dries007/ModernMasterMind/README.md

ModernMasterMind
================
College project E-ICT 1 - 2015

Information
-----------
The purpose of this project is to imitate the classic board game Mastermind with a web interface and an LED screen/display.
This project was developed with the help of the RIOT board, made by MGM & [dp].

This repository contains the source code and documentation for the 'Beck SC12' and 'AVR Atmega128A', information about the dual port memory usage, and more related items.

Some parts of this repository are in Dutch.

License
-------
This project's code is licensed under [the MIT License (MIT)](LICENSE).

Made for/in relation to an education at Thomas More Mechelen-Antwerpen vzw - Campus De Nayer - Professionele bachelor elektronica-ict
