dries007/ModernMasterMind/Flowcharts.docx

Beck SC12

AVR ATmega128A

Webui

DPRAM

LCD

LEDs
