dries007/ModernMasterMind/Verslag/Verslag_Dries_Kennes.pdf

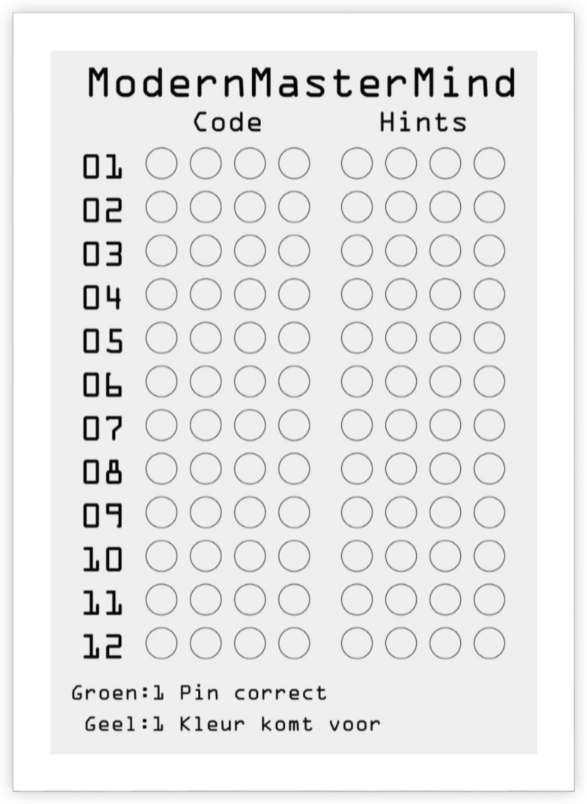
[picture p28: figure]

Dries Kennes | Project I | 2014-2015

# ModernMasterMind

## PROJECT I – ICT-ELEKTRONICA

## 1 Voorwoord

Ik ben Dries Kennes, student ICT-Elektronica Fase 1 aan Thomas More Mechelen op Campus De Nayer. Mijn voornaamste interesses zijn elektronica en alles wat te enigszins programmeren valt. Online ga ik door het leven als Dries007, een enthousiaste Java programmeur die zich in zijn vrije tijd vooral bezighoud met het maken van build-to-order Minecraft mods.

Tijdens de kerstvakantie ben ik op zoek gegaan naar projectonderwerpen. Vorig jaar (6e jaar middelbaar) wilden wij tijdens de lessen elektronica met een Arduino en een LED matrix spelletjes maken. Helaas was het juiste materiaal niet tijdig beschikbaar. Daarom heb ik er dit jaar voor gekozen om één van die spellen uit te werken. Het werd Mastermind omdat dit een uitdaging leek, onder andere dankzij de vereiste om kleuren te kunnen weergeven.

Mijn contacteren kan via email, dries.kennes@student.thomasmore.be, of via mijn website, dries007.net.

Ten slotte wil ik Marc Roggemans bedanken voor het uitlenen van materiaal en Jurre De Weerdt voor het helpen met solderen van enkele SMD onderdelen.

## 2 Inhoud

## 3 Hardware

## 3.1 RIOT

RIOT staat voor Remote Internet Operated Terminal, en is een ontwerp van M. Roggemans en
D. Pauwels. RIOT werd ontworpen als educatief platform in 2002, maar is eigenlijk nooit gebruikt. Meneer Roggemans heeft tijdens de lessen interfacetechnieken dit platform wel aangehaald, en zo kreeg ik interesse om dit te gebruiken. Ik kreeg toegang tot de bordjes na de examens na de kerstvakantie, zodat ik hiermee kon experimenteren, en zien of ze bruikbaar zouden zijn als basis voor mijn project. Het gebruiken van een 10+ jaar oud platform zorgt voor een aantal hindernissen, meer hierover in het hoofdstuk ‘De SC12 Software’.

Meer informatie over RIOT is beschikbaar op Telescript¹

## 3.2 Het basisprincipe

Het basisprincipe van RIOT (en dus ook mijn project) is dat 2 controllers met elkaar communiceren via een gedeeld geheugen (een Dual Port RAM, voortaan DP-RAM). Dit geheugen heeft een aantal ‘gewone’ adressen die vrij kunnen worden gebruikt, en 2 interrupt adressen. De interrupt adressen worden gebruikt om, zoals de naam al doet raden, van de ene controller naar de andere een interrupt te genereren. De controllers zijn een Beck SC12 en een AVR ATMega128A.

De reden voor het gebruiken van een dergelijk systeem is in dit geval de hoeveelheid IO verhogen. De SC12 heeft namelijk een zeer beperkte hoeveelheid IO, die vooral op pinnen zit die al door andere functies in gebruikt zijn (bijvoorbeeld UART of I²C). De SC12 heeft echter wel een gemultiplexte 8 bit data/adres bus, waarmee een extern geheugen van 256 bytes kan worden aangesproken. Door 2 IO pinnen te gebruiken als adres lijnen 8 en 9 kan het aanspreekbare geheugen worden uitgebreid tot 1kb (4 pages van 256 bytes).

Aangezien een Mastermind spelbord 12 rijen heeft van 8 gekleurde (RGB) pionnen, dit zijn in totaal dus 12 x 8 x 3 = 288 bytes is dit trucje geen overbodige luxe. Als men dan nog op een eenvoudige manier een LCD wil aansturen (20 karakters x 4 lijnen) heeft men nog eens 80 bytes nodig. Uiteindelijk zou 512 bytes genoeg zijn geweest, maar een DP-RAM chip met 1kb is commercieel beschikbaar, 512 bytes niet.

Aangezien de adres- en databus van beide controllers gemultiplext zijn, is het nodig om een adres latch te gebruiken. Ik gebruik 74AHC573 chips aangezien die aan de timingsspecificaties van de ATMega128A voldoen.

Voor de LEDs gebruik ik WS2812 LEDs. Deze LEDs zijn ideaal voor dit project omdat ze, ongeacht de hoeveelheid LEDs, maar 1 pin op een (relatief snelle) controller nodig hebben. Ze worden namelijk allemaal in serie geschakeld. De werking van het protocol wordt uitgelegd in het hoofdstuk ‘Het WS2812 protocol’.

1
ftp://193.191.150.44/pub/CD-Microcontrollers/RIOT/

## 3.3 De PCBs

Op mijn versie van het bord zijn onnodige onderdelen weggelaten. Onder andere de UART naar RS232, de Real Time Clock en het voedingscircuit moesten er aan geloven.

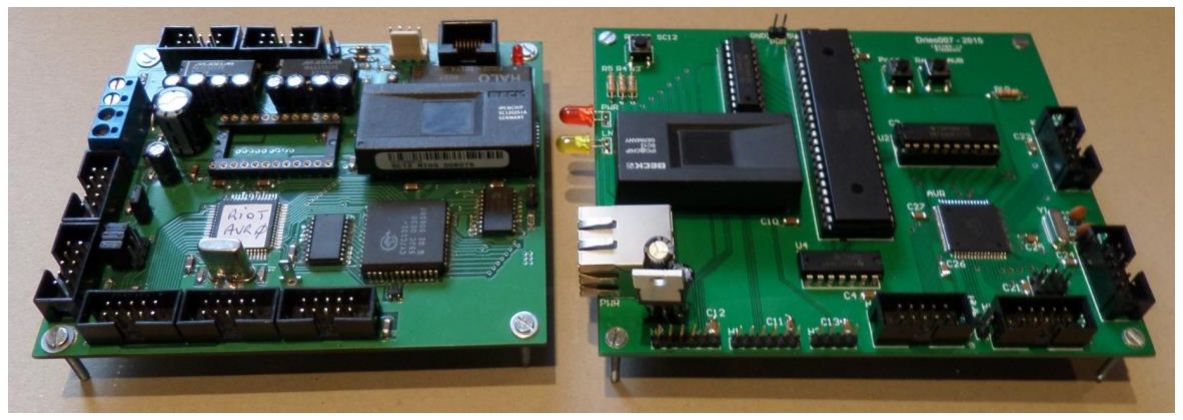
[picture p29: figure]

Figuur 3.1 RIOT links, Eigen PCB rechts

De PCBs zijn getekend met Altium. Het main bord en de LCD breakout zijn besteld bij Seedstudio, het LED panel bij multi-cb. De bestukking was manueel. De volgende fouten heb ik achteraf (tijdens het testen of solderen) ontdekt:

- De databus van het DP-RAM naar de AVR is in omgekeerde volgorde (de bits zitten omgekeerd).
- De WS2812 LEDs passen maar net op de getekende footprint, wat wil zeggen dat ze bijna onmogelijk met een gewone soldeerbout soldeerbaar zijn. Gelukkig heb ik op school hulp gekregen, en mocht ik een warme lucht soldeerstation gebruiken.

Het volledige schema en de layout van de PCBs is beschikbaar in de bijlage ‘PCB Schema’s & Layout’.

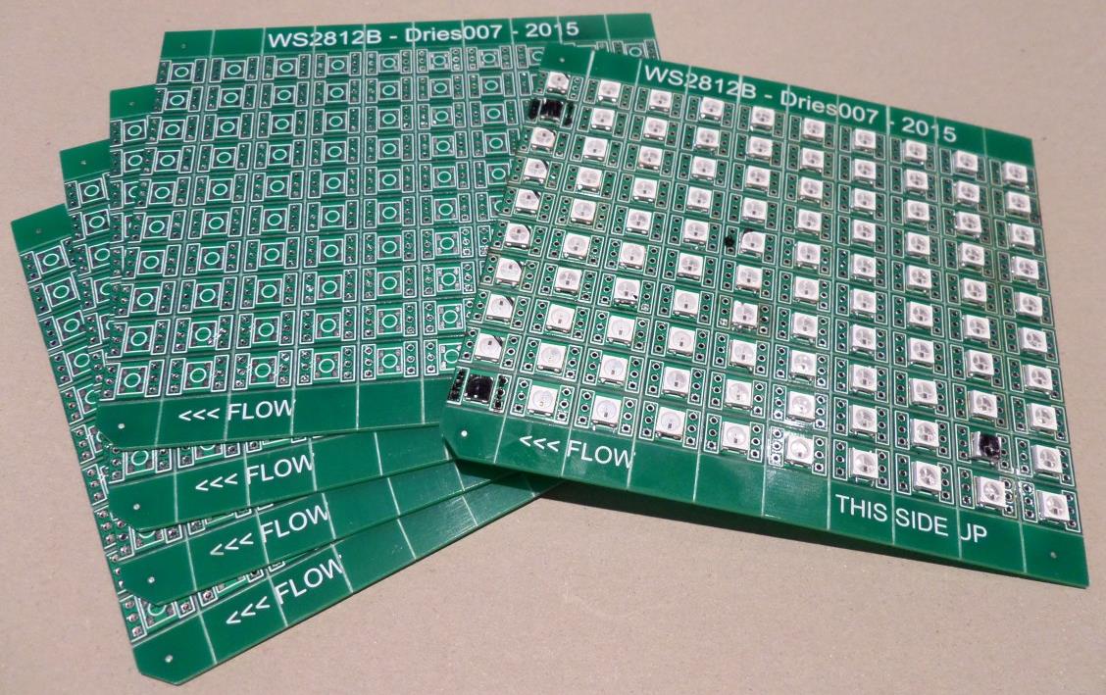
[picture p30: figure]

Figuur 3.2 Het LED panel

## 3.4 Overige onderdelen

Omdat de LEDs in totaal 96 x 60mA = 5,7 A verbruiken heb ik gekozen voor een commercieel verkrijgbare voeding van 35W.

De LCD module is een blauw alfanumeriek model, met een Hitachi HD44780 compatibele controller. De module zit op een zelf ontworpen printplaat die een 8 pin poort omzet naar de juiste pinout voor de LCD en nog wat extra plaats heeft voor het aansluiten van de achtergrondverlichting.

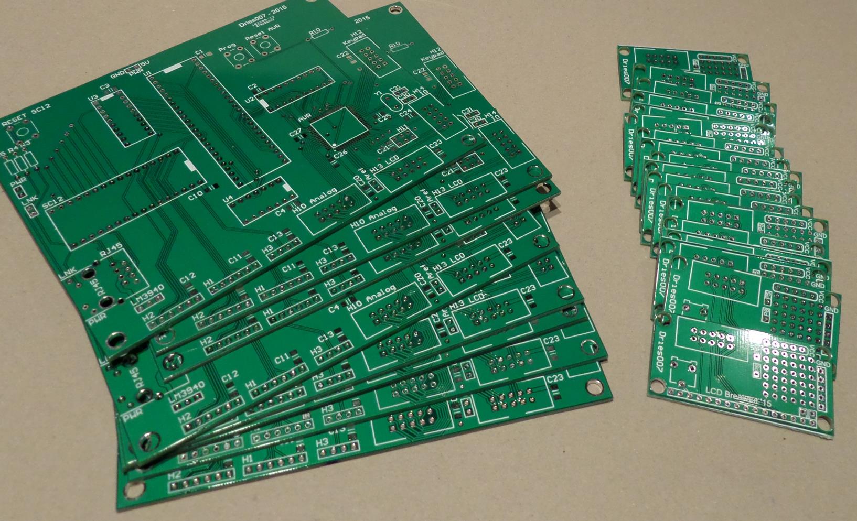
[picture p31: figure]

Figuur 3.3 Links: De hoofd printplaten. Rechts = De lcd printplaten

## 4 Software

## 4.1 De memory map

Dit is de verdeling van het DP-RAM. De 2 interrupt adressen liggen vast, namelijk 0x3FE en 0x3FF. Alle andere locaties zijn vrij gekozen.

Er is extra plaats voorzien bij de LED data en bij de LCD buffer om te vermijden dat die verplaatst zouden moeten worden indien er zich kleine veranderingen voordoen in de specificaties.

Adres Functie
0x000 -> 0x1FE | RGB data voor maximaal 170 LEDs
0x1FF | Aantal LEDs
0x200 -> 0x250 | LCD buffer (80 karakters)
0x251 | LCD commando
0x252 | LEDs dim
0x253 | Laatst ingedrukte toets op keypad†
0x254 -> 0x299 | Beschikbaar
0x300 & 0x301 | Firmware id (42 en 0x42 respectievelijk)
0x302 -> 0x3FD | Beschikbaar
0x3FE | Interrupt SC12 -> AVR
0x3FF | Interrupt AVR -> SC12†

Tabel 4.1 De geheugenallocatie van het DP-RAM †: enkel gebruikt voor debug

## 4.2 Het WS2812 protocol

De WS2812 LEDs werken als een lange serie schakeling, waarbij elke led de eerste 24 bits gebruikt om zijn kleur in te stellen. De andere bits worden doorgegeven, zie Figuur 4.1. De volgorde van de bits is niet RGB, maar GRB, met hoogste bit eerst.

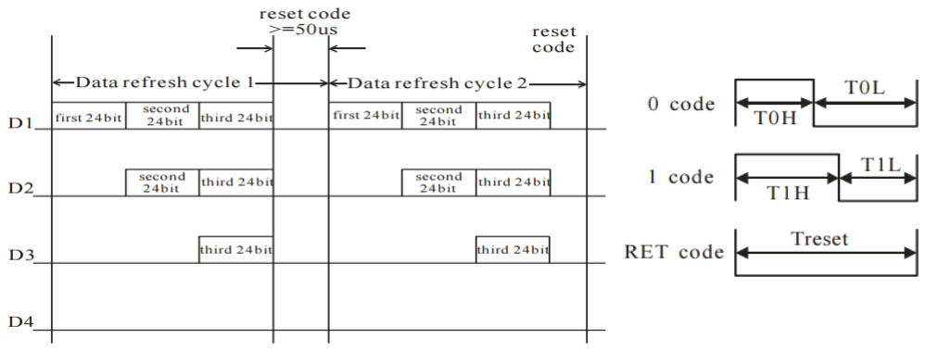
[picture p32: figure]

Figuur 4.1 LED cascading & timing diagram

Code | Betekenis | Tijd | Min | Typ | Max
T0H | 0 code - high voltage time | 0,35 µs ±150 ns | 200 ns | 350 ns | 500 ns
T1H | 1 code - high voltage time | 0,70 µs ±150 ns | 550 ns | 700 ns | 850 ns
T0L | 0 code - low voltage time | 0,80 µs ±150 ns | 650 ns | 800 ns | 950 ns
T1L | 1 code - low voltage time | 0,60 µs ±150 ns | 450 ns | 600 ns | 750 ns
Reset | low voltage time | > 50µs | 50 µs
TH+TL | Cyclus time | 1,25µs ±600ns | 660 ns | 1250 ns | 1850 ns

Tabel 4.2 De timing tabel uit de datasheet, met genormaliseerde waarden

De software driver die vaak voor de ze LEDs word gebruikt (Adafruit NeoPixel Library²
) is
ingewikkeld, geschreven in C++ en geschikt voor zowel 8, 12 als 16 MHz Arduino’s. Na verder zoeken vond ik een aantal interessante artikels³ die de timing van de LEDs analyseren.

Uit hun analyse blijkt dat de timing eigenlijk niet zo restrictief is als lijkt uit de datasheet. De enige kritieke tijd blijkt T0H te zijn, en die is net haalbaar op 4MHz (500ns * 4MHz = 2 klokcycli). Alle andere timing restricties zijn langer, en kunnen dus met nops worden ingevuld.

Uiteindelijk heb ik ervoor gekozen een aangepaste versie van de light_ws2812 library⁴
te
gebruiken. Dit is de code die word beschreven in een van de artikels. Ze is simpel en
eenvoudig te begrijpen. De driver word verder beschreven in De WS2812 driver.

2 github.com/adafruit/Adafruit_NeoPixel
3 wp.josh.com/2014/05/13/ws2812 en cpldcpu.wordpress.com/2014/01/14/light_ws2812-4 github.com/cpldcpu/light_ws2812/tree/master/light_ws2812_AVR/Light_WS2812

## 4.3 De AVR software

De software in de AVR is geschreven in C, met uitzondering van de WS2812 driver die in inline assembly is geschreven. Voor de gebruiksvriendelijkheid zijn alle configuratie opties bovenaan in de header file als macro’s gedefinieerd. De code is voorzien van commentaar en sectie aanduidingen om groepen van bij elkaar horende functies te groeperen. De volledige header-en codebestanden zijn terug te vinden in de bijlage als respectievelijk ‘AVR.h’ en ‘AVR.c’. De regelnummers hieronder zijn, tenzij anders aangegeven, deel van ‘AVR.c’.

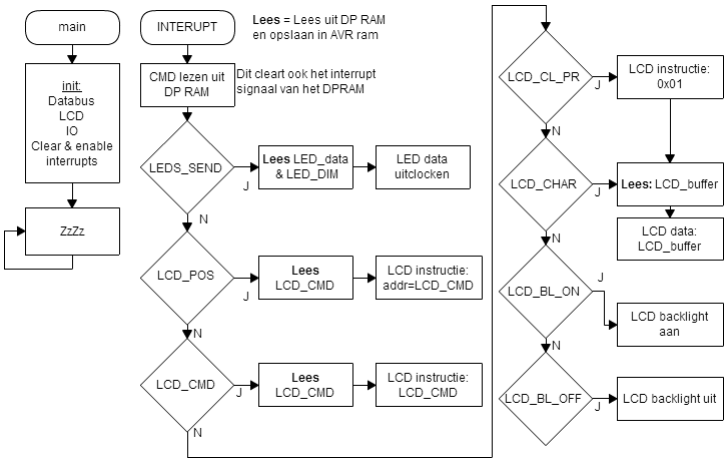
[picture p33: figure]

Figuur 4.2 De AVR flowchart

### 4.3.1 Het hoofdprogramma (main)

Het hoofdprogramma in de AVR doet niet veel meer dan een aantal initialisaties en wacht dan om een interrupt van het DP-RAM.

- De externe memory interface (adres- en databus) wordt ingeschakeld. R259
- De Firmware ID adressen in het DP-RAM worden op 42 en 0x42 gezet. R262-263
- De LCD poort word ingesteld als uitgang. R266
- De LED pin word ingesteld als uitgang. R272-273
- Externe interrupt 4 word geconfigureerd. R276-277
- De LCD word geïnitialiseerd in 4 bit mode. R279-294
- Lees DP-RAM 0x3FE om mogelijke interrupt te resetten. R297
- Schakel interrupts in.

Dan gaat het programma in een lus, wachtend op een interrupt.

### 4.3.2 De interrupt routine

Deze interrupt routine voert uit wanneer de DP-RAM een schrijf instructie heeft verwerkt naar het adres 0x3FE vanuit de SC12. Hoe de AVR juist reageert is afhankelijk van wat er naar dit adres geschreven wordt. Aangezien het hoofdprogramma niets doet in dit project, is het geen enkel probleem om in de interrupt routine software delays te gebruiken.

Waarde Functie
0x00 | Geen functie
0x01 | Update LEDs
0x02 | Print LCD karakter buffer (tot max of 0x00)
0x03 | Stuur LCD instructie
0x04 | Stuur clear instructie en print LCD karakter buffer
0x05 | Zet LCD cursor positie op LCD commando
0x06 | LCD backlight aan
0x07 | LCD backlight uit

Tabel 4.3 De commando’s van de SC12 naar de AVR

4.3.2.1 0x00 of een waarde die niet voorkomt in de tabel– Geen functie

De null byte (0x00) is expliciet gereserveerd om niets te doen (buiten het activeren van mogelijke debug code). Alle andere combinaties kunnen worden gebruikt voor extra functies.

4.3.2.2 0x01 – Update LEDs

- Lees aantal LEDs. R24
- Lees LED dimmer waarde. (0xFF = volle sterkte) R26
- Check aantal LEDs met logisch maximum bepaald door geheugen allocatie. R28
- Loop over de volgende instructies voor elke LED: R30-31
| • Voor 3 x LED kleur (rood, groen en blauw): R33 & 34 & 35 ▪ Lees volgende byte uit LED data in DP-RAM. ▪ Voer logische AND uit op die byte en LED dimmer waarde. ▪ Sla waarde op in LED data array
- Geef deze data door aan de WS2812 driver. R38

4.3.2.3 0x02 – Print LCD karakter buffer

- Loop over de volgende instructies tot het einde van de karakter buffer: R63
| • Lees volgende byte uit karakter buffer in DP-RAM. R65 • Als karakter een 0x00 byte is, beëindig de lus onmiddellijk. R66 • Stuur de byte naar de LCD driver. R67

4.3.2.4 0x03 – Stuur LCD instructie

- Lees LCD commando byte uit DP-RAM en stuur die naar de LCD driver. R50

4.3.2.5 0x04 – Stuur clear instructie en print LCD karakter buffer

- Stuur een clear & home instructie (0x01) naar LCD driver. R56
- Wacht 10ms. R57

- Voer de code uit die bij 0x02 – Print LCD karakter buffer hoort. R59

4.3.2.6 0x05 – Zet LCD cursor positie op LCD commando

Aangezien een positie instructie er zo uitziet: “1aaa aaaa” Waarbij de a’s staan voor een positie op de LCD, kan men een positie byte met een logische OR omzetten naar de juiste instructie:

- Lees LCD commando byte uit DP-RAM, OR met 0x80, stuur naar LCD driver. R44

4.3.2.7 0x06 of 0x07 –LCD backlight aan of uit

Dit commando zet een interne byte op 1 of 0, respectievelijk voor aan en uit. De volgende keer dat er iets met de LCD driver word gedaan, heeft de verandering effect.

### 4.3.3 De LCD driver

De LCD driver bestaat uit een aantal subroutines, aangezien de LCD in 4 bit bus mode wordt gebruikt. De instructie of data bytes moeten dus in 2 x 4bit nibbles worden gesplitst en dan pas verzonden.

De volgende stappen worden doorlopen bij het versturen van 1 nibbel:

- Filter de data zodat enkel de laatste 4 bits overblijven. R440
- Als het LCD backlight aan moet, set de 8e bit op 1. R442
- Als het een instructie is, zet de 6e bit op 1. R444
- Zet de data op de LCD port. R448
- Wacht 800µs. R450
- Toggel de enable pin. R452
- Wacht 800µs. R454

### 4.3.4 Debug code

In de broncode staan ook nog delen debug code die tijdens het opbouwen van dit project werden gebruikt om zonder de hulp van de SC12 de LED en LCD drivers te kunnen testen.

Zo staat er onder ander een volledige matrix keypad met debounce subroutine, in die bedoeld is om als main programma te draaien.

Aangezien die niet in gebruik is in het eindproduct, en de code voorzien is van commentaar, wordt ze hier niet verder besproken.

Meer details in onder andere:

- R83 tot R184 voor een test aansturing van de LEDs,
- R192 tot R247 voor de matrix keypad uitlezing met debounce,
- R302 tot R328 voor de omzetting van matrix naar ASCII.

### 4.3.5 De WS2812 driver

In de header file AVR.h wordt berekend hoeveel klokcycli de CPU niets zal moeten doen tussen het toggelen van de LED pin. Deze berekening gebeurd in AVR.h R88-160 en is afhankelijk van de klokfrequentie van de AVR. Daarom is het belangrijk dat deze correct word ingesteld in de compiler settings. Deze vooraf berekende waarden worden w1_nops, w2_nops, w3_nops en w4_nops genoemd, hoewel het niet enkel NOP instructies bevat. Men kan namelijk 2 sequentiële NOP instructies vervangen door 1 RJMP instructie met een offset van 0. Dit komt de programmagrootte te goed.

De volgende stappen worden doorlopen bij het verzender van data naar de LEDs:

- Bepaal de totale lengte in bytes van de te verzenden data. R345
- Zet de data om van de GRB struct naar bytes. R347
- Sla huidige interrupt instellingen op. R350
- Zet verdere interrupts uit. R352
- Bepaal de high en low masks (maskhi & masklo) voor de LED poort. R354-358
- Voor elke byte in de totale lengte: R362
- Neem volgende data byte. R364
Hier start de inline ASM
- Laad 8 in loopcounter (8 bits in een byte). R367
- Loop label. R368
- Zet maskhi op LED poort. (Toggelt de LED pin hoog) R370
- Vooraf bepaald aantal NOPs w1_nops. R371-385
- Sla de volgende instructie over als de 7e bit van de data 1 is. R386
- Zet masklo op LED poort. (Toggelt de LED pin laag) R370
- Shift data naar links R389
- Vooraf bepaald aantal NOPs w2_nops. R390-404
- Zet masklo op LED poort. (Toggelt de LED pin laag) R405
- Vooraf bepaald aantal NOPs w3_nops. R406-420
- Verminder loopcounter met 1. R421
- Als loopcounter niet 0 is, spring terug naar Loop label. R423 Einde inline ASM
- Herstel de interrupt instellingen. R432
- Wacht 50µs (om andere data op de LED pin te vermijden) R433.

## 4.4 De SC12 Software

De software in de SC12 is ook geschreven in C, maar omdat er geen IDE voor is, gebruikte ik Eclipse Cpp. De compiler was een groter probleem, aangezien deze controller uit 2002 komt. In de documentatie van de fabrikant word verwezen naar Borland C, maar die draait niet op een 64bit host machine, en ondersteund geen moderne versie van de C standaard. Dit maakt ermee programmeren enkel mogelijk in een virtual machine, en met de verouderde C structuur.

Na een zoektochtje op het internet⁵ kwam ik OpenWatcom tegen. OpenWatcom ondersteund ook geen 16 bit target op een 64 bit Windows machine, maar wel op Linux. Ik heb een Linux server ter beschikking, en een script om vanuit Eclipse een nieuwe versie te uploaden, compilen en naar de SC12 te sturen is snel geschreven. De scripts die ik heb gebruikt zijn beschikbaar in de bijlage ‘Scripts’.

Een belangrijk nadeel van OpenWatcom, waar ik pas helemaal op het einde van mijn project ben achter gekomen is dat de manier waarop interrupt routines worden gedefinieerd anders zijn. Ik ben hierover geen duidelijkheid gevonden, en kan dus geen interrupt van de AVR naar SC12 correct opvangen.

Een ander handig stukje software is ChipTool⁶
. Dit tooltje laat je toe om het IP adres van een SC12 chip in te stellen door middel van UDP packets. Ook het uploaden van de laatste versie van hun firmware word zo eenvoudig. Chiptool heeft een ingebouwde telnet en FTP client, maar deze zijn niets in vergelijking met modernere versies van zulke programma’s zoals PuTTY of FileZilla.

De uitbreiding van de standaard C library die bij deze controller hoort is cLib. De
documentatie hiervan is beschikbaar op www.beck-ipc.com. Hier zijn ook voorbeeldprogramma’s en programmer guidlines beschikbaar.

Aangezien er een real time besturingssysteem draait op de SC12 kunnen er meerdere taken tegelijk worden uitgevoerd. Dit zijn de standaard taken: een ftp server, een telnet server, een webserver en een udp configuratie server.

De standaard webserver heeft enkel een welkompagina (/) en een statuspagina (/ChipCfg) beschikbaar. Via cLib functies kunnen zonder veel moeite extra ‘pagina’s’ worden toegevoegd. Bestanden die worden geüpload naar het flash geheugen kunnen ook worden opgevraagd als URL. Het probleem met dit is dat het dan moeilijker word om programmatisch het gedrag van de controller aan te passen. In dit project staat dus de volledige code van de webpagina’s, inclusief de CSS style sheet, gecomprimeerd in de C code. Omdat dit bijna onleesbaar is heb ik in de bijlage ‘HTML Template’ het origineel template bijgevoegd.

De flowcharts op de volgende pagina worden verder in detail uitgelegd in de volgende onderdelen. De regelnummers daarin duiden op ‘mastermind.c’.

5
stackoverflow.com/questions/227762/looking-for-16-bit-x86-compiler 6 beck-ipc.com/en/products/sc1x/sc13.asp

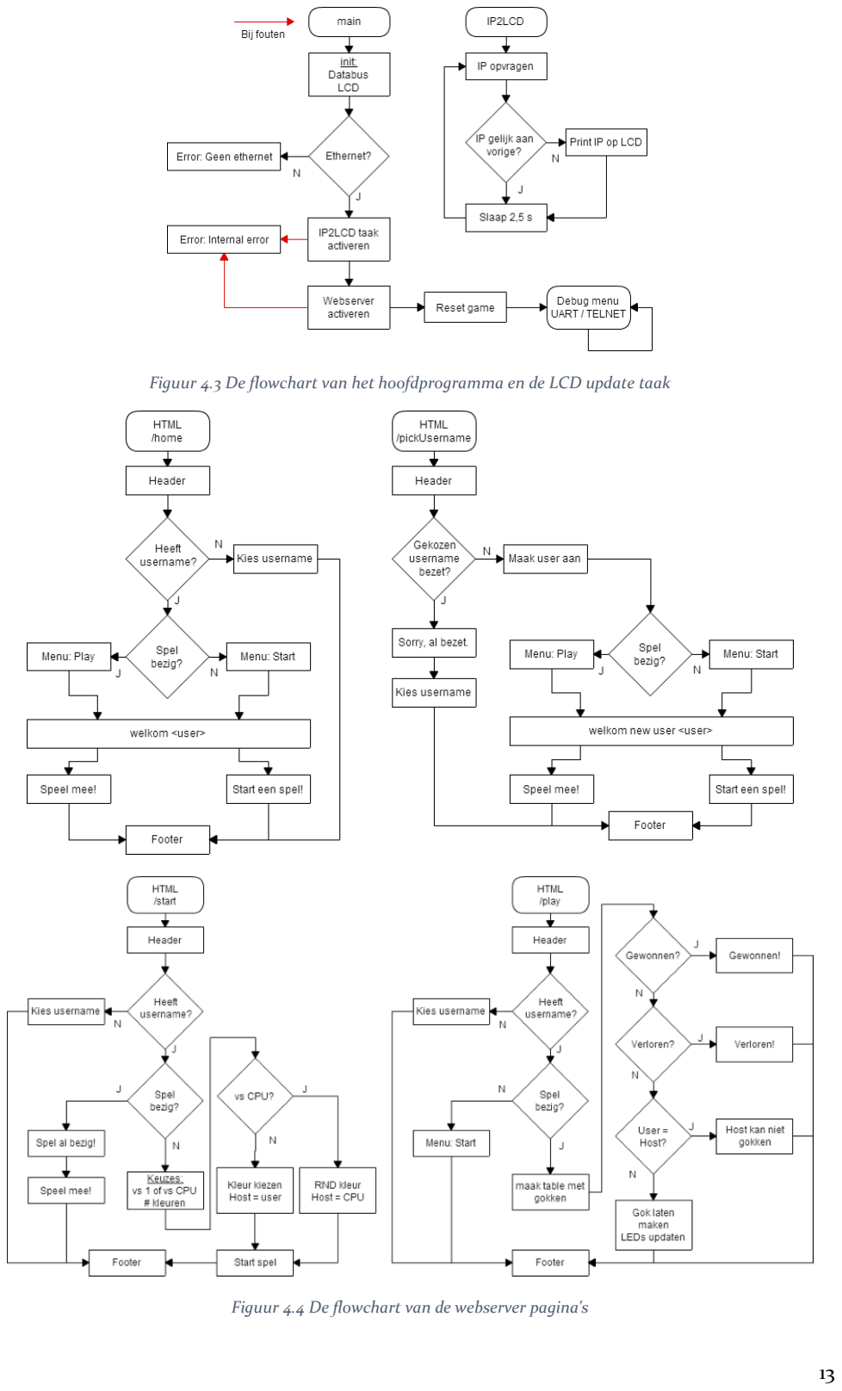
[picture p34: page 14]

Figuur 4.3 De flowchart van het hoofdprogramma en de LCD update taak

Figuur 4.4 De flowchart van de webserver pagina's

### 4.4.1 Het hoofdprogramma

- Activeer het programma als focus. R439
Zorgt ervoor dat er input kan worden gegeven, en dat de controller ook effectief wacht bij een input instructie.
- Initialiseren van de databus. R444
8 bit met ALE, Chip select 1 word geactiveerd en IO2 en 3 zijn output R132-135
- Vaste instellingen worden in het DP-RAM geladen:
- LCD backlight aan, R446
- LED Dim op 100% (0xFF), R448
- Aantal LEDs op 2 * 12 * 4 = 96, R449
- LCD commando’s worden uitgevoerd:
- Blink uit, R451
- Clear lcd en cursor reset. R452
- AVR Firmware naar console. R456
- Status melding naar LCD. R459
- De ethernet status word gecontroleerd.
Bij een fout (geen kabel?):
- Melding naar LCD. R464-465
- Voer eeuwig testcode uit.(zie debug menu hieronder) R467-470
- Start de taken op die in de achtergrond moeten draaien. R478-486 Enkel IP2LCD, maar kan eenvoudig worde uitgebreid.
- Configureer de webserver R992-1021
- Reset de status van het spel. Komt later nog aan bod.
- Geef een debug/console menu weer. R502-543
Dit wordt oneindig herhaald, en bied o.a. de mogelijkheid om:
- Het programma beëindigen, R372-391
- De controller herstarten,R522
- Het DP-RAM dumpen, R20-60 van ramdump.c
- Een adres van het DP-RAM op een waarde zetten, R1-20 van ramdump.c
- De status van het spel dumpen, R413-434
- De gebruikerstabel dumpen, R53-72
- Testcode uitvoeren, R393-411
Deze code toont een semi random patroon van kleuren op het led scherm.

### 4.4.2 IP2LCD

Deze taak zorgt ervoor dat het IP adres op de LCD verschijnt, en up-to-date is.

- Vraag het IP op. R342
- Vergelijk het nieuwe IP met het vorige IP. R344
Als ze niet gelijk zijn, print het nieuwe IP naar de LCD.
- Wacht 2,5 seconden. R349

### 4.4.3 De webpagina’s

De webpagina’s worden opgebouwd er naar de juiste url te surfen. De mogelijke urls zijn: “/home”, “/pickUsername”, “/start”, “/play”, “/reset”. Om verschillende gebruikers te identificeren wordt het IP adres aan een username gekoppeld.

Alle pagina’s hebben een header en footer. Die zijn in de gedetailleerde weergave hieronder niet toegevoegd omdat ze altijd hetzelftde zijn.

4.4.3.1 /home

Dit is de standaard locatie van de webserver.

- Gekende gebruiker?
| • Neen ▪ Voeg leeg menu toe. R630 ▪ Voeg pickusername template toe. R631 • Ja ▪ Is spel bezig?
- Ja: Voeg menu toe met optie “play”. R635
- Neen: Voeg menu toe met optie “start”. R637
| ▪ Voeg welkom toe aan pagina. R639-641

4.4.3.2 /pickUsername

Deze url word gebruikt om de POST response van het pickUsername template af te handelen.

- Vind argument “username”: R668-670
| • Komt er al een user met die naam voor? R672 ▪ Ja
- Voeg leeg menu toe. R674
- Voeg melding toe, met pickUsername formulier. R676-681
| ▪ Neen
- Voeg user toe aan lijst. R685
- Is spel bezig?
- Ja: Voeg menu toe met optie “play”. R687
- Neen: Voeg menu toe met optie “start”. R689
- Voeg boodschap toe. R691-693

4.4.3.3 /reset

Pagina word gebruikt om spel te herstarten. Kan enkel worden uitgevoerd bij einde spel.

- Nieuwer gebruiker?
| • Voeg leeg menu toe. R630 • Voeg pickusername template toe. R631
- Spel status:
| • Gameover of gewonnen: R971 ▪ Reset spel & geef boodschap weer. • Andere: R979 ▪ Error boodschap.

4.4.3.4 /start

Dit is de pagina die gebruikt word om een spel te starten

- Nieuwer gebruiker?
- Voeg leeg menu toe. R630
- Voeg pickusername template toe. R631 Einde van de functie.
- Spel al bezig?
- Voeg menu toe met optie “play”. R810
- Voeg boodschap toe. R811
Einde van de functie.
- Zoek argument “mode”. R737
- Zet spel eigenschap “vsPlayer”. R739
- Zet spel status op deels geconfigureerd.
- Zoek argument “colors”. R742
- Zet spel eigenschap “colors” op aantal kleuren. R744
- Zet spel status op gestart.
- Overige argumenten:
- Zet overeenkomstige code pin op kleur. R749-751
- Zet spel status op spel gestart. R752
- Spel status:
- Deels geconfigureerd? R756
- Spel in vsPlayer mode? R759
- Ja
- Set game host op huidige user. R761
- Voeg leeg menu toe. R762
- Voeg “kies code” formulier toe. R765-780
- Neen
- Voeg menu toe met optie “play”. R784
- Stel random kleur in. R189-196
- Zet spel status op gestart. R787
- Gestart? R790
- Voeg menu toe met optie “play”. R792
- Gereset? R795
- Voeg leeg menu toe. R797
- Voeg “nieuw spel” formulier toe. R798-805

4.4.3.5 /play

Dit is de belangrijkste pagina, gebruikt voor het spelen van het spel.

- Nieuwer gebruiker?
- Voeg leeg menu toe. R630
- Voeg pickusername template toe. R631
Einde van de functie.
- Spel status: Nog niet gestart?
- Voeg menu toe met optie “start”. R844 Einde van de functie

- Voeg leeg menu toe
- Spel status: Spel gestart R851
- Zoek argumenten van de gok kleur
- (1 keer) Verhoog aantal gokken R863
- Stel gok in. R864
- Als er een gok is geweest: Bereken de hints voor de gok. R866 Gebruikt subroutine die hieronder is verklaard.
- Maak tabel met gokken. R869-895
- Spel status?
- Game over
- Voeg boodschap toe. R900
- Game won
- Voeg boodschap toe. R905
- Is spel host huidige speler? R909
- Voeg boodschap toe. R911
- Spel gestart
- Voeg “gok” formulier toe. R917-R935
- Anders?
- Code nog niet gekozen. R940

4.4.3.5.1 Gok subroutine

Deze subroutine verwerkt een gok. Een ‘pin’ is een van de 4 plaatsen in de code/gok. ‘In gebruik’ wil zeggen dat deze plaats (in de code) reeds is gebruikt om een hint te geven.

- Is het aantal gokken gelijk aan of groter dan 12? R200
- Zet spel status op Game over. R202
| Einde van de functie
- Voor alle 4 pinnen in de gok: R209
- Komt pin overeen met zelfde positie in code? R212
| ▪ Ja • Is pin al ‘in gebruik’? R214
- Aantal kleur matchen verminderen. R216
| • Zet pin op ‘in gebruik’. R219 • Verhoog aantal exacte matchen. R220 • Is aantal exacte matchen 4? R221
- Zet spel status op Game won R223
| ▪ Neen • Voor alle 4 posities in de code: R228
- Komt de gok pin overeen met deze code pin en is de code pin nog niet gebruikt? R230
- Zet pin op ‘in gebruik’. R232
- Verhoog aantal kleur matchen. R233
Einde 2e
lus.
- Stuur LED informatie uit. R152-162

## 5 Budget

Dit zijn de kosten aan dit project:

Naam Kostprijs

100 x WS2812 Breakout print | € 23
LCD module | € 7
LCD Breakout | € 1
Main PCB | € 8
100 x WS2812b | € 12
35W 5V PSU | € 10
1kbyte DPRAM | € 7,5
AVR ATMega128A | € 8,5
Ethernet Magjack | € 3
Kader | € 15
Andere componenten | € 15

Totaal € 110

## 6 Besluit

Na 10 weken werken aan mijn project heb ik veel geleerd. Gaande van het feit dat een goede planning maken tijd kost en niet eenvoudig is tot hoe fijn het kan voelen om je eigen spel te verslaan. Maar ik vind het een geslaagd project.

Omdat ik ben gestart van een bestaand platform heeft de hardware, met uitzondering van de LEDs, mij niet zo veel moeite gekost. De software was nog meer werk dan eerst geschat.

Volgende keer zal ik er wel 2 keer over nadenken om individuele SMD LEDs te gebruiken die moeilijk soldeerbaar zijn, zeker als het er 100 zijn.

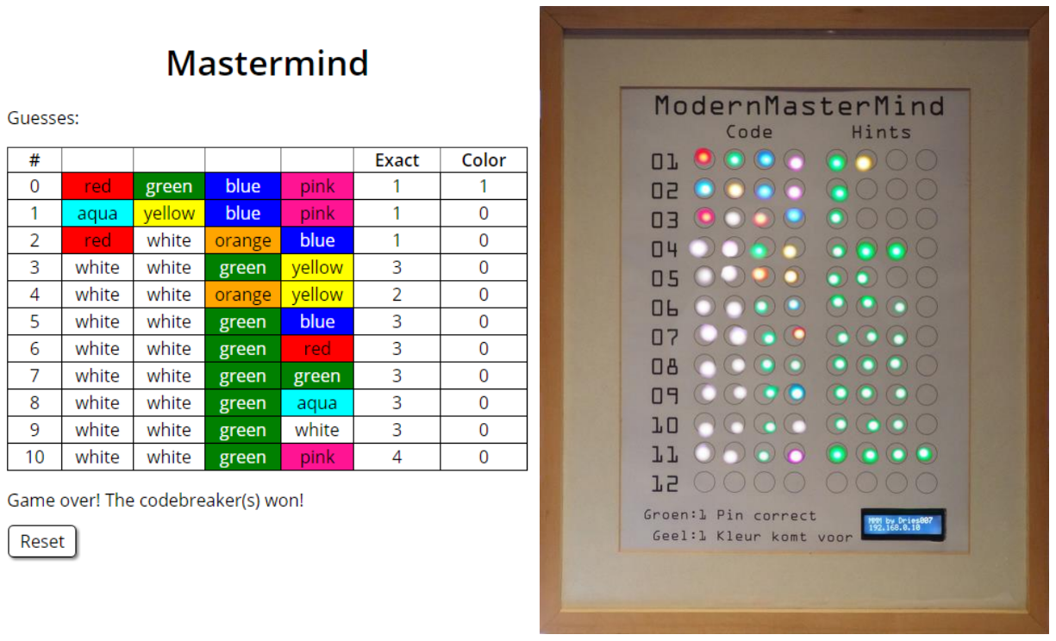
[picture p35: figure]

Figuur 6.1 Het eindresultaat

## 7 Bijlagen

## 7.1 PCB Schema’s & Layout

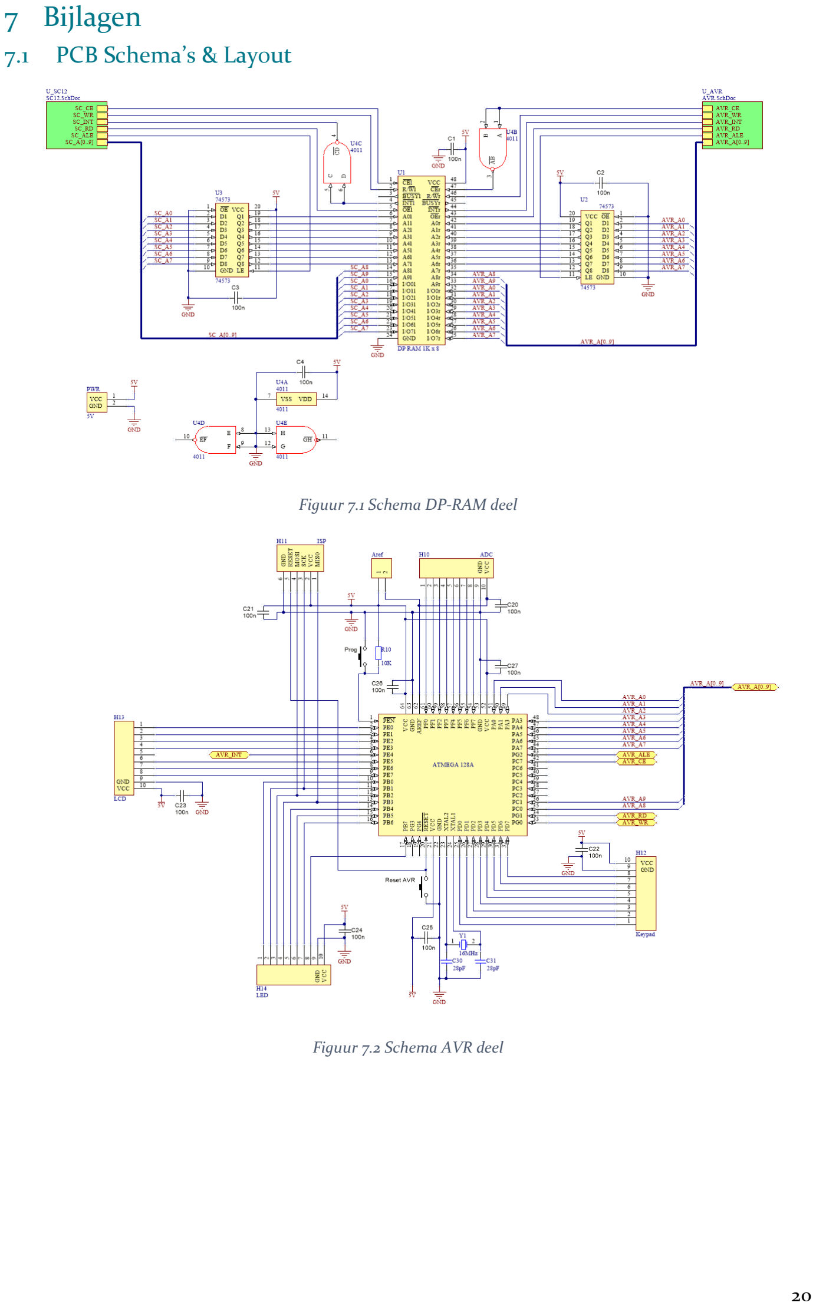
[picture p36: page 21]

Figuur 7.1 Schema DP-RAM deel

Figuur 7.2 Schema AVR deel

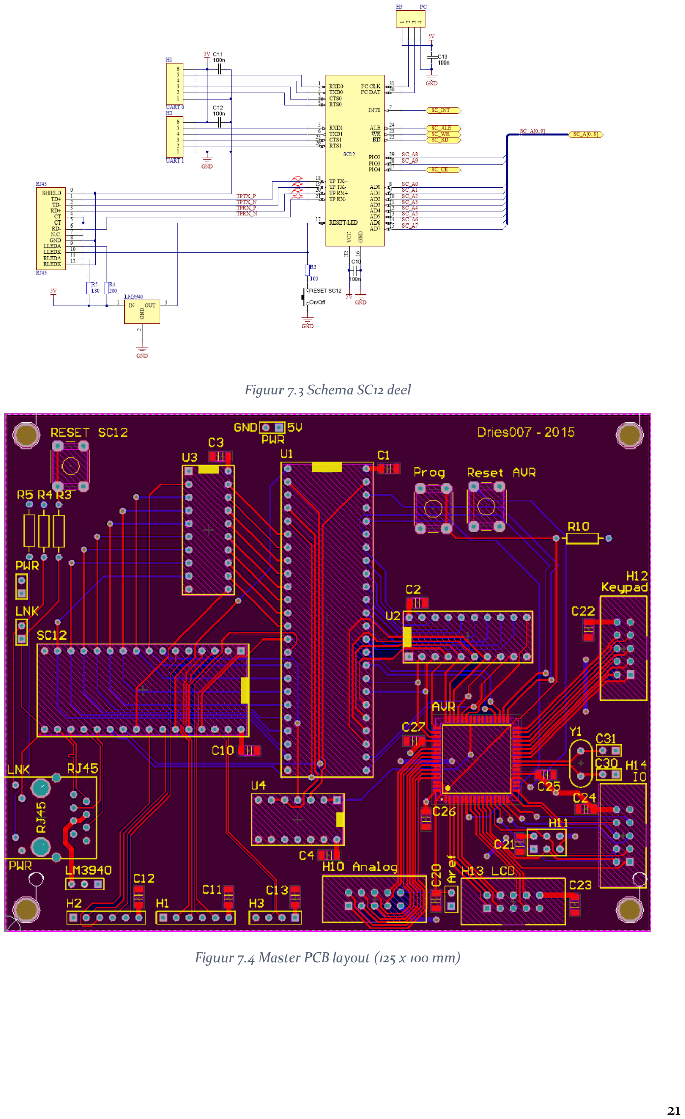
[picture p37: page 22]

Figuur 7.3 Schema SC12 deel

Figuur 7.4 Master PCB layout (125 x 100 mm)

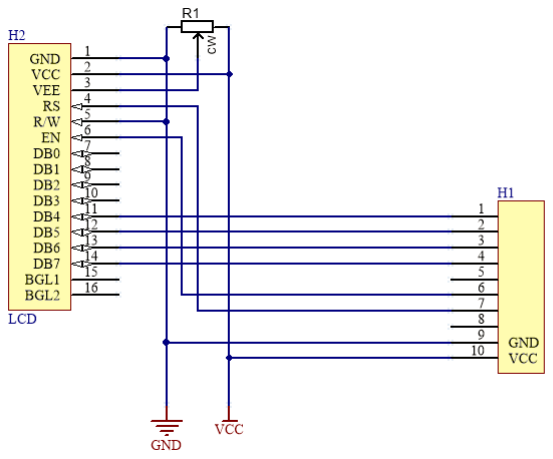
[picture p38: figure]

Figuur 7.5 Schema LCD-Breakout

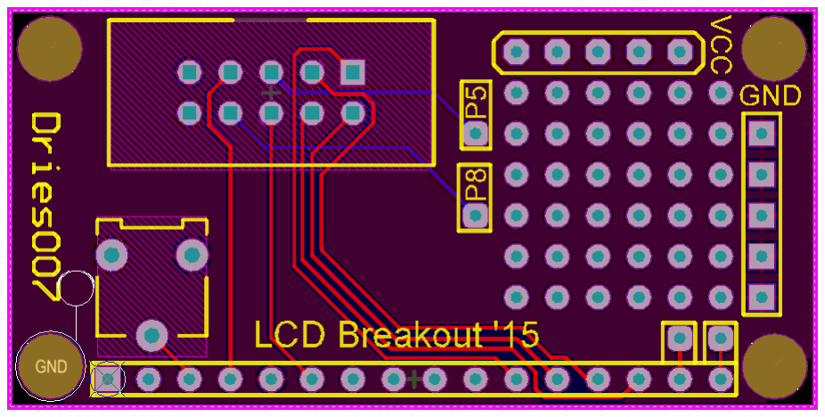
[picture p39: figure]

Figuur 7.6 LCD-Breakout PCB layout (50 x 25 mm)

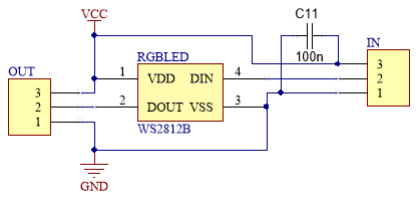
[picture p40: figure]

Figuur 7.7 WS2812B Schema

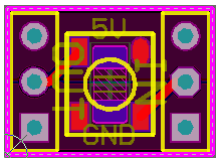
[picture p41: figure]

Figuur 7.8 WS2812B Layout (11 x 8 mm)

## 7.2 Scripts

In dit project worden 2 scripts gebruikt:

- make.bat draait op Windows en wordt vanuit Eclipse Cpp aangeroepen,
- compile.sh draait op Linux en voert het compilen en uploaden naar de SC12 uit.

Dit zijn slechts template files, ze moeten worden aangepast aan de omgeving waarin ze worden gebruikt.

Variabelen zijn aangegeven als //naam of verklaring//.

Dit zijn de benodigdheden om de scripts te kunnen gebruiken:

On Windows:
- //network path to SC12 folder on Linux//
- //.ppk key for passwordless access to the Liunux box//
- plink.exe in path !! (part of PuTTY SSH and telnet client)
- //eclipse source folder//:
- make.bat
- alle .c en .h bestanden
On Linux:
- //OpenWatcom installatie path//
- //Beck cLib installation path//
- //user directory//:
- sc12:
compile.sh
SC12 needs to be on & responding for the upload to work!

### 7.2.1 make.bat

@echo off
rem Load ssh key
//load .ppk for ssh session//

rem delete old source files
del /Q // network path to SC12 folder on Linux //*.h del /Q // network path to SC12 folder on Linux //*.c

rem copy over new source files
copy /B /Y *.c // network path to SC12 folder on Linux // copy /B /Y *.h // network path to SC12 folder on Linux //

rem open ssh session and execute commands
plink -batch -ssh //user@host// "cd sc12; sh compile.sh

### 7.2.2 compile.sh

#!/usr/bin/sh

# Setup env

export WATCOM=//openwatcom install location// export PATH=$WATCOM/binl:$PATH
export BECKCLIB=//beck clib install location//
export INCLUDE=$WATCOM/h:$BECKCLIB/includes
export LIB=$WATCOM/lib286/dos:$WATCOM/lib286:$BECKCLIB/lib #export EDPATH=$WATCOM/eddat
#export WIPFC=$WATCOM/wipfc

# Compile script

rm -r watcomTEMP
mkdir watcomTEMP
cp *.c watcomTEMP
cp *.h watcomTEMP
cd watcomTEMP

echo "All C files:"
echo "------------"
find -name '*.c' -exec basename {} \;
echo "------------"

wcl -w4 -s -zp1 -d0 -od -fpr -zu -1 -ml -za99 -bcl=dos -bt=dos -lr -l=dos -i=$INCLUDE *.c clib260h.lib -fe=main.exe

if ls *.exe 1> /dev/null 2>&1; then
echo "All EXE files:"
echo "------------"
find -name '*.exe' -exec basename {} \; echo "------------"
else
echo "NO EXE FILES. Error"
exit 1
fi

find -name '*.exe' -exec basename {} \; > AUTOEXEC.BAT

ftp -pvn <<EOF
open //IP of SC12//
user ftp ftp
binary
put *.exe
put AUTOEXEC.BAT
EOF

{
echo "tel";
echo "tel";
echo "reboot";
sleep 1;
} | telnet //IP of SC12//

cd ..

## 7.3 Broncode

De volledige broncode is ook beschikbaar op github.com/dries007/ModernMasterMind.

Mastermind.c draait op de SC12, AVR.c op de ATMega128.

Het originele HTML template is ook toegevoegd, aangezien dit gecomprimeerd bijna onleesbaaar is.

De cLib library die bij mastermind.h code hoord is beschikbaar op www.beck-ipc.com.

7.3.1 | mastermind.h
1 | #ifndef SRC_MASTERMIND_H_
2 | #define SRC_MASTERMIND_H_
3
4 #pragma option -1 //create 80186 code 5
6 | #include <clib.h>
7 | #include <stdio.h>
8 | #include <stdlib.h>
9 | #include <string.h>
10 | #include <limits.h>
11 | #include <dos.h>
12 | #include <stdarg.h>
13 | #include <ctype.h>
14 | #include <rtos.h>
15 | #include <i86.h>
16
17 | #include "ramdump.h"
18 | #include "httpcli.h"
19 | #include "base64.h"
20 | #include "dns.h"
21
22 /* ================= DEFINES ================= */ 23
24 #define DEBUG 0
25
26 | #define VERSION "0.2"
27 | #define CYEAR "15"
28
29 #define TASK_STACKSIZE 2048 30
31 #define TCPIP_int 0xAC
32
33 | #define LCD_LINE_SIZE 16
34 | #define LCD_LINES 2
35
36 | #define MAX_COLORS 8
37 | #define COLORS 4
38 | #define ROWS 12
39
40 | #define STATE_NO_GAME 0
41 | #define STATE_GAME_CONFIGURED 1
42 | #define STATE_GAME_STARTED 2
43 | #define STATE_GAME_OVER 3
44 | #define STATE_GAME_WON 4
45
46 | // amount of (positive) hours offset from GMT
47 | #define TIMEZONE_OFFSET 2
48
49 | // 170 Leds max (x 3 bytes = 0x1FE)
50 | #define RAM_LEDS_START 0x000
51 | #define RAM_LEDS_END | 0x1FE
52 | #define RAM_LEDS_AMOUNT 0x1FF

53 | // 80 bytes of char buffer for LCD
54 | #define RAM_LCD_START | 0x200
55 | #define RAM_LCD_END | 0x250
56 | #define RAM_LCD_CMD | 0x251
57 | // Mask for global LED dimming
58 | #define RAM_LEDS_DIM | 0x252
59
#define RAM_KP_LASTKEY 0x253 60

61 | #define RAM_VERSION_1 | 0x300
62 | #define RAM_VERSION_2 | 0x301
63
64 | // Interrupt registers
65 | #define RAM_INT_SEND | 0x3FF
66 | #define RAM_INT_GET | 0x3FE
67
68 | #define MAX_LEDS | (RAM_LEDS_END
- RAM_LEDS_START)
69 | #define MAX_LCD_CHARS | (RAM_LCD_END
- RAM_LCD_START)
70
71 | #define CMD_LEDS_SEND | 0x01
72 | #define CMD_LCD_CHAR | 0x02
73 | #define CMD_LCD_CMD | 0x03
74 | #define CMD_LCD_CL_PR | 0x04
75 | #define CMD_LCD_POS | 0x05
76 | #define CMD_LCD_BL_ON | 0x06
77 | #define CMD_LCD_BL_OFF 0x07
78
79 #define SATUS_KP_PRESS 0x01
80
81 | #define NORMALIZE_ADDRESS(addr) ((addr & 0x0FF) | 0x100)
82 | #define BANK_FROM_ADDRESS(addr) (addr >> 8)
83
84 /* ================= STRUCTS ================= */
85
86 | typedef unsigned char byte;
87 | typedef unsigned short address;
88
89 | typedef struct
90 | {
91 | unsigned long ip;
92 | char name[21];
93 | } User;
94
95 | typedef struct
96 | {
97 | byte r;
98 | byte g;
99 | byte b;
100 | } RGB;
101
102 | typedef struct
103 | {
104 | byte state;
105 | byte vsPlayer;
106 | User * host;
107 | byte colors;
108 | byte code[COLORS];
109 | byte nrOfGuesses;
110 | byte guesses[ROWS][COLORS + 2];
111 | } Game;
112
113 | struct userlist_el
114 | {
115 | User user;
116 | struct userlist_el * next;
117 | };
118
119 /* ================= METHODS ================= */

void endProgram();

User * getUserByIP(long far * ip); User * getUserByName(char * name); void addUser(long ip, char name[21]);

Game * getGame();
void resetGame();
void setRndCode(byte colors);
void guessRow(byte id);

void enableDatabus(); // Enables databus
byte readDatabus(address addr); // read byte from databus
void writeDatabus(address addr, byte value); // write byte to databus //void initTime();

void clearLCD();
void setLCDLine(byte line, const char *string);
void setLCDLineFormat(byte line, const char *format, ...);

void installCGIMethods();
void removeCGIMethods();

void printAllUsers();

/* ================= GLOBALS ================= */

const RGB BLACK = { 0, 0, 0 };
const RGB WHITE = { 255, 255, 255 };

const RGB RED = { 255, 0, 0 }; const RGB GREEN = { 0, 255, 0 }; const RGB BLUE = { 0, 0, 255 };

const RGB PINK = { 255, 0, 255 }; const RGB AQUA = { 0, 255, 255 }; const RGB YELLOW = { 255, 255, 0 };

const RGB PURPLE = { 130, 0, 255 };
const RGB ORANGE = { 255, 130, 0 };

const RGB ALL_COLORS[10] = { { 255, 0, 0 }, { 0, 255, 0 }, { 0, 0, 255 }, { 255, 0, 255 }, { 0, 255, 200 }, { 255, 255, 0 }, { 255, 255, 255 }, { 255, 80, 0 }, { 0, 0, 0 } };
const char * ALL_COLOR_CLASSES[10] = { "red", "green", "blue", "pink", "aqua", "yellow", "white", "orange", "black" };

union REGS inregs;
union REGS outregs;
struct SREGS segregs;

Game game;

struct userlist_el * listHead = NULL; struct userlist_el * listTail = NULL;

#endif /* SRC_MASTERMIND_H_ *

### 7.3.2 mastermind.c

#include "mastermind.h"

/*************************************************************
4 | * | USER RELATED
*************************************************************/

User * getUserByIP(long far * ip)
| {
struct userlist_el * current = listHead;
while (current != NULL)
| {
| | if (current->user.ip == *((unsigned long *) ip)) return &(current->user); current = current->next;
| } return NULL; }

User * getUserByName(char * name)
| {
for (int i = 0; name[i]; i++)
| | name[i] = tolower(name[i]);

struct userlist_el * current = listHead;
while (current != NULL)
| {
| | if (strcmp(current->user.name, name) == 0) return &(current->user); current = current->next;
| } return NULL; }

void addUser(long ip, char name[21])
| {
for (int i = 0; name[i]; i++)
| | name[i] = tolower(name[i]);
struct userlist_el * newItem = (struct userlist_el *) malloc(
| | sizeof(struct userlist_el));
| newItem->user.ip = ip;
strcpy(newItem->user.name, name);
| if (listHead == NULL) {
| | listHead = listTail = newItem;
| } else { | listTail->next = newItem;
| } }
| void printAllUsers() { if (listHead == NULL) {
| | printf("No users in the user list.\n");
return;
| }

printf("User list:\n");
struct userlist_el * current = listHead;
while (current != NULL)
| { | printf("Username: %s Remote IP: %d.%d.%d.%d\n", current->user.name, (int) ((current->user.ip & 0xFF000000l) >> 24),

67 | | (int) ((current->user.ip & 0x00FF0000l) >> 16),
68 | | (int) ((current->user.ip & 0x0000FF00l) >> 8),
69 | | (int) (current->user.ip & 0x000000FFl));
70 | | current = current->next;
71 | }
72 | }
73
74 | /*************************************************************
75 | * | LEDS RELATED
76 | *************************************************************/
77
78 | address sendProper(byte row, address addr)
79 | {
80 | for (byte p = 0; p < COLORS; p++)
81 | {
82 | | RGB rgb = ALL_COLORS[game.guesses[row][p]];
83 | | writeDatabus(addr++, rgb.r);
84 | | writeDatabus(addr++, rgb.g);
85 | | writeDatabus(addr++, rgb.b);
86 | }
87
88 | byte g = game.guesses[row][COLORS];
89 | byte r = game.guesses[row][COLORS + 1];
90
91 | for (byte p = 0; p < g; p++)
92 | {
93 | | writeDatabus(addr++, GREEN.r);
94 | | writeDatabus(addr++, GREEN.g);
95 | | writeDatabus(addr++, GREEN.b);
96 | }
97
98 | for (byte p = 0; p < r; p++)
99 | {
100 | | writeDatabus(addr++, YELLOW.r);
101 | | writeDatabus(addr++, YELLOW.g);
102 | | writeDatabus(addr++, YELLOW.b);
103 | }
104
105 | for (byte p = g + r; p < COLORS; p++)
106 | {
107 | | writeDatabus(addr++, BLACK.r);
108 | | writeDatabus(addr++, BLACK.g);
109 | | writeDatabus(addr++, BLACK.b);
110 | }
111
112 | return addr;
113 | }
114
115 | address sendReverse(byte row, address addr)
116 | {
117 | byte g = game.guesses[row][COLORS];
118 | byte r = game.guesses[row][COLORS + 1];
119
120 | for (byte p = g + r; p < COLORS; p++)
121 | {
122 | | writeDatabus(addr++, BLACK.r);
123 | | writeDatabus(addr++, BLACK.g);
124 | | writeDatabus(addr++, BLACK.b);
125 | }
126
127 | for (byte p = 0; p < r; p++)
128 | {
129 | | writeDatabus(addr++, YELLOW.r);
130 | | writeDatabus(addr++, YELLOW.g);
131 | | writeDatabus(addr++, YELLOW.b);
132 | }
133

134 | for (byte p = 0; p < g; p++)
135 | {
136 | | writeDatabus(addr++, GREEN.r);
137 | | writeDatabus(addr++, GREEN.g);
138 | | writeDatabus(addr++, GREEN.b);
139 | }
140
141 | for (byte p = 0; p < COLORS; p++)
142 | {
143 | | RGB rgb = ALL_COLORS[game.guesses[row][COLORS - 1 - p]];
144 | | writeDatabus(addr++, rgb.r);
145 | | writeDatabus(addr++, rgb.g);
146 | | writeDatabus(addr++, rgb.b);
147 | }
148
149 | return addr;
150 | }
151
152 | void sendLEDS()
153 | {
154 | address addr = RAM_LEDS_START;
155 | byte row = 0;
156 | while (row < ROWS)
157 | {
158 | | addr = sendProper(row++, addr);
159 | | addr = sendReverse(row++, addr);
160 | }
161 | writeDatabus(RAM_INT_SEND, CMD_LEDS_SEND);
162 | }
163
164 | /*************************************************************
165 | * | GAME RELATED
166 | *************************************************************/
167
168 | Game * getGame()
169 | {
170 | return &game;
171 | }
172
173 | void resetGame()
174 | {
175 | game.state = STATE_NO_GAME;
176 | game.nrOfGuesses = 0;
177 | for (int i = 0; i < ROWS; i++)
178 | {
179 | | for (int j = 0; j < COLORS; j++)
180 | {
181 | | game.guesses[i][j] = 9; // 9 = black
182 | }
183 | | game.guesses[i][COLORS] = 0;
184 | | game.guesses[i][COLORS + 1] = 0;
185 | }
186 | sendLEDS();
187 | }
188
189 | void setRndCode(byte colors)
190 | {
191 | if (colors > MAX_COLORS) colors = MAX_COLORS;
192 | for (byte i = 0; i < COLORS; i++)
193 | {
194 | | game.code[i] = rand() % colors;
195 | }
196 | }
197
198 | void guessRow(byte id)
199 | {
200 | if (id >= ROWS)

{
game.state = STATE_GAME_OVER; return;
}
byte usedUpPins[COLORS];
for (byte i = 0; i < COLORS; i++) usedUpPins[i] = 0;

for (byte i = 0; i < COLORS; i++)
{
// Exact matches
if (game.guesses[id][i] == game.code[i]) {
if (usedUpPins[i] == 1)
{
game.guesses[id][COLORS + 1]--; }

usedUpPins[i] = 1;
game.guesses[id][COLORS]++;
if (game.guesses[id][COLORS] == COLORS) {
game.state = STATE_GAME_WON;
}
}
else
{
for (byte j = 0; j < COLORS; j++)
{
if (game.guesses[id][i] == game.code[j] && usedUpPins[j] == 0) {
usedUpPins[j] = 1;
game.guesses[id][COLORS + 1]++;
break;
}
}
}
}
sendLEDS();
}

/*************************************************************
243 | * | DATA BUS RELATED
*************************************************************/
| void enableDatabus() {

pfe_enable_bus(0xFF, 1); // all 8 bits enabled with ALE pfe_enable_pcs(1); // Chip select 1 (PIO4)
pfe_enable_pio(2, 5); // PIO2 = output, low pfe_enable_pio(3, 5); // PIO3 = output, low
| }

byte readDatabus(address addr)
| {
byte bank = addr >> 8;
pfe_enable_pio(2, bank & 0x01 ? 4 : 5); // if bank is 1 or 3, set PIO2 high, otherwise set PIO2 low
pfe_enable_pio(3, bank & 0x02 ? 4 : 5); // if bank is 3 or 4, set PIO3 high, otherwise set PIO3 low
return hal_read_bus((addr & 0x0FF) | 0x100, 0xFFFF, 0x0000); // Read data
bus on corrected address (always in 0x100..0x1FF range)
| }

void writeDatabus(address addr, byte val)
| {
byte bank = addr >> 8;

// if bank is 1 or 3, set PIO2 high, otherwise set PIO2 low pfe_enable_pio(2, bank & 0x01 ? 4 : 5);
// if bank is 3 or 4, set PIO3 high, otherwise set PIO3 low pfe_enable_pio(3, bank & 0x02 ? 4 : 5);
// Write to data bus on corrected address (always in 0x100..0x1FF range)
hal_write_bus((addr & 0x0FF) | 0x100, val, 0xFFFF, 0x0000);
}

/*************************************************************
277 | * | LCD RELATED
*************************************************************/
| void clearLCD() {

for (address addr = RAM_LCD_START; addr <= RAM_LCD_END; addr++)
| {
| | writeDatabus(addr, ' ');
| }
writeDatabus(RAM_LCD_CMD, 0x01); writeDatabus(RAM_INT_SEND, CMD_LCD_CMD);
| }

void setLCDLine(byte line, const char * text)
| {
address offset = RAM_LCD_START;
| #if LCD_LINES == 2
if (line == 1 || line == 3) offset += 40;
| #elif LCD_LINES == 4
if (line % 2 != 0) offset += 40;
if (line > 1) offset += 0x14;
| #endif
| address i = 0;
for (; i < strlen(text); i++) // chars
| { | writeDatabus(i + offset, text[i]);
| }
for (; i < LCD_LINE_SIZE; i++) // spaces
| {
| | writeDatabus(i + offset, ' ');
| }
writeDatabus(RAM_INT_SEND, CMD_LCD_CL_PR);
| delay(100); }

void setLCDLineFormat(byte line, const char * format, ...)
| {
byte buffer[LCD_LINE_SIZE + 1];
buffer[LCD_LINE_SIZE] = 0x00;
| /* Start magic */ va_list aptr;

va_start(aptr, format);
vsprintf(buffer, format, aptr);
| va_end(aptr); /* End magic */

setLCDLine(line, buffer);
| }

/************************************************************************
330 | * | TASKS
************************************************************************/
| byte LCDupdateRunning;

void LCDupdate()
{
LCDupdateRunning = 1;
byte ip[16], oldIp[16];

while (LCDupdateRunning)
{
Get_IPConfig(ip, NULL, NULL);

if (strcmp(ip, oldIp) != 0) {
strcpy(oldIp, ip);
setLCDLine(1, ip);
}
RTX_Sleep_Time(2500);
}
}

unsigned int LCDUpdate_stack[TASK_STACKSIZE / sizeof(unsigned int)];
int LCDupdateID;

TaskDefBlock LCDupdateTaskDefBlock = { LCDupdate, { 'L', 'C', 'D', ' ' }, &LCDUpdate_stack[TASK_STACKSIZE / sizeof(unsigned int)], // top of stack TASK_STACKSIZE, // size of stack
0, // attributes, not supported
100, // lower priority than any system tasks
0, // time slice (if any), not supported
0, 0, 0, 0 // mailboxes
};

/************************************************************************
366 | * | MAIN
************************************************************************/
| /*
* Ends all tasks, returns focus and exits
| */ void endProgram() { setLCDLine(0, "Shutdown issued");
| removeCGIMethods();

printf("Gracefully ending all tasks...\n");

LCDupdateRunning = 0; // tell tasks to stop

RTX_Sleep_Time(3000); // give tasks time to end

printf("Killing the non obedient tasks...\n");
| RTX_Delete_Task(LCDupdateID);
| printf("\nEND OF PROGRAM\n"); // Release input/output BIOS_Set_Focus(FOCUS_BOTH); exit(0); }
| void test() { writeDatabus(RAM_LEDS_DIM, 0xFF); writeDatabus(RAM_LEDS_AMOUNT, 100);
| address addr = RAM_LEDS_START; for (byte r = 0; r < ROWS; r++) { | for (byte p = 0; p < COLORS * 2; p++)

402 | {
403 | RGB rgb = ALL_COLORS[rand() % MAX_COLORS];
404 | writeDatabus(addr++, rgb.r);
405 | writeDatabus(addr++, rgb.g);
406 | writeDatabus(addr++, rgb.b);
407 | }
408 | }
409 | writeDatabus(RAM_INT_SEND, CMD_LEDS_SEND);
410 | delay(1000);
411 | }
412
413 | void debugGameState()
414 | {
415 | printf(
416 | "\nGame state: %d\nGame VS player: %d\nGame host: %s\n# colors:
417 | %d\nCode: ",
418 | game.state, game.vsPlayer, game.host->name, game.colors);
419 | for (byte i = 0; i < COLORS; i++)
420 | printf("%s ", ALL_COLOR_CLASSES[game.code[i]]);
421 | printf("\n# of guesses: %d\nGuesses Table:\n", game.nrOfGuesses);
422 | for (byte r = 0; r < ROWS; r++)
423 | {
424 | printf("Guess #%d: ", r);
425 | for (byte c = 0; c < COLORS; c++)
426 | printf("%10s ", ALL_COLOR_CLASSES[game.guesses[r][c]]);
427 | printf(" Exact: %d Color: %d\n", game.guesses[r][COLORS],
428 | game.guesses[r][COLORS + 1]);
429 | }
430 | printf("Code: ");
431 | for (byte c = 0; c < COLORS; c++)
432 | printf("%10s ", ALL_COLOR_CLASSES[game.code[c]]);
433 | printf("\n\n");
434 | }
435
436 | void main()
437 | {
438 | // Get focus
439 | BIOS_Set_Focus(FOCUS_APPLICATION);
440
441 | /**
442 | * INIT All of the things!
443 | */
444 | enableDatabus();
445
446 writeDatabus(RAM_INT_SEND, CMD_LCD_BL_ON);
447
448 | writeDatabus(RAM_LEDS_DIM, 0xFF);
449 | writeDatabus(RAM_LEDS_AMOUNT, ROWS * 2 * COLORS);
450
451 | writeDatabus(RAM_LCD_CMD, 0x0C); // Blink off
452 | writeDatabus(RAM_INT_SEND, CMD_LCD_CMD);
453
454 clearLCD();
455
456 | printf("\n\nAVR firmware version id: %d 0x%02x\n\n\n",
457 | readDatabus(RAM_VERSION_1), readDatabus(RAM_VERSION_2));
458 | setLCDLine(0, "MMM by Dries007");
459 | setLCDLine(1, "Booting...");
460
461 | // Ethernet connection check
462 | if (BIOS_Ethernet_State(NULL, NULL))
463 | {
464 | setLCDLine(0, "ERROR");
465 | setLCDLine(1, "NO ETHERNET!");
466
467 | while (1)
468 | {

469 | test();
470 | }
471
472 | return;
473 | }
474
475 | /**
476 | * RUN ALL TASKS
477 | */
478 | int result = RTX_Create_Task(&LCDupdateID, &LCDupdateTaskDefBlock);
479
480 | if (result != 0)
481 | {
482 | printf("Creating/restart LCDupdate failed %d, exit program\n", result);
483 | //delete task1
484 | RTX_Delete_Task(LCDupdateID);
485 | endProgram();
486 | }
487
488 | /**
489 | * CGI methods
490 | */
491
492 | printf("Installing CGI methods\n");
493 | installCGIMethods();
494
495 | printf("Reset Game status\n");
496 | resetGame();
497
498 | /*
499 | * MENU
500 | */
501 | byte key;
502 | while (1)
503 | {
504 | printf("-~= Menu =~-\n");
505 | printf("------------\n");
506 | printf("[X] End program\n");
507 | printf("[R] Reboot\n");
508 | printf("[D] Debug RAM Dump\n");
509 | printf("[S] Set RAM manually\n");
510 | printf("[G] Debug Game State\n");
511 | printf("[U] Print all known users\n");
512 | printf("[I] Interrupt test to AVR\n");
513
514 | scanf("%c%*c", &key);
515
516 | switch (key & ~0x20)
517 | {
518 | case 'X':
519 | endProgram();
520 | break;
521 | case 'R':
522 | BIOS_Reboot();
523 | break;
524 | case 'D':
525 | ramdump();
526 | break;
527 | case 'S':
528 | manualram();
529 | break;
530 | case 'G':
531 | debugGameState();
532 | break;
533 | case 'U':
534 | printAllUsers();
535 | break;

case 'I':
test();
break;
default:
printf("Char not in menu: %c\n", key); }
}
}

/************************************************************************
546 | * | WEB
************************************************************************/

/*************************************************************
550 | * | TEMPLATE PARTS
*************************************************************/
| char * pageHeader = | "<!doctype html><html><head><meta charset='us-ascii'/><meta

name='viewport' content='width=400' /><title>Mastermind</title><link href='http://fonts.googleapis.com/css?family=Open+Sans:600,400'rel='stylesheet' type='text/css'><style type='text/css'>body,html{font-family:'Open Sans',sans-serif;margin:0 auto;padding:0;height:100%%;min-height:100%%;position:relative;max-width:500px}#wrapper{padding:10px 10px 30px}.center{text-align:center}.black{background-color:#000;color:#fff}.white{background-color:#fff}.orange{background-color:orange}.purple{background-color:purple;color:#fff}.yellow{background-color:#ff0}.aqua{background-color:#0ff}.pink{background-color:#ff1493}.blue{background-color:#00f;color:#fff}.green{background-color:green;color:#fff}.red{background-color:red}header h1{margin:1px}header ul{margin:1px;padding:1px}header ul li{display:inline;padding:0 10px;margin:1px;border:1px solid #000;border-radius:5px;box-shadow:2px 2px 3px #888}header ul li a{tekst-decoration:none;color:#000}.guesses{width:100%%;text-align:center;;border-collapse:collapse}.guesses .txt{padding:0 10px}.guesses * tr td{border:1px solid #000}footer{position:absolute;bottom:0;height:30px;padding:0 10px}footer a{text-decoration:none;color:#d3d3d3;font-size:smaller}input[type=submit], .btn{display:inline;padding:3px 10px;margin:1px;border:1px solid #000;border-radius:5px;box-shadow:2px 2px 3px #888;background:#fff;text-decoration:none;color:#000}</style></head><body><div id='wrapper'>";

| char * pageFooter =
| | "</div><footer><a class='center' href='http://www.dries007.net/'>&copy;
Dries007.net - 2015</a></footer></body></html>";
| char * pickUsername = | "<h2>Welcome new player!</h2><p>Before you can play, you need to pick a

username:</p><form method='post' action='pickUsername'><input type='text' name='username' maxlength='20'/><input type='submit' value='Check'/></form>";

char * noGameYet = "<p>No game is going yet, but you can start one!</p>";

| char * gameAvailable =
| | "<p>A game is currently being played. Go ahead an join!</p>";
| /**
* Needs 2 extra strings per count. First string is URL, second is name.
| */
void addMenuItems(char * buffer, byte count, ...)
| {
strcat(buffer, "<header class='center'><h1>Mastermind</h1><ul>");
| va_list ap; va_start(ap, count);

for (byte i = 0; i < count; i++)
{
strcat(buffer, "<li><a href='"); strcat(buffer, va_arg(ap, char *)); strcat(buffer, "'>");
strcat(buffer, va_arg(ap, char *)); strcat(buffer, "</a></li>");
}

va_end(ap);
strcat(buffer, "</ul></header>");
}

/*************************************************************
617 | * | HOME (GET)
*************************************************************/

void huge _pascal _saveregs cgiHomeFunction(rpCgiPtr CgiRequest)
| {
static char pageBuffer[2048]; // Buffer to contain web page //char tmpBuffer[512]; // Buffer for string manipulation functions

sprintf(pageBuffer, pageHeader);

User * user = getUserByIP(CgiRequest->fRemoteIPPtr);
| if (user == NULL) { | addMenuItems(pageBuffer, 0); strcat(pageBuffer, pickUsername);
| } else { | if (getGame()->state == STATE_NO_GAME) addMenuItems(pageBuffer, 1, "start", "Start a game"); else addMenuItems(pageBuffer, 1, "play", "Play");
| | strcat(pageBuffer, "<h2>Welcome "); strcat(pageBuffer, user->name); strcat(pageBuffer, "</h2>");
| | if (getGame()->state == STATE_NO_GAME) strcat(pageBuffer, noGameYet); else strcat(pageBuffer, gameAvailable);
| }

strcat(pageBuffer, pageFooter);

CgiRequest->fHttpResponse = CgiHttpOk; CgiRequest->fDataType = CGIDataTypeHtml; CgiRequest->fResponseBufferPtr = pageBuffer; CgiRequest->fResponseBufferLength = strlen(pageBuffer);
| }

/*************************************************************
656 | * | PICK USERNAME (POST)
*************************************************************/

void huge _pascal _saveregs cgiPickUsernameFunction(rpCgiPtr CgiRequest)
| {
static char pageBuffer[2048]; // Buffer to contain web page
//char tmpBuffer[512]; // Buffer for string manipulation functions

sprintf(pageBuffer, pageHeader);

| char * name; char * value;

while (CGI_GetArgument(&name, &value, CgiRequest) == CGI_ARGUMENT_ERR_OK)
| {

if (strcmp(name, "username") == 0) {
if (getUserByName(value) != NULL) {
addMenuItems(pageBuffer, 0);

strcat(pageBuffer, "<p>Sorry, ");
strcat(pageBuffer, value);
strcat(pageBuffer,
" is already in use. Pick another name please:</p><form method='post' action='pickUsername'><input type='text' name='username'/><input type='submit' value='Check'/></form>"); }
else
{
addUser(*((long *) CgiRequest->fRemoteIPPtr), value);

if (getGame()->state == STATE_NO_GAME) addMenuItems(pageBuffer, 1, "start", "Start a game");
else addMenuItems(pageBuffer, 1, "play", "Play");

strcat(pageBuffer, "<p>You are now known as "); strcat(pageBuffer, value);
strcat(pageBuffer, "!</p>");

if (getGame()->state == STATE_NO_GAME) strcat(pageBuffer, noGameYet);
else strcat(pageBuffer, gameAvailable);
}
}
}

strcat(pageBuffer, pageFooter);

CgiRequest->fHttpResponse = CgiHttpOk; CgiRequest->fDataType = CGIDataTypeHtml; CgiRequest->fResponseBufferPtr = pageBuffer; CgiRequest->fResponseBufferLength = strlen(pageBuffer);
}

/*************************************************************
711 | * | START (BOTH)
*************************************************************/

void huge _pascal _saveregs cgiStartFunction(rpCgiPtr CgiRequest)
| {
static char pageBuffer[2048]; // Buffer to contain web page char tmpBuffer[512]; // Buffer for string manipulation functions

sprintf(pageBuffer, pageHeader);

User * user = getUserByIP(CgiRequest->fRemoteIPPtr);
Game * game = getGame();
| if (user == NULL) {
| | addMenuItems(pageBuffer, 0); strcat(pageBuffer, pickUsername);
| }
else if (game->state == STATE_NO_GAME
| | || game->state == STATE_GAME_CONFIGURED) // If game is not (fully)
| configured yet {

char * name;
char * value;
| | while (CGI_GetArgument(&name, &value, CgiRequest) == CGI_ARGUMENT_ERR_OK) // Argument parse loop

{

if (strcmp(name, "mode") == 0) // Gamemode
{
game->vsPlayer = strcmp(value, "Player") == 0; game->state = STATE_GAME_CONFIGURED;
}
else if (strcmp(name, "colors") == 0) // # of colors {
game->colors = atoi(value);
game->state = STATE_GAME_CONFIGURED;
}
else // Colors of code
{
int i;
sscanf(name, "c%d", &i);
game->code[i] = atoi(value); game->state = STATE_GAME_STARTED;
}
}

if (game->state == STATE_GAME_CONFIGURED) // If game is partially configured (argument parser above)
{
if (game->vsPlayer) // Print color picker code
{
game->host = user;
addMenuItems(pageBuffer, 0);
strcat(pageBuffer,
"<p>Pick your code:</p><form method='get' action='start'>"); for (byte i = 0; i < 4; i++) // Color picker 1 -> 4
{
sprintf(tmpBuffer, "<select name='c%d'>", i); strcat(pageBuffer, tmpBuffer);

for (byte c = 0; c < game->colors; c++)
{
sprintf(tmpBuffer, "<option value='%d' class='%s'>%s</option>", c, ALL_COLOR_CLASSES[c], ALL_COLOR_CLASSES[c]); strcat(pageBuffer, tmpBuffer);
}

strcat(pageBuffer, "</select>");
}
strcat(pageBuffer,
"<input type='submit' value='Choose!'/></form>"); }
else // VS computer
{
addMenuItems(pageBuffer, 1, "play", "Play"); strcat(pageBuffer, "<h2>Game started!</h2>"); setRndCode(game->colors);
game->state = STATE_GAME_STARTED;
}
}
else if (game->state == STATE_GAME_STARTED) // Game started {
addMenuItems(pageBuffer, 1, "play", "Play"); strcat(pageBuffer, "<h2>Game started!</h2>");
}
else // New game form
{
addMenuItems(pageBuffer, 0);
strcat(pageBuffer,
"<h2>Start a new game</h2><form method='get' action='start'><p> Player(s) VS <label><input type='radio' name='mode' value='Player' checked/> Host</label><label><input type='radio' name='mode' value='Computer'/> Computer</label></p><p><label for='colors'># of colors: </label><select id='colors'

name='colors'><option>4</option><option>6</option><option>8</option></select ></p><input type='submit' value='Go!'/></form>");
}
}
else // Already going
{
addMenuItems(pageBuffer, 1, "play", "Play");
strcat(pageBuffer,
"<h2>Start a new game</h2><p>A game has already been started.</p>"); }

strcat(pageBuffer, pageFooter);

CgiRequest->fHttpResponse = CgiHttpOk; CgiRequest->fDataType = CGIDataTypeHtml; CgiRequest->fResponseBufferPtr = pageBuffer; CgiRequest->fResponseBufferLength = strlen(pageBuffer);
}

/*************************************************************
824 | * | PLAY (GET)
*************************************************************/

void huge _pascal _saveregs cgiPlayFunction(rpCgiPtr CgiRequest)
| {
static char pageBuffer[2048]; // Buffer to contain web page char tmpBuffer[512]; // Buffer for string manipulation functions

sprintf(pageBuffer, pageHeader);

User * user = getUserByIP(CgiRequest->fRemoteIPPtr);
Game * game = getGame();
| if (user == NULL) { | addMenuItems(pageBuffer, 0); strcat(pageBuffer, pickUsername);
| }
else if (game->state == STATE_NO_GAME) // If game is not configured yet
| {
| | addMenuItems(pageBuffer, 1, "start", "Start a game"); strcat(pageBuffer, noGameYet);
| } else { | addMenuItems(pageBuffer, 0);
| | if (game->state == STATE_GAME_STARTED)
{
| | // Process guess, if any
char * name;
char * value;
byte i = 0xFF;
| | while (CGI_GetArgument(&name, &value, CgiRequest) == CGI_ARGUMENT_ERR_OK)

{
| | int p, c; //p = position, c = color id sscanf(name, "c%d", &p); c = atoi(value); if (i == 0xFF) i = game->nrOfGuesses++; game->guesses[i][p] = c;

}
| | if (i != 0xFF) guessRow(i);
}
| | // Display guess table

strcat(pageBuffer,
"<p>Guesses:</p><table class='guesses' border> <tr> <th class='txt'>#</th>");
for (byte c = 0; c < COLORS; c++)
strcat(pageBuffer, "<th style='min-width: 50px;'></th>"); strcat(pageBuffer,
"<th class='txt'>Exact</th> <th class='txt'>Color</th> </tr>");

for (byte i = 0; i < game->nrOfGuesses; i++)
{
sprintf(tmpBuffer, "<tr><td style='padding: 0 10px'>%d</td>", i); strcat(pageBuffer, tmpBuffer);

for (byte c = 0; c < COLORS; c++)
{
char * color = ALL_COLOR_CLASSES[game->guesses[i][c]]; sprintf(tmpBuffer, "<td class='%s'>%s</td>", color, color); strcat(pageBuffer, tmpBuffer);
}
sprintf(tmpBuffer, "<td>%d</td><td>%d</td></tr>", game->guesses[i][COLORS], game->guesses[i][COLORS + 1]); strcat(pageBuffer, tmpBuffer);
}

strcat(pageBuffer, "</table>");

if (game->state == STATE_GAME_OVER)
{
strcat(pageBuffer,
"<p>Game over! The host/computer won!</p><a href='reset' class='btn'>Reset</a>");
}
else if (game->state == STATE_GAME_WON)
{
strcat(pageBuffer,
"<p>Game over! The codebreaker(s) won!</p><a href='reset' class='btn'>Reset</a>");
}
else if (game->vsPlayer && game->host == user)
{
strcat(pageBuffer, "<p>You picked the code, you can't guess.</p>"); }
else if (game->state == STATE_GAME_STARTED) // Let user make guess {
strcat(pageBuffer,
"<p>Make a guess:</p><form method='get' action='play'>"); for (byte i = 0; i < COLORS; i++) // Color picker 1 -> 4
{
sprintf(tmpBuffer, "<select name='c%d'>", i); strcat(pageBuffer, tmpBuffer);

for (byte c = 0; c < game->colors; c++)
{
byte selected = game->nrOfGuesses != 0
&& game->guesses[game->nrOfGuesses - 1][i] == c; sprintf(tmpBuffer,
"<option value='%d' class='%s' %s >%s</option>", c, ALL_COLOR_CLASSES[c], selected ? "selected" : "", ALL_COLOR_CLASSES[c]);
strcat(pageBuffer, tmpBuffer);
}

strcat(pageBuffer, "</select>");
}
strcat(pageBuffer, "<input type='submit' value='Choose!'/></form>"); }
else

{
strcat(pageBuffer,
"<p>Code is not yet picked. Refresh the page to get a status update.</p>");
}
}
strcat(pageBuffer, pageFooter);

CgiRequest->fHttpResponse = CgiHttpOk; CgiRequest->fDataType = CGIDataTypeHtml; CgiRequest->fResponseBufferPtr = pageBuffer; CgiRequest->fResponseBufferLength = strlen(pageBuffer);
}

/*************************************************************
953 | * | RESET (GET)
*************************************************************/

void huge _pascal _saveregs cgiResetFunction(rpCgiPtr CgiRequest)
| {
static char pageBuffer[2048]; // Buffer to contain web page char tmpBuffer[512]; // Buffer for string manipulation functions

sprintf(pageBuffer, pageHeader);

User * user = getUserByIP(CgiRequest->fRemoteIPPtr);
Game * game = getGame();
| if (user == NULL) { | addMenuItems(pageBuffer, 0); strcat(pageBuffer, pickUsername);
| }
else if (game->state == STATE_GAME_OVER || game->state == STATE_GAME_WON)
| // If game done {

resetGame();

| | addMenuItems(pageBuffer, 1, "start", "Start a game"); strcat(pageBuffer, "<p>The game has been reset.</p>");
| } else {
| | strcat(pageBuffer, "<p>Incorrect game state.</p>");
| }

strcat(pageBuffer, pageFooter);

CgiRequest->fHttpResponse = CgiHttpOk; CgiRequest->fDataType = CGIDataTypeHtml; CgiRequest->fResponseBufferPtr = pageBuffer; CgiRequest->fResponseBufferLength = strlen(pageBuffer);
| }

/*************************************************************
993 | * | ALL INSTALL / REMOVE LOGIC
*************************************************************/

typedef void huge _pascal _saveregs (*CGIfn)(rpCgiPtr); // Because function pointer syntax in unreadable

char *cgiNames[] = { "home", "pickUsername", "start", "play", "reset" }; int cgiMethods[] = { CgiHttpGet, CgiHttpPost, CgiHttpGet, CgiHttpGet, CgiHttpGet };
CGIfn cgiFunctions[] = { cgiHomeFunction, cgiPickUsernameFunction,
| | cgiStartFunction, cgiPlayFunction, cgiResetFunction };

1005 | void installCGIMethods()
1006 | {
1007 | CGI_Entry cgiEntry;
1008
1009 | for (byte i = 0; i < 5; i++)
1010 | {
1011 | cgiEntry.PathPtr = cgiNames[i];
1012 | cgiEntry.CgiFuncPtr = cgiFunctions[i];
1013 | cgiEntry.method = cgiMethods[i];
1014
1015 | if (CGI_Install(&cgiEntry) != 0)
1016 | {
1017 | printf("Installing CGI function %s failed\n", cgiEntry.PathPtr);
1018 | endProgram();
1019 | }
1020 | }
1021 | }
1022
1023 | void removeCGIMethods()
1024 | {
1025 | byte n = sizeof(cgiMethods) / sizeof(int);
1026 | for (byte i = 0; i < n; i++)
1027 | {
1028 | if (CGI_Delete(cgiNames[i]))
1029 | {
1030 | printf("Removing %s failed\n", cgiNames[i]);
1031 | }
1032 | }

### 7.3.3 ramdump.h

1 | #ifndef RAMDUMP_H_
2 | #define RAMDUMP_H_
3
4 #pragma option -1 //create 80186 code 5
6 | #include <stdio.h>
7 | #include <stdlib.h>
8 | #include <string.h>
9 | #include <rtos.h>
10 | #include <tcpip.h>
11 | #include <i2c_api.h>
12 | #include <limits.h>
13 | #include <rtxapi.h>
14 | #include <rtos.h>
15 | #include <hwapi.h>
16 | #include <dos.h>
17 | #include <stdarg.h>
18
19 | #ifndef BYTE_H_
20 | #define BYTE_H_
21
22 | typedef unsigned char byte;
23 | typedef unsigned short address;
24
25 #endif
26
27 | void ramdump();
28 | void manualram();
29
30 #endif /* RAMDUMP_H_ */

### 7.3.4 ramdump.c

1 #include "ramdump.h"
2
3 | void manualram()
4 | {
5 | char buf[64];
6 | printf("\nAddress? ");
7 | gets(buf);
8 | address addr = strtol(buf, NULL, 0);
9 | printf("\nValue? ");
10 | gets(buf);
11 | byte val = strtol(buf, NULL, 0);
12
13 | byte bank = addr >> 8;
14 | printf("\nWriting 0x%02x to 0x%04x (Bank %d, Real address 0x%04x)\n",
15 | val, addr, bank, (addr & 0x0FF) | 0x100);
16 | pfe_enable_pio(2, bank & 0x01 ? 4 : 5);
17 | pfe_enable_pio(3, bank & 0x02 ? 4 : 5);
18 | hal_write_bus((addr & 0x0FF) | 0x100, val, 0xFFFF, 0x0000);
19 | }
20
21 | void ramdump()
22 | {
23 | printf("##############################\n");
24 | printf("########## RAM DUMP ##########\n");
25 | printf("##############################\n");
26
27 | pfe_enable_bus(0xFF, 1);
28 | pfe_enable_pcs(1);
29
30 | for (byte bank = 0; bank < 4; bank++)
31 | {
32 | printf("########## BANK %d ##########\n", bank);
33 | pfe_enable_pio(2, bank & 0x01 ? 4 : 5);
34 | pfe_enable_pio(3, bank & 0x02 ? 4 : 5);
35
36 | printf(
37 | " | | 0xx0 | 0xx1 | 0xx2 | 0xx3 | 0xx4 | 0xx5 | 0xx6 | 0xx7 | 0xx8
38 | | 0xx9 | 0xxA | 0xxB | 0xxC | 0xxD | 0xxE | 0xxF |\n");
39 | printf(
40 | "-----+------+------+------+------+------+------+------+------+-----
41 | -+------+------+------+------+------+------+------+\n");
42 | address addr = 0x100;
43 | while (addr < 0x200)
44 | {
45 | printf("0x%1xx |", (addr & 0xF0) >> 4);
46 | do
47 | {
48 | printf(" 0x%02x |", hal_read_bus(addr, 0xFFFF, 0x0000));
49 | addr++;
50 | }
51 | while (addr % 0x10 != 0);
52 | printf("\n");
53 | }
54 | }
55
56 | printf("##############################\n");
57 | printf("########## | DONE | ##########\n");
58 | printf("##############################\n");
59 | }
60

### 7.3.5 HTML template

Dit is de niet gecondenseerde versie van de HTML code gebruikt in mastermind.c regel 554 t.e.m. 576.

<!DOCTYPE html>
<html>
<head>
<meta charset='us-ascii'>
<meta content='width=400' name='viewport'> <title>
Mastermind
</title>
<link
href='http://fonts.googleapis.com/css?family=Open+Sans:600,400'rel='stylesheet' type='text/css'>
<style type='text/css'>
body,html {
font-family:'Open Sans',sans-serif; margin:0 auto;
padding:0;
height:100%%;
min-height:100%%;
position:relative;
max-width:500px
}
header ul li {
display:inline;
padding:0 10px;
margin:1px;
border:1px solid #000;
border-radius:5px;
box-shadow:2px 2px 3px #888 }
guesses {
width:100%%;
text-align:center;
border-collapse:collapse
}
footer {
position:absolute;
bottom:0;
height:30px;
padding:0 10px
}
footer a {
text-decoration:none;
color:#d3d3d3;
font-size:smaller
}
input[type=submit],.btn {
display:inline;
padding:3px 10px;
margin:1px;
border:1px solid #000;
border-radius:5px;
box-shadow:2px 2px 3px #888; background:#fff;
text-decoration:none;
color:#000
}
#wrapper { padding:10px 10px 30px } .center { text-align:center }

.black { background-color:#000; color:#fff } .white { background-color:#fff }
.orange { background-color:orange }

62 | .purple { background-color:purple; color:#fff }
63 | .yellow { background-color:#ff0 }
64 | .aqua { background-color:#0ff }
65 | .pink { background-color:#ff1493 }
66 | .blue { background-color:#00f; color:#fff }
67 | .green { background-color:green; color:#fff }
68 | .red { background-color:red }
69 | header h1 { margin:1px }
70 | header ul { margin:1px; padding:1px }
71 | header ul li a { tekst-decoration:none; color:#000 }
72 | guesses .txt { padding:0 10px }
73 | guesses * tr td { border:1px solid #000 }
74 | </style>
75 | </head>
76 | <body>
77 | <div id='wrapper'></div>
78 | <footer>
79 | <a class='center' href='http://www.dries007.net/'>&copy;
80 | Dries007.net - 2015</a>
81 | </footer>
82 | </body>
83 | </html>

### 7.3.6 AVR.h

1 | #ifndef AVR_H_
2 | #define AVR_H_
3
4 #define DEBUG 0
5
6 | /* =============== PORT CONFIG ============== */
7 | // Mask to eliminate INT4
8 | #define | LCD_PORT | PORTB
9 | #define | LCD_DDR | DDRB
10 | // KP = Keypad
11 | #define | KP_PORT | PORTD
12 | #define | KP_DDR | DDRD
13 | #define | KP_PIN | PIND
14 | // WS2812
15 | #define LEDS_PORT | PORTE
16 | #define LEDS_DDR | DDRE
17 | #define LEDS_PIN | 7
18
19 | /* ============== RAM ADDRESSES ============= */
20 | // Offset for External RAM
21 | #define RAM_OFFSET | 0x8000
22 | // 170 Leds max (x 3 bytes = 0x1FE)
23 | #define RAM_LEDS_START (RAM_OFFSET + 0x000)
24 | #define RAM_LEDS_END | (RAM_OFFSET + 0x1FE)
25 | #define RAM_LEDS_AMOUNT (RAM_OFFSET + 0x1FF)
26 | // 80 bytes of char buffer for LCD
27 | #define RAM_LCD_START | (RAM_OFFSET + 0x200)
28 | #define RAM_LCD_END | (RAM_OFFSET + 0x250)
29 | #define RAM_LCD_CMD | (RAM_OFFSET + 0x251)
30 | // Mask for global LED dimming
31 | #define RAM_LEDS_DIM | (RAM_OFFSET + 0x252)
32 | #define RAM_KP_LASTKEY (RAM_OFFSET + 0x253)
33
34 | #define RAM_VERSION_1 | (RAM_OFFSET + 0x300)
35 | #define RAM_VERSION_2 | (RAM_OFFSET + 0x301)
36
37 | // Interrupt registers
38 | #define RAM_INT_SEND | (RAM_OFFSET + 0x3FE)
39 | #define RAM_INT_GET | (RAM_OFFSET + 0x3FF)
40
41 | #define MAX_LEDS | ((uint8_t)(RAM_LEDS_END - RAM_LEDS_START))
42 | #define MAX_LCD_CHARS | ((uint8_t)(RAM_LCD_END - RAM_LCD_START))
43
44 | /* ================ CMD CODES =============== */
45 | #define CMD_LEDS_SEND | 0x01 | // Clock out LEDS
46 | #define CMD_LCD_CHAR | 0x02 | // Print char buffer to LCD
47 | #define CMD_LCD_CMD | 0x03 | // Send instruction byte to LCD
48 | #define CMD_LCD_CL_PR | 0x04 | // Send clear + print out char buffer to LCD
49 | #define CMD_LCD_POS | 0x05 | // Set LCD cursor to position
50 | #define CMD_LCD_BL_ON | 0x06 | // Set LCD_BACKLIGHT = 1
51 | #define CMD_LCD_BL_OFF 0x07 | // Set LCD_BACKLIGHT = 0
52
53 | #define SATUS_KP_PRESS 0x01 | // Key was pressed
54
55 | /* ================= MACROS ================= */
56 | /*
57 | !WARNING! The data-lines on my custom PCB are flipped on the AVR side.
58 | This means that these macros use the '__builtin_avr_insert_bits' macro to
59 | flip the data read/written from/to the DP-RAM.
60 | If you don't need this, replace '__builtin_avr_insert_bits (0x01234567,
61 | {value}, 0)' with '{value}'.
62 | */
63 | #define PONTER_RAM(addr) | ( ((volatile uint8_t *) addr) )
64 | #define READ_RAM(addr) | ( __builtin_avr_insert_bits (0x01234567,
65 | *PONTER_RAM(addr), 0) )
66 | #define WRITE_RAM(addr, val) | { *PONTER_RAM(addr) =

67 __builtin_avr_insert_bits (0x01234567, val, 0); } 68
69 | /* ================= STRUCTS ================ */
70 | // Correct byte order!
71 | struct cRGB { uint8_t g; uint8_t r; uint8_t b; };
72
73 | /* ================= GLOBALS ================ */
74 | struct cRGB LEDS[MAX_LEDS]; // LED data, in correct byte order
75 | uint8_t LCD_BACKLIGHT = 0; // LCD back light pin status (pin 7)
76
77 /* ================ FUNCTIONS =============== */
78
79 | void inline inits();
80 | uint8_t inline readMatrix(uint8_t matrix);
81
82 | void inline sendLEDS(uint16_t amountOfLeds);
83 | void sendLCDNible(uint8_t data, uint8_t rs);
84 | void sendLCDInstructionByte(uint8_t data);
85 | void sendLCDCharacterByte(char data);
86 | void sendLCDBuffer(char * buffer);
87
88 | /* ############## START SECTION WS2812 DRIVER ##############
89 | * Original Source: | https://github.com/cpldcpu/light_ws2812/
90 | * Original Author: | Tim (cpldcpu@gmail.com)
91 | * Original License: | GNU GPL V2
92 | (https://github.com/cpldcpu/light_ws2812/blob/master/License.txt)
93 | * | This license still applies to everything between the "WS2812 DRIVER"
94 | section lines.
95 | *
96 | * Modifications by Dries007:
97 | * - | Changed configuration
98 | * - | Merged library into single set of source and header files
99 | */
100 | // Timing in ns
101 | #define w_zeropulse | 350
102 | #define w_onepulse | 900
103 | #define w_totalperiod 1250
104
105 | // Fixed cycles used by the inner loop
106 | #define w_fixedlow | 2
107 | #define w_fixedhigh | 4
108 | #define w_fixedtotal 8
109
110 | // Insert NOPs to match the timing, if possible
111 | #define w_zerocycles | (((F_CPU/1000)*w_zeropulse | )/1000000)
112 | #define w_onecycles | (((F_CPU/1000)*w_onepulse | +500000)/1000000)
113 | #define w_totalcycles | (((F_CPU/1000)*w_totalperiod +500000)/1000000)
114
115 | // w1 - nops between rising edge and falling edge - low
116 | #define w1 (w_zerocycles-w_fixedlow)
117 | // w2 | nops between fe low and fe high
118 | #define w2 (w_onecycles-w_fixedhigh-w1)
119 | // w3 | nops to complete loop
120 | #define w3 (w_totalcycles-w_fixedtotal-w1-w2)
121
122 | #if w1>0
123 | #define w1_nops w1
124 | #else
125 | #define w1_nops 0
126 | #endif
127
128 | // The only critical timing parameter is the minimum pulse length of the "0"
129 | // Warn or throw error if this timing can not be met with current F_CPU
130 | settings.
131 | #define w_lowtime ((w1_nops+w_fixedlow)*1000000)/(F_CPU/1000)
132 | #if w_lowtime>550
133 | #error "WS2812 DRIVER: Sorry, the clock speed is too low. Did you set

134 | F_CPU correctly?"
135 | #elif w_lowtime>450
136 | #warning "WS2812 DRIVER: The timing is critical and may only work on
137 | WS2812B, not on WS2812(S)."
138 | #warning "Please consider a higher clockspeed, if possible"
139 | #endif
140
141 | #if w2>0
142 | #define w2_nops w2
143 | #else
144 | #define w2_nops 0
145 | #endif
146
147 | #if w3>0
148 | #define w3_nops w3
149 | #else
150 | #define w3_nops 0
151 | #endif
152
153 | #define w_nop1 "nop | \n\t"
154 | #define w_nop2 "rjmp .+0 \n\t"
155 | #define w_nop4 w_nop2 w_nop2
156 | #define w_nop8 w_nop4 w_nop4
157 | #define w_nop16 w_nop8 w_nop8
158
159 /* ############## END SECTION WS2812 DRIVER ############## */ 160
161 #endif /* AVR_H_ */

### 7.3.7 AVR.c

#include <stdio.h>

#include <stdlib.h>

#include <avr/interrupt.h> #include <avr/io.h>

#include <avr/pgmspace.h>

#include <util/delay.h>

#include "AVR.h"

/* ======= INTERRUPT SERVICE ROUTINES ======= */ // Interrupt Service Routine for INT4
ISR(INT4_vect)
{
// read interrupt address, also clears interrupt signal volatile uint8_t cmd = READ_RAM(RAM_INT_GET);

switch (cmd)
{
// Copy LED data from DPRAM into RAM (sets correct byte order) and clock out the data
case CMD_LEDS_SEND:
{
// Amount of LEDS connected
uint8_t n = READ_RAM(RAM_LEDS_AMOUNT);
// Global LED dimmer settings
uint8_t dim = READ_RAM(RAM_LEDS_DIM);
// Make sure that n <= MAX_LEDS to prevent data corruption if (n > MAX_LEDS) n = MAX_LEDS;
// used for DPRAM address offset from RAM_LEDS_START uint16_t offset = 0;
for (uint16_t i = 0; i < n; i++)
{
LEDS[i].r = READ_RAM(RAM_LEDS_START + (offset ++)) & dim; LEDS[i].g = READ_RAM(RAM_LEDS_START + (offset ++)) & dim; LEDS[i].b = READ_RAM(RAM_LEDS_START + (offset ++)) & dim; }
// Clock out data
sendLEDS(n);
}
break;
// Shortcut command to set LCD cursor position
case CMD_LCD_POS:
{
sendLCDInstructionByte(READ_RAM(RAM_LCD_CMD) | 0b10000000);
}
break;
// Send LCD an insrtuction byte
case CMD_LCD_CMD:
{
sendLCDInstructionByte(READ_RAM(RAM_LCD_CMD)); }
break;
// Shortcut for clear & print
case CMD_LCD_CL_PR:
{
sendLCDInstructionByte(0x01); _delay_ms(10);
}
// no break!
// Print char buffer (until max chars or 0x00) case CMD_LCD_CHAR:
{
for (uint8_t i = 0; i < MAX_LCD_CHARS; i++) {
uint8_t c = READ_RAM(RAM_LCD_START + i); if (c == 0x00) break;

67 | sendLCDCharacterByte(c);
68 | }
69 | }
70 | break;
71 | case CMD_LCD_BL_ON: LCD_BACKLIGHT = 1; break;
72 | case CMD_LCD_BL_OFF: LCD_BACKLIGHT = 0; break;
73 | }
74 | /* Interrupt detection debug code */
75 | #if DEBUG
76 | char buff[10];
77 | sprintf(buff, "I:0x%02X", cmd);
78 | sendLCDBuffer(buff);
79 | #endif
80 | sei();
81 | }
82
83 | /* ================== DEBUG STUFF ================== */
84 | /* HANDLE DEBUG KEYPRESS HERE */
85 | void debugKeypress(uint8_t key)
86 | {
87 | // buffer index pointer
88 | static uint8_t b = 0;
89 | // buffer (20 chars = 1 line)
90 | static char buffer[20];
91
92 | switch (key)
93 | {
94 | // SEND
95 | case '*':
96 | {
97 | sendLEDS(30);
98
99 | b = 0;
100 | buffer[b] = 0;
101 | sendLCDInstructionByte(0x01);
102 | _delay_ms(2);
103 | sprintf(buffer, " | 0x%02X 0x%02X 0x%02X", LEDS[0].r,
104 | LEDS[0].g, LEDS[0].b);
105 | sendLCDBuffer(buffer);
106 | // 1e pos on lcd
107 | sendLCDInstructionByte(0x80);
108 | break;
109 | }
110 | // BACKSPACE
111 | case '#':
112 | {
113 | if (b != 0) b--;
114 | buffer[b] = 0;
115
116 | sendLCDInstructionByte(0x01);
117 | _delay_ms(2);
118
119 | sendLCDBuffer(buffer);
120 | break;
121 | }
122 | // SET RED
123 | case 'A':
124 | {
125 | uint8_t nr = atoi(buffer);
126 | for (uint8_t i = 0; i < 30; i++)
127 | {
128 | LEDS[i].r = nr;
129 | }
130 | b = 0;
131 | buffer[b] = 0;
132 | sendLCDInstructionByte(0x01);
133 | _delay_ms(2);

134 | break;
135 | }
136 | // SET GREEN
137 | case 'B':
138 | {
139 | uint8_t nr = atoi(buffer);
140 | for (uint8_t i = 0; i < 30; i++)
141 | {
142 | LEDS[i].g = nr;
143 | }
144 | b = 0;
145 | buffer[b] = 0;
146 | sendLCDInstructionByte(0x01);
147 | _delay_ms(2);
148 | break;
149 | }
150 | // SET BLUE
151 | case 'C':
152 | {
153 | uint8_t nr = atoi(buffer);
154 | for (uint8_t i = 0; i < 30; i++)
155 | {
156 | LEDS[i].b = nr;
157 | }
158 | b = 0;
159 | buffer[b] = 0;
160 | sendLCDInstructionByte(0x01);
161 | _delay_ms(2);
162 | break;
163 | }
164 | case 'D':
165 | {
166 | sendLCDInstructionByte(0x01);
167 | for (uint8_t i = 0; i < MAX_LCD_CHARS; i++)
168 | {
169 | uint8_t c = READ_RAM(RAM_LCD_START + i);
170 | if (c == 0x00) break;
171 | sendLCDCharacterByte(c);
172 | }
173 | }
174 | break;
175 | // NUMBER
176 | default:
177 | {
178 | buffer[b++] = key;
179 | buffer[b] = 0;
180 | sendLCDCharacterByte(key);
181 | break;
182 | }
183 | }
184 | }
185
186 | /* ================== MAIN ================== */
187 | int main()
188 | {
189 | // set ports & interrupt registers
190 | inits();
191
192 | #if DEBUG
193 | // debounce variables
194 | uint8_t prevKey = 0x00;
195 | uint16_t downTime = 0 ;
196 | uint16_t upTime = 0;
197
198 | // debug program loop (aka keypad scanner)
199 | while (1)
200 | {

// ROW loop
for (uint8_t r = 0; r < 4; r++)
{
// all pins HIGH, the row we want to read LOW; bit 0-4 always high because they are inputs (pull-up).
KP_PORT = 0x0F | (0b11101111 << r);
// Convert read port byte (inverted because pull-ups)

uint8_t key = readMatrix(~KP_PIN);
// no key pressed
if (key == 0x00)
{
// if no key was pressed for 100+ ms, reset debounce.
if (upTime++ > 100)
{
// Makes sure the next keypress will register instantly prevKey = 0x00;

downTime = 0;
upTime = 0;
}
}
else // A key was pressed
{
// if the pressed key is different from the last one OR its been pressed for 500+ ms, acknowledge as a legitimate press if (prevKey != key || downTime++ > 500)
{
// Store key in DPRAM for SC12 WRITE_RAM(RAM_KP_LASTKEY, key);
// Send interrupt to SC12
WRITE_RAM(RAM_INT_SEND, SATUS_KP_PRESS);

debugKeypress(key);

// Store current key for debounce prevKey = key;

downTime = 0;
upTime = 0;
}
}

_delay_ms(1);
}
}
#else

while (1)
{

}
#endif

}

/* ================ FUNCTIONS =============== */
void inline inits()
{
// Write SRE to 1 enables the External Memory Interface MCUCR = 0x80;

// Magic numbers
WRITE_RAM(RAM_VERSION_1, 42); WRITE_RAM(RAM_VERSION_2, 0x42);

// LCD Port Setup
LCD_DDR = 0xFF;

268 | // Keypad Port Setup (bit 0-3 = in; bit 4-7 = out)
269 | KP_DDR = 0xF0;
270
271 | // LED port all output
272 | LEDS_DDR = 0xEF;
273 | LEDS_PORT = (uint8_t)~0xEF;
274
275 | // Enable falling edge interrupt INT4
276 | EICRB = 0x02;
277 | EIMSK = 0x10;
278
279 | // LCD init
280 | _delay_ms(100);
281
282 | // Set 4 bit mode
283 | sendLCDNible(0x02, 0);
284 | // 2-line mode, display on
285 | sendLCDInstructionByte(0x0C);
286 | _delay_ms(100);
287
288 | // Display ON/OFF Control
289 | sendLCDInstructionByte(0x0F);
290 | // Clear & home
291 | sendLCDInstructionByte(0x01);
292 | _delay_ms(20);
293 | // Entry mode Increment & Entire shift off
294 | sendLCDInstructionByte(0x06);
295
296 | // Clear any open interrupts.
297 | volatile uint8_t i = READ_RAM(RAM_INT_GET);
298 | // Global interrupts ON
299 | sei();
300 | }
301
302 | uint8_t inline readMatrix(uint8_t matrix)
303 | {
304 | switch (matrix)
305 | {
306 | default: return 0x00;
307
308 | case 0b00010001: return '1'; // 0x11
309 | case 0b00010010: return '4'; // 0x12
310 | case 0b00010100: return '7'; // 0x13
311 | case 0b00011000: return '*'; // 0x18
312
313 | case 0b00100001: return '2'; // 0x21
314 | case 0b00100010: return '5'; // 0x22
315 | case 0b00100100: return '8'; // 0x24
316 | case 0b00101000: return '0'; // 0x28
317
318 | case 0b01000001: return '3'; // 0x41
319 | case 0b01000010: return '6'; // 0x42
320 | case 0b01000100: return '9'; // 0x44
321 | case 0b01001000: return '#'; // 0x48
322
323 | case 0b10000001: return 'A'; // 0x81
324 | case 0b10000010: return 'B'; // 0x82
325 | case 0b10000100: return 'C'; // 0x84
326 | case 0b10001000: return 'D'; // 0x88
327 | }
328 | }
329
330 | /* ############## START SECTION WS2812 DRIVER ##############
331 | * Original Source: | https://github.com/cpldcpu/light_ws2812/
332 | * Original Author: | Tim (cpldcpu@gmail.com)
333 | * Original License: | GNU GPL V2
334 | (https://github.com/cpldcpu/light_ws2812/blob/master/License.txt)

335 | * | This license still applies to everything between the "WS2812 DRIVER"
336 | section lines.
337 | *
338 | * Modifications by Dries007:
339 | * - | Changed configuration
340 | * - | Merged library into single set of source and header files
341 | */
342 | void inline sendLEDS(uint16_t leds)
343 | {
344 | // 3 colors!
345 | uint16_t datlen = leds + leds + leds;
346 | // Type cast
347 | uint8_t * data = (uint8_t *) LEDS;
348
349 | // Save interrupt status
350 | uint8_t sreg_prev = SREG;
351 | // We can't be interrupted!
352 | cli();
353
354 | uint8_t maskhi = _BV(LEDS_PIN);
355 | // Low mask
356 | uint8_t masklo = ~maskhi&LEDS_PORT;
357 | // High mask
358 | maskhi |= LEDS_PORT;
359
360 | // used in ASM
361 | uint8_t curbyte, ctr;
362 | while (datlen--)
363 | {
364 | curbyte = *data ++; // Grab byte
365
366 | asm volatile(
367 | " | ldi | %0,8 \n\t" // Write 8 (00001000) to Loop counter (%0)
368 | "loop%=: | \n\t" // Loop entry point (%= is a unique number
369 | on each asm statement)
370 | " | out | %2,%3 \n\t" // Write High mask (%3) to LED_PORT (%2)
371 | #if (w1_nops&1) | // w1 nops for timing
372 | w_nop1
373 | #endif
374 | #if (w1_nops&2)
375 | w_nop2
376 | #endif
377 | #if (w1_nops&4)
378 | w_nop4
379 | #endif
380 | #if (w1_nops&8)
381 | w_nop8
382 | #endif
383 | #if (w1_nops&16)
384 | w_nop16
385 | #endif
386 | " | sbrs %1,7 \n\t" // Skip next instruction if bit 7 of Data
387 | (%1) is set
388 | " | out | %2,%4 \n\t" // Write Low mask (%4) to LED_PORT (%2)
389 | " | lsl | %1 | \n\t" // Shift Data (%1) left
390 | #if (w2_nops&1) // w2 nops for timing
391 | w_nop1
392 | #endif
393 | #if (w2_nops&2)
394 | w_nop2
395 | #endif
396 | #if (w2_nops&4)
397 | w_nop4
398 | #endif
399 | #if (w2_nops&8)
400 | w_nop8
401 | #endif

402 | #if (w2_nops&16)
403 | w_nop16
404 | #endif
405 | " | out | %2,%4 \n\t" // Write Low mask (%4) to LED_PORT (%2)
406 | #if (w3_nops&1) // w3 nops for timing
407 | w_nop1
408 | #endif
409 | #if (w3_nops&2)
410 | w_nop2
411 | #endif
412 | #if (w3_nops&4)
413 | w_nop4
414 | #endif
415 | #if (w3_nops&8)
416 | w_nop8
417 | #endif
418 | #if (w3_nops&16)
419 | w_nop16
420 | #endif
421 | " | dec | %0 | \n\t" // Decrement Loop counter (%0) (Also sets Z
422 | if 0x00)
423 | " | brne loop%=\n\t" // Jump to Loop entry point if Z is set.
424 | // %0 = 8 bit loop counter
425 | : | "=&d" (ctr)
426 | : | "r" (curbyte), "I" (_SFR_IO_ADDR(LEDS_PORT)), "r" (maskhi), "r"
427 | (masklo)
428 | // %s1 = Data | %2 = LEDS_PORT | %3 = high mask %4 =
429 | low mask
430 | );
431 | }
432 | SREG = sreg_prev; // Restore interrupt status
433 | _delay_us(50); // Reset delay
434 | }
435 | /* ############## END SECTION WS2812 DRIVER ############## */
436
437 | void sendLCDNible(volatile uint8_t data, uint8_t rs)
438 | {
439 | // Mask out fist 4 bits
440 | data &= 0b00001111;
441 | // Mask in LCD_BACKLIGHT if required (pin 7)s
442 | if (LCD_BACKLIGHT) data |= 0b10000000;
443 | // Mask in register select
444 | if (rs) data |= 0b01000000;
445 | // Bit 4 => 1, its the interrput pin, its on pull-up!
446 | data |= 0b00010000;
447 | // Set Data
448 | LCD_PORT = data;
449 | // Small delay, data needs to be valid BEFORE enable
450 | _delay_us(800);
451 | // Toggle enable
452 | LCD_PORT |= 0b00100000;
453 | // Larger delay, LCD needs time to process
454 | _delay_us(800);
455 | }
456
457 | void sendLCDInstructionByte(uint8_t data)
458 | {
459 | // rs = 0 -> instruction
460 | sendLCDNible(data >> 4, 0);
461 | sendLCDNible(data, 0);
462 | }
463
464 | void sendLCDCharacterByte(char data)
465 | {
466 | // rs = 1 -> data
467 | sendLCDNible(data >> 4, 1);
468 | sendLCDNible(data, 1);

469 }
470
471 | void sendLCDBuffer(char * buffer)
472 | {
473 | // max chars
474 | for (uint8_t i = 0; i < MAX_LCD_CHARS; i++)
475 | {
476 | // End on 0x00
477 | if (buffer[i] == 0x00) break;
478 | sendLCDCharacterByte(buffer[i]);
479 | }
480 | }
