dries007/ModernMasterMind/mastermind1.pdf

# ModernMasterMind

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
Code | Hints

Geel:1 Kleur komt voor

Groen:1 Pin correct
