dries007/ModernMasterMind/Photos/IMG_20150515_184146.jpg

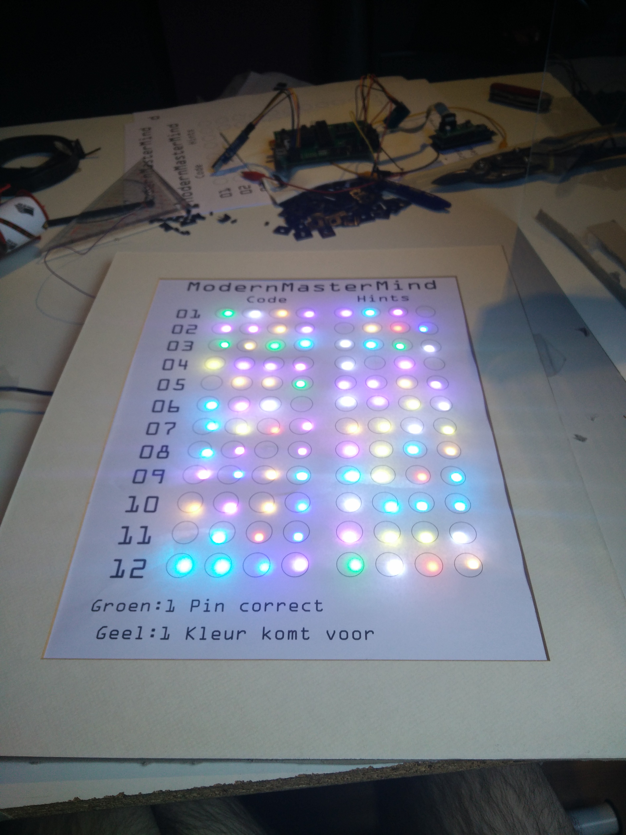
Photos/IMG_20150515_184146.jpg
