dries007/ModernMasterMind/Photos/IMG_20150515_184149.jpg

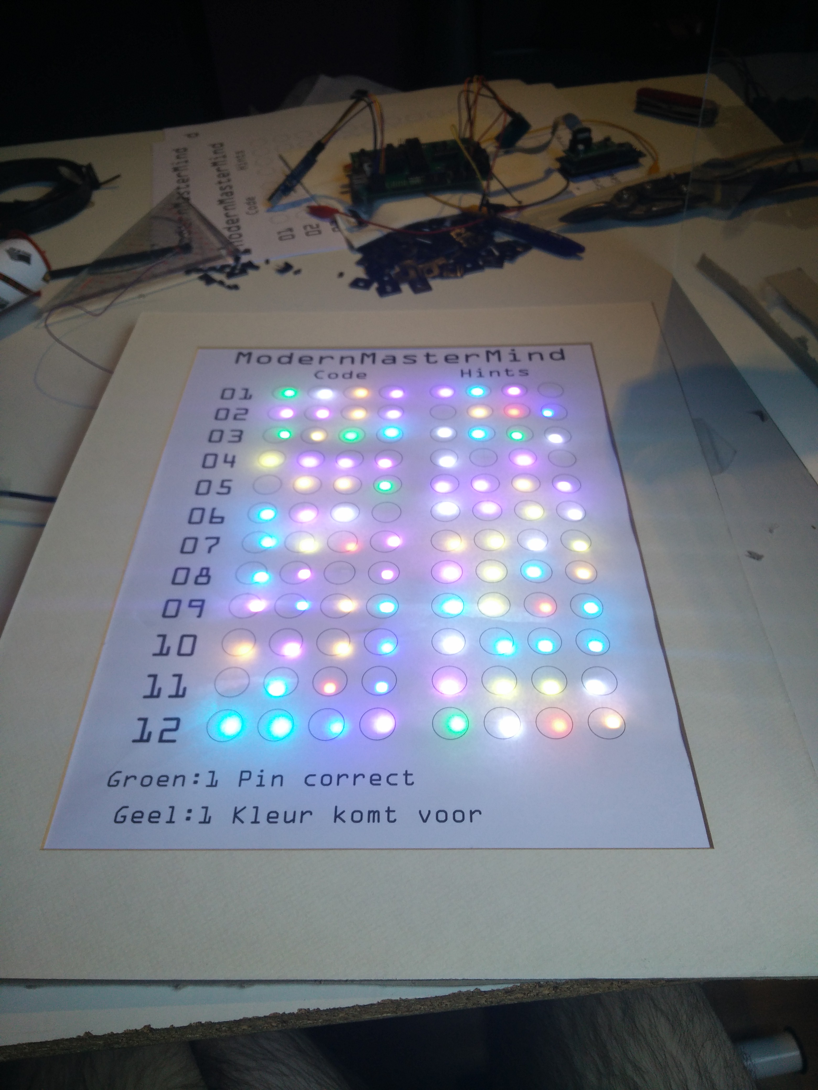
Photos/IMG_20150515_184149.jpg
