dries007/ModernMasterMind/Photos/IMG_20150515_201430.jpg

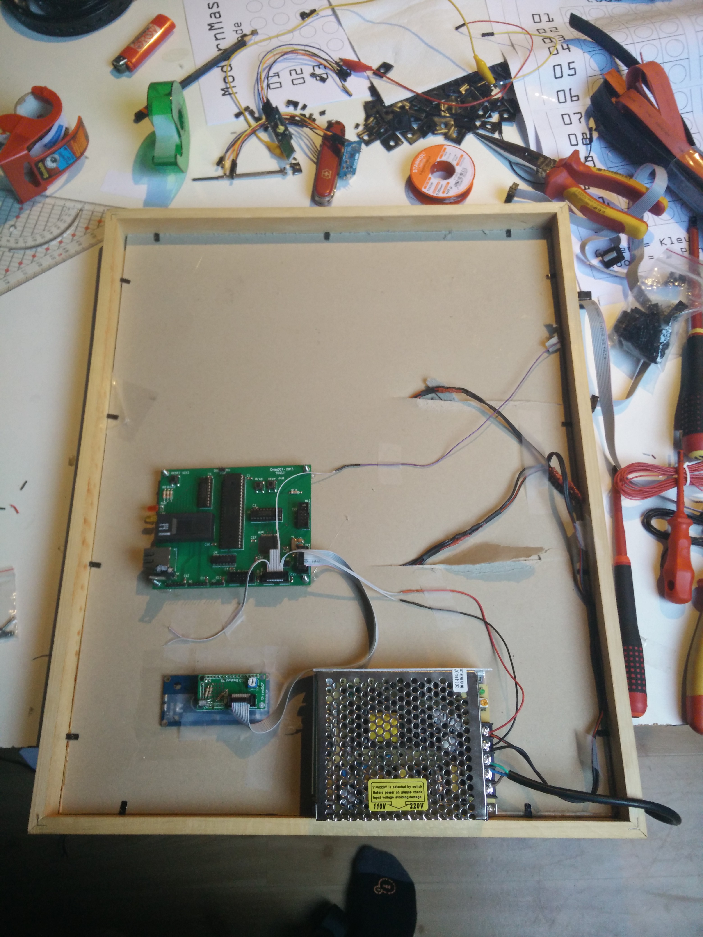
Photos/IMG_20150515_201430.jpg
