dries007/ModernMasterMind/Photos/IMG_20150515_201432.jpg

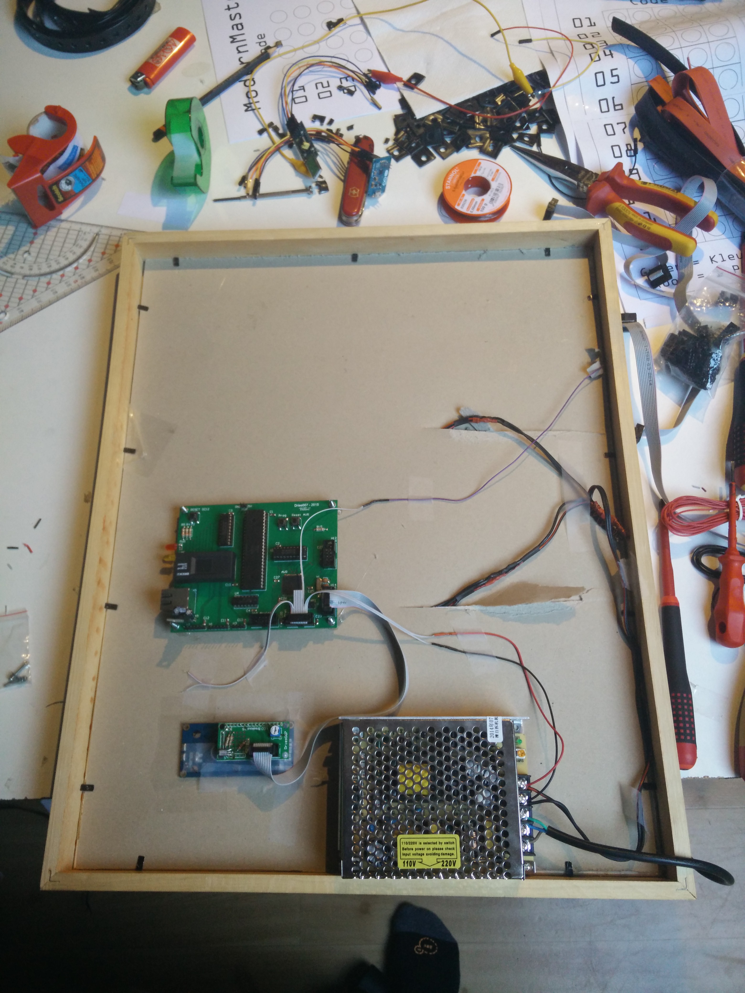
Photos/IMG_20150515_201432.jpg
