dries007/ModernMasterMind/Photos/IMG_20150515_201540.jpg

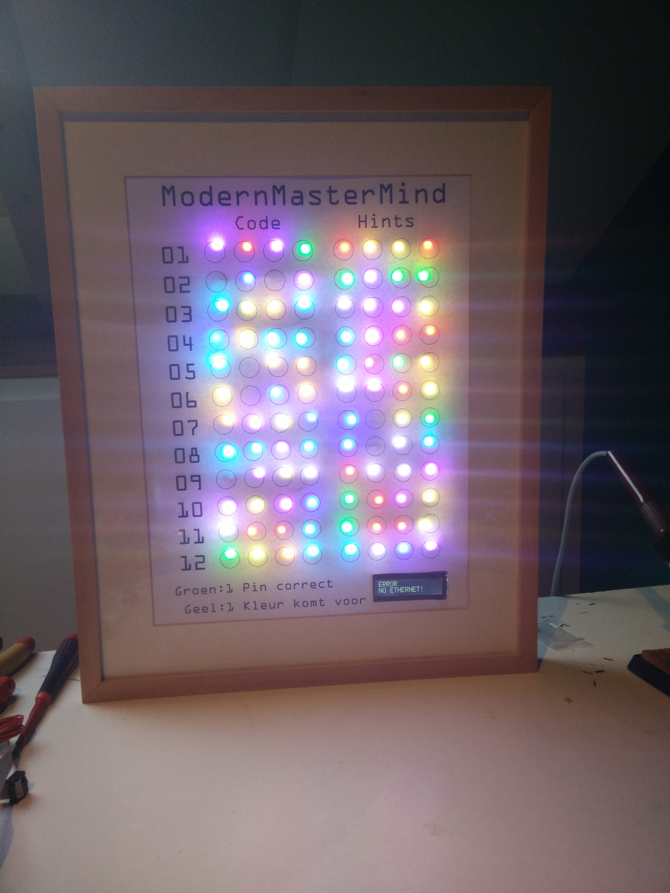
Photos/IMG_20150515_201540.jpg
