dries007/ModernMasterMind/Photos/SAM_8527.JPG

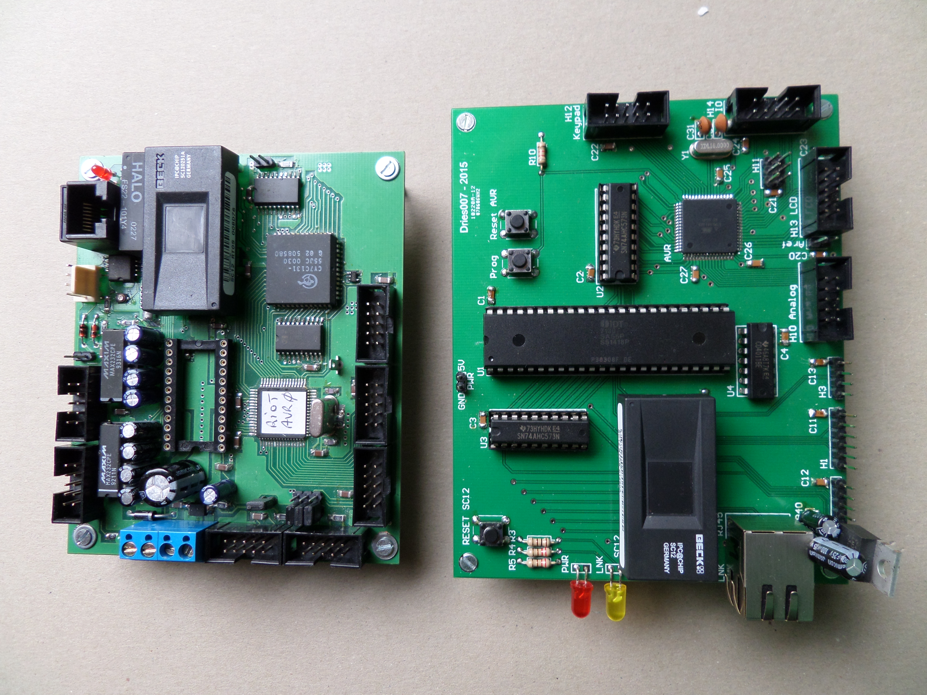
Photos/SAM_8527.JPG
