dries007/ModernMasterMind/Photos/SAM_8529.JPG

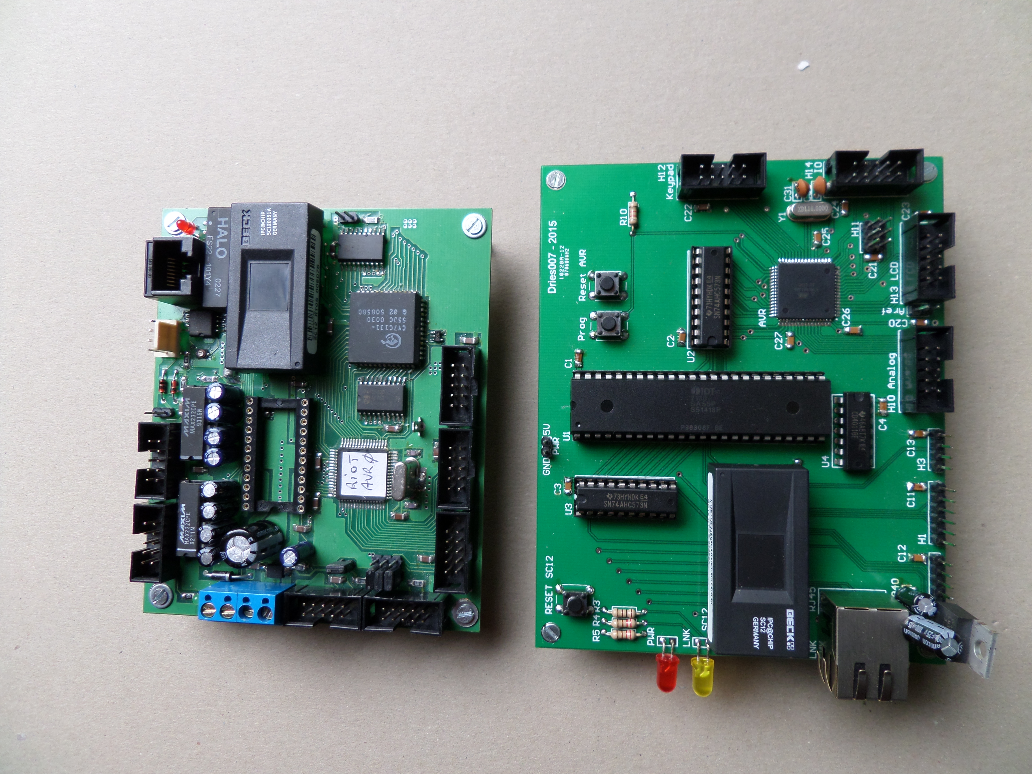
Photos/SAM_8529.JPG
