dries007/ModernMasterMind/Photos/SAM_8531.JPG

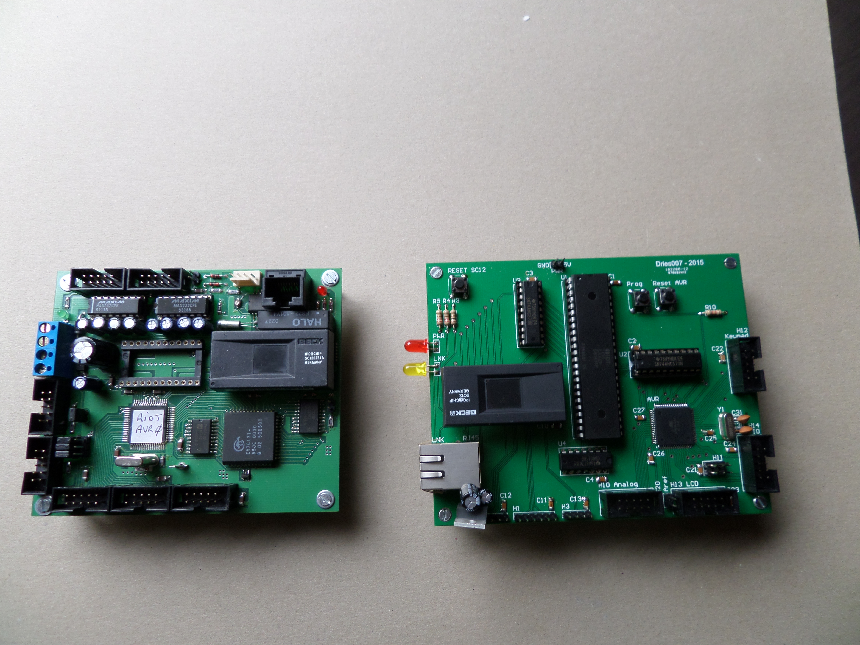
Photos/SAM_8531.JPG
