dries007/ModernMasterMind/Photos/SAM_8532.JPG

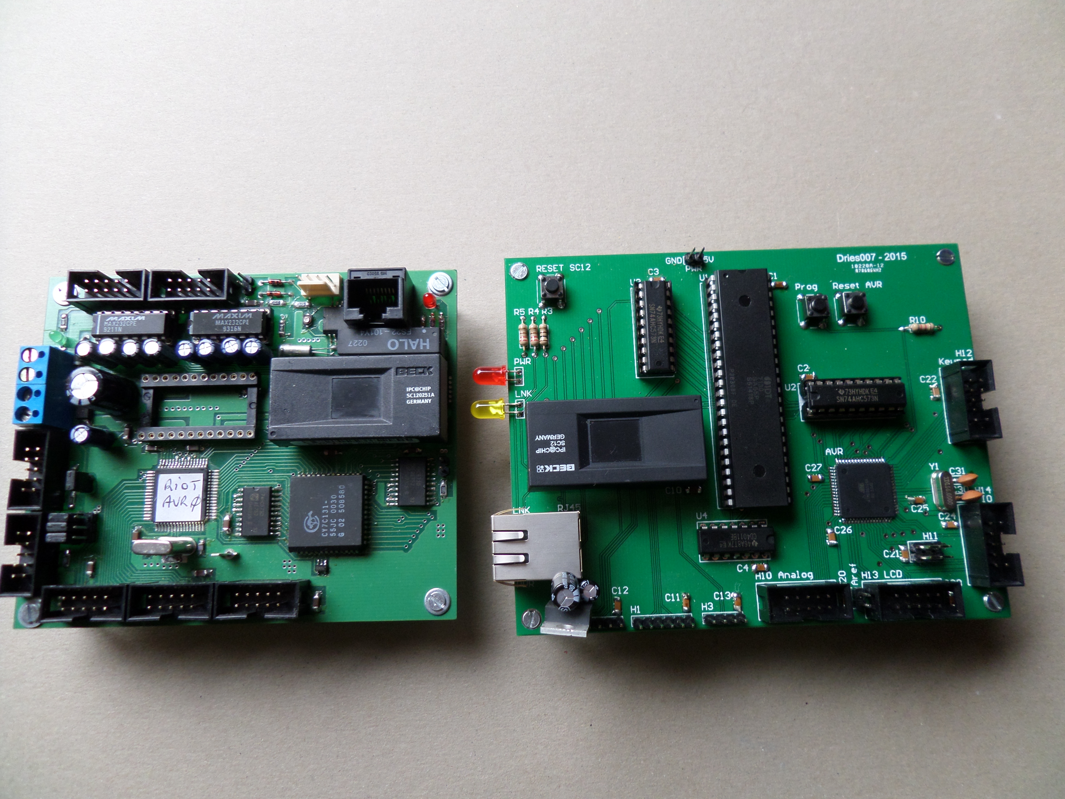
Photos/SAM_8532.JPG
