dries007/ModernMasterMind/Photos/SAM_8533.JPG

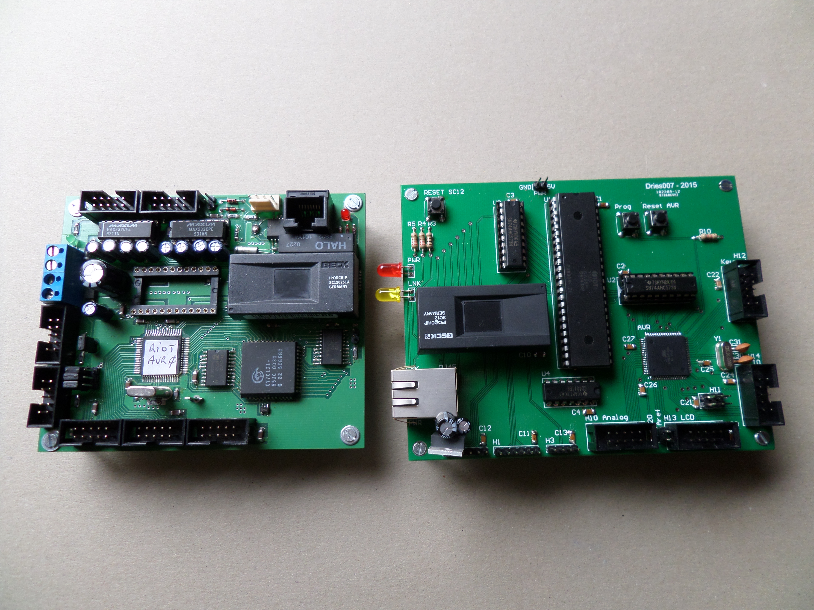
Photos/SAM_8533.JPG
