dries007/ModernMasterMind/Photos/SAM_8534.JPG

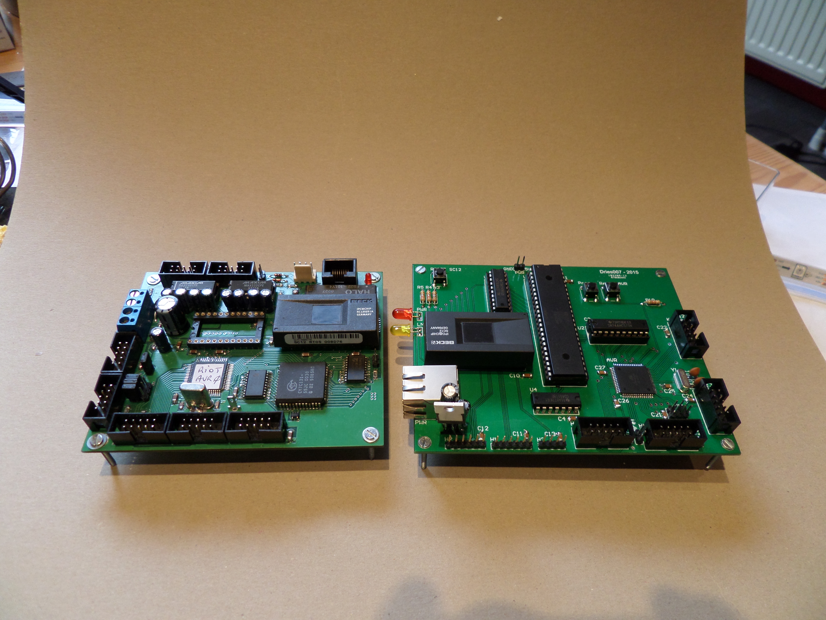
Photos/SAM_8534.JPG
