dries007/ModernMasterMind/Photos/SAM_8536.JPG

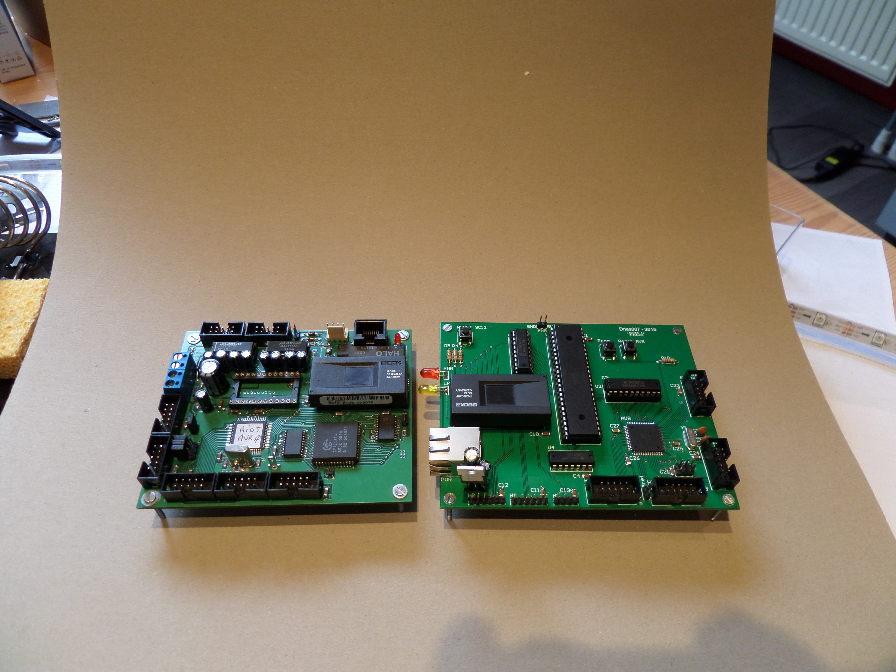
Photos/SAM_8536.JPG
