dries007/ModernMasterMind/Photos/SAM_8537.JPG

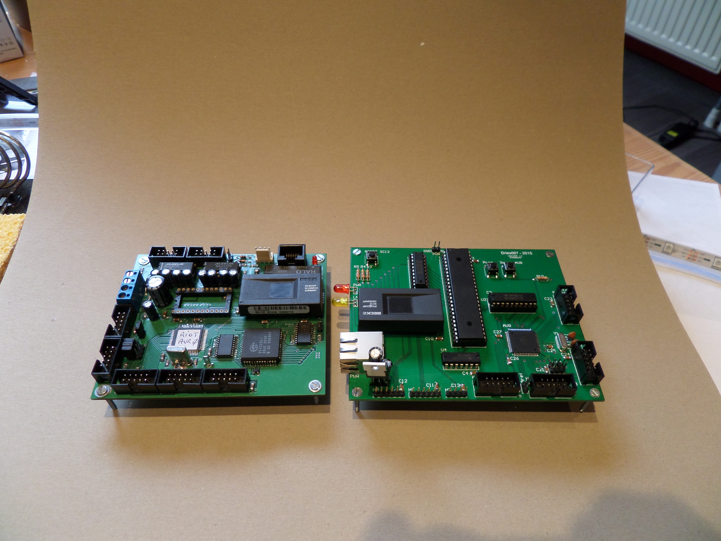
Photos/SAM_8537.JPG
