dries007/ModernMasterMind/Photos/SAM_8538.JPG

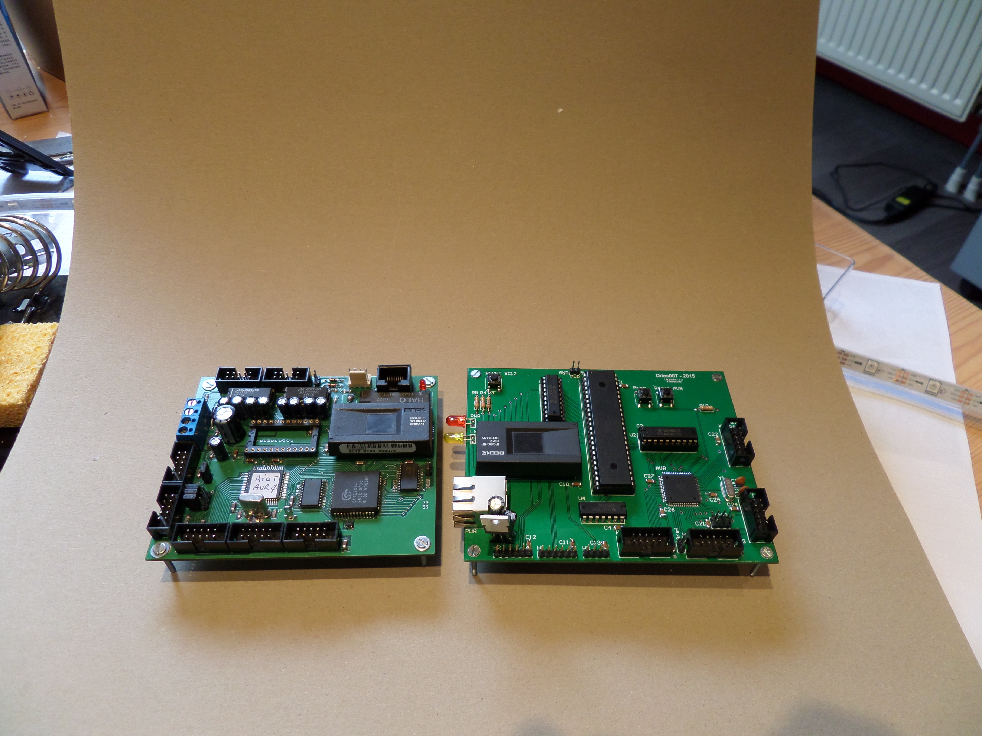
Photos/SAM_8538.JPG
