dries007/ModernMasterMind/Photos/SAM_8539.JPG

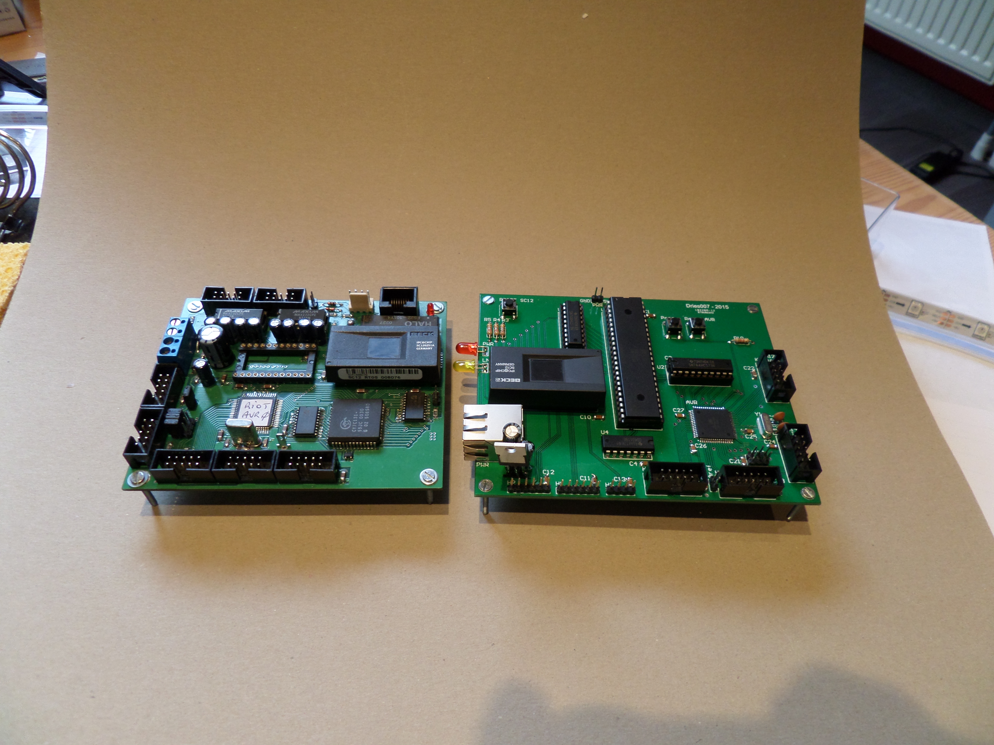
Photos/SAM_8539.JPG
