dries007/ModernMasterMind/Photos/SAM_8540.JPG

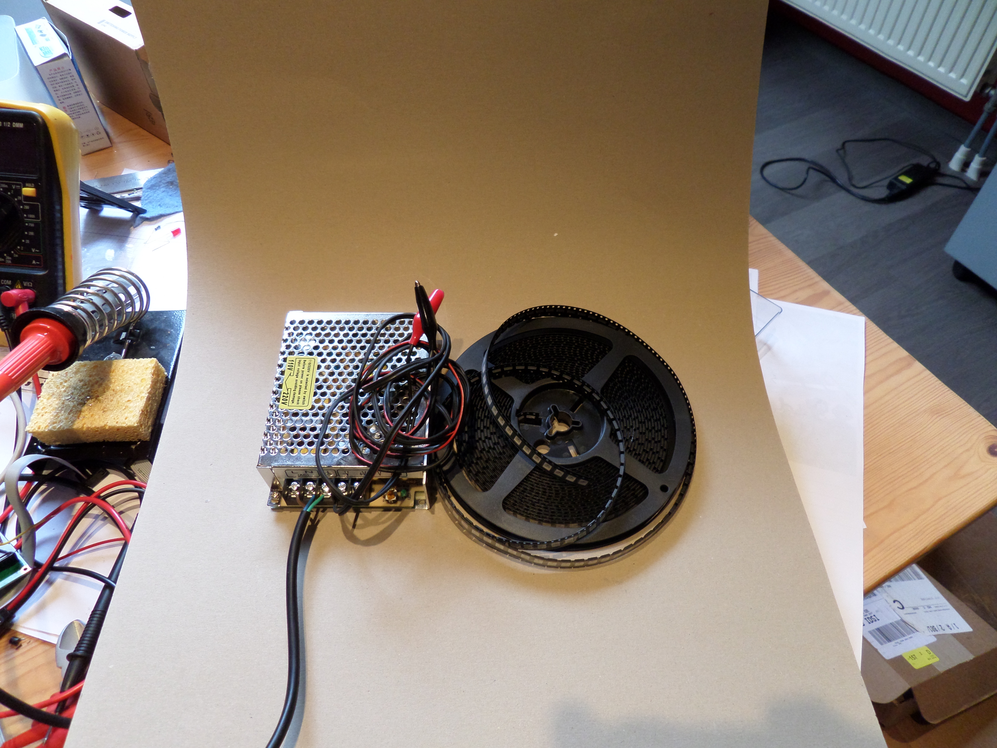
Photos/SAM_8540.JPG
