dries007/ModernMasterMind/Photos/SAM_8541.JPG

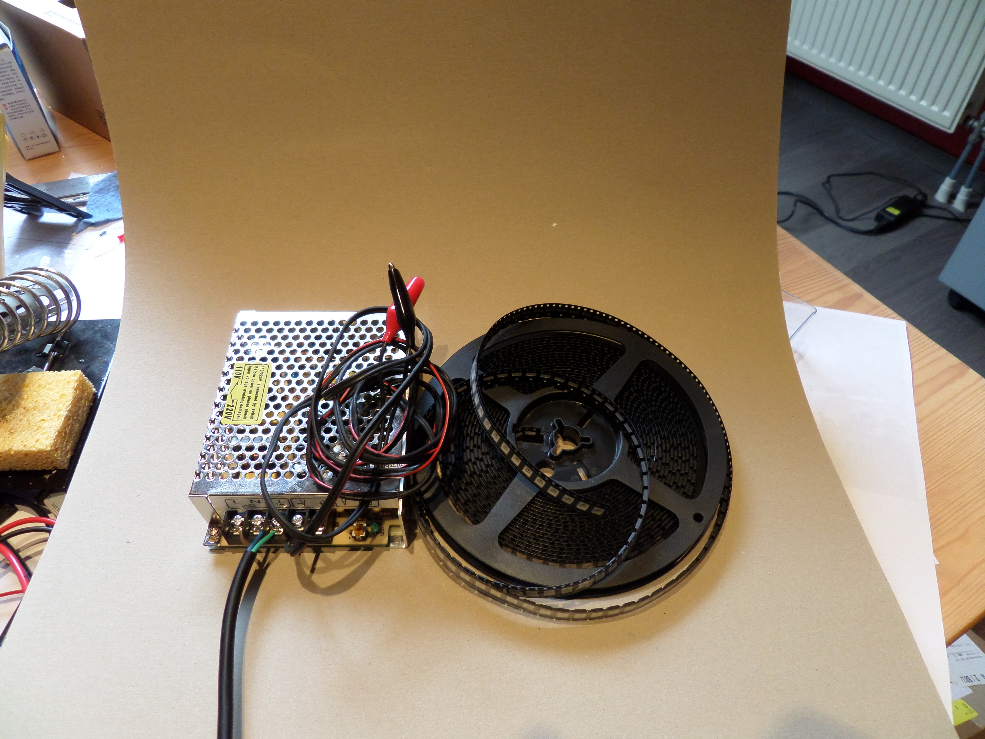
Photos/SAM_8541.JPG
