dries007/ModernMasterMind/Photos/SAM_8542.JPG

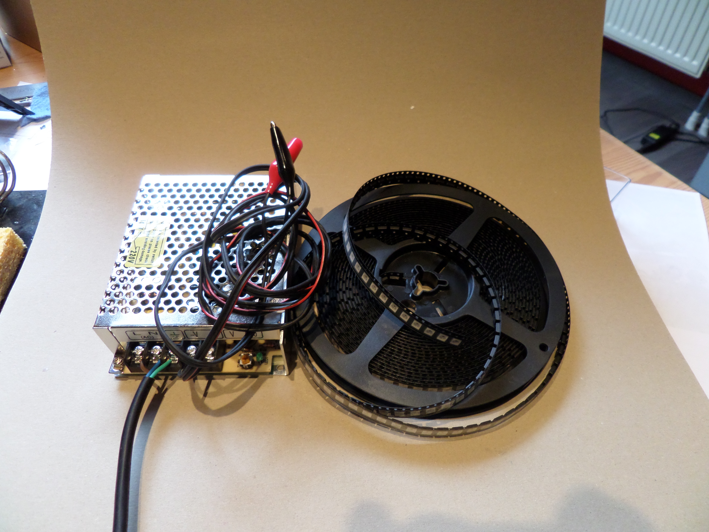
Photos/SAM_8542.JPG
