dries007/ModernMasterMind/Photos/SAM_8543.JPG

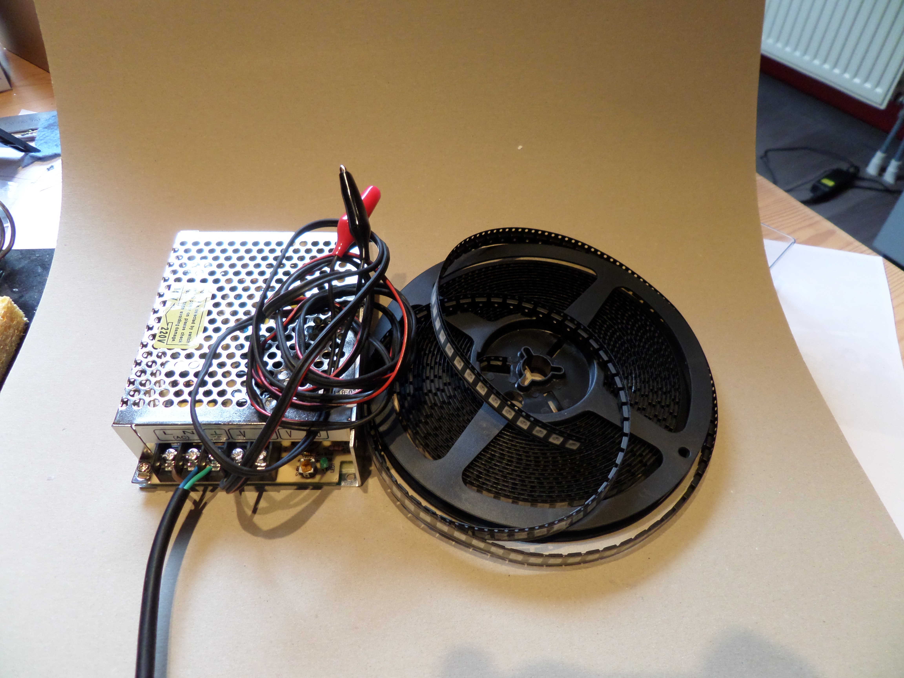
Photos/SAM_8543.JPG
