dries007/ModernMasterMind/Photos/SAM_8544.JPG

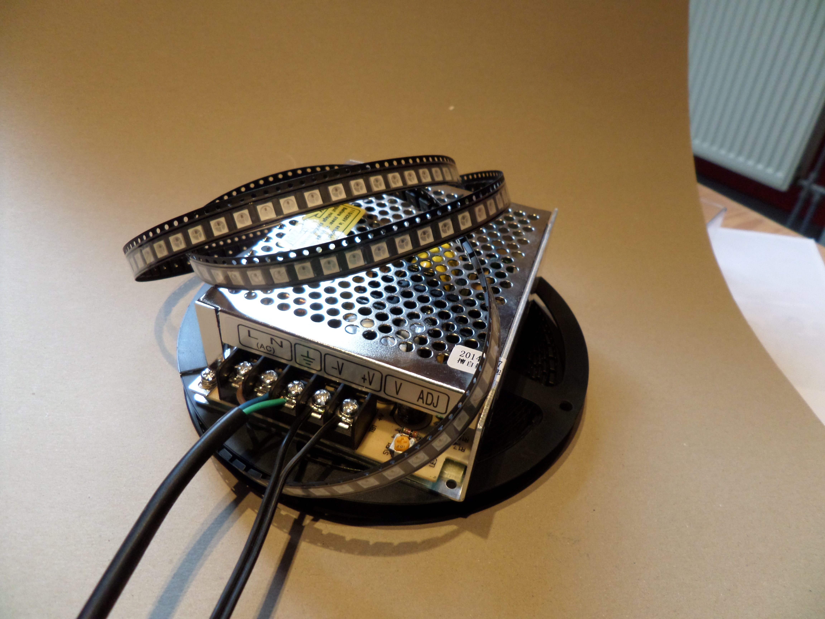
Photos/SAM_8544.JPG
