dries007/ModernMasterMind/Photos/SAM_8545.JPG

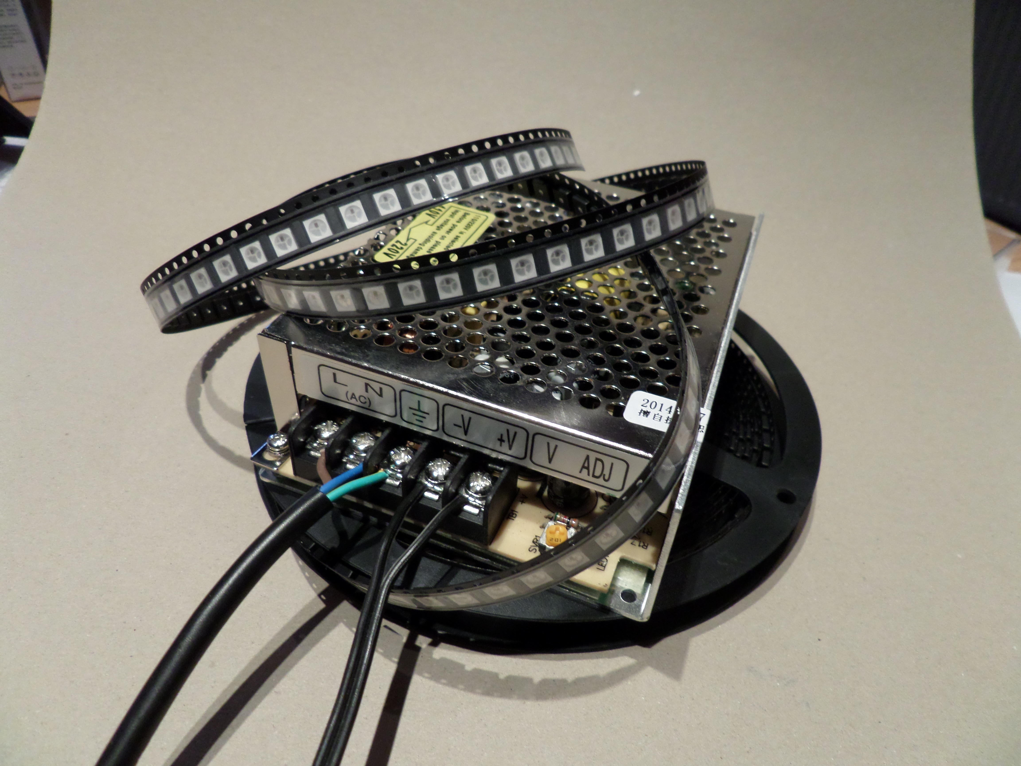
Photos/SAM_8545.JPG
