dries007/ModernMasterMind/Photos/SAM_8546.JPG

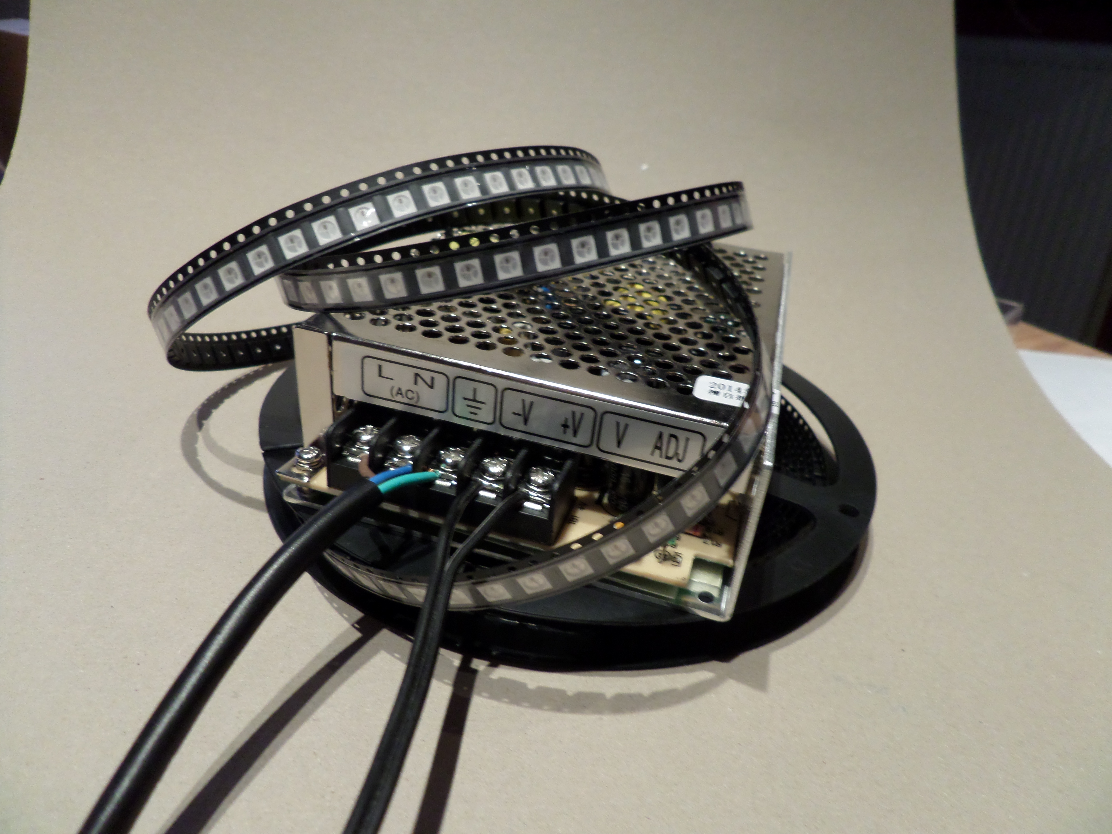
Photos/SAM_8546.JPG
