dries007/ModernMasterMind/Photos/SAM_8548.JPG

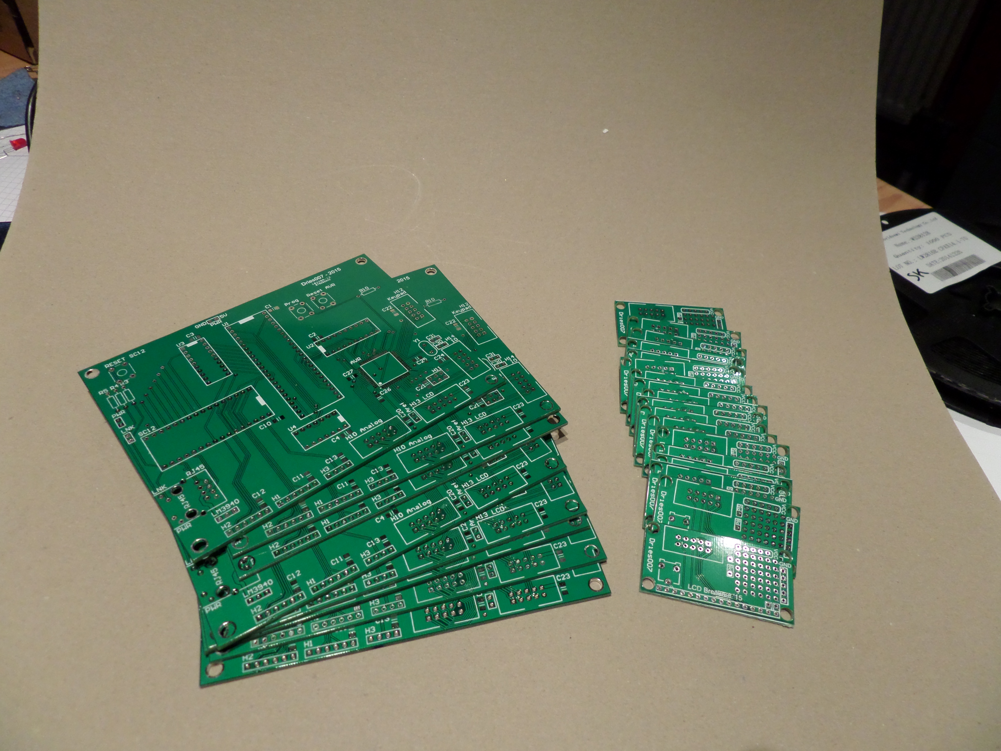
Photos/SAM_8548.JPG
