dries007/ModernMasterMind/Photos/SAM_8549.JPG

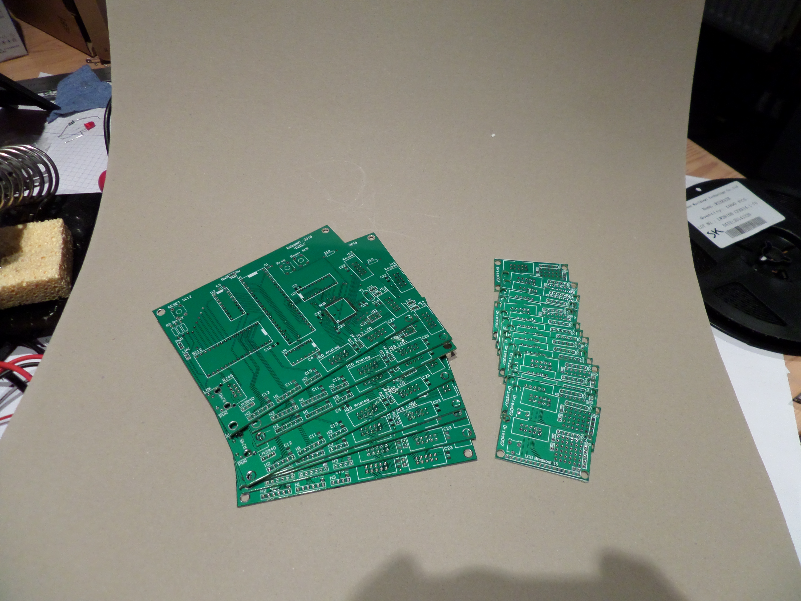
Photos/SAM_8549.JPG
