dries007/ModernMasterMind/Photos/SAM_8550.JPG

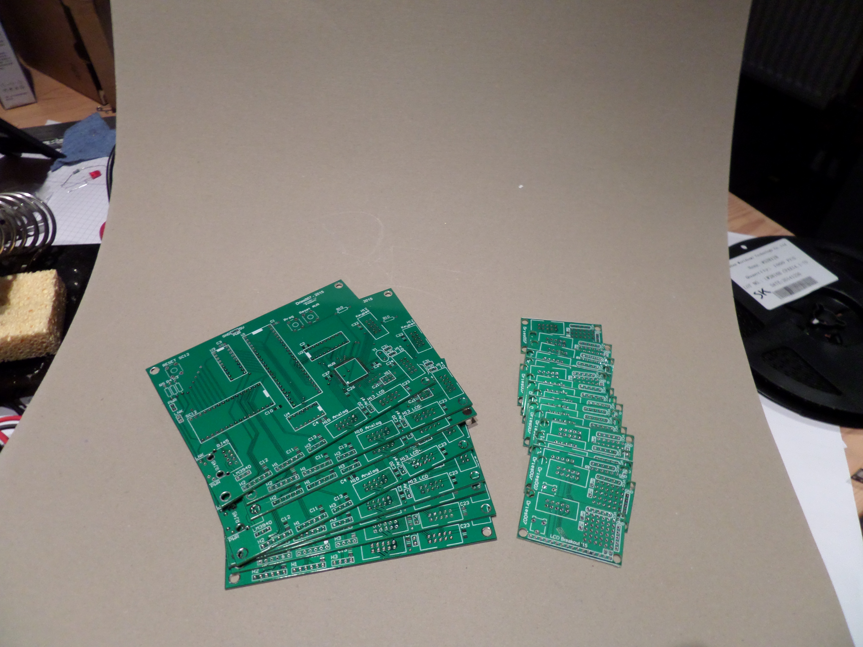
Photos/SAM_8550.JPG
