dries007/ModernMasterMind/Photos/SAM_8551.JPG

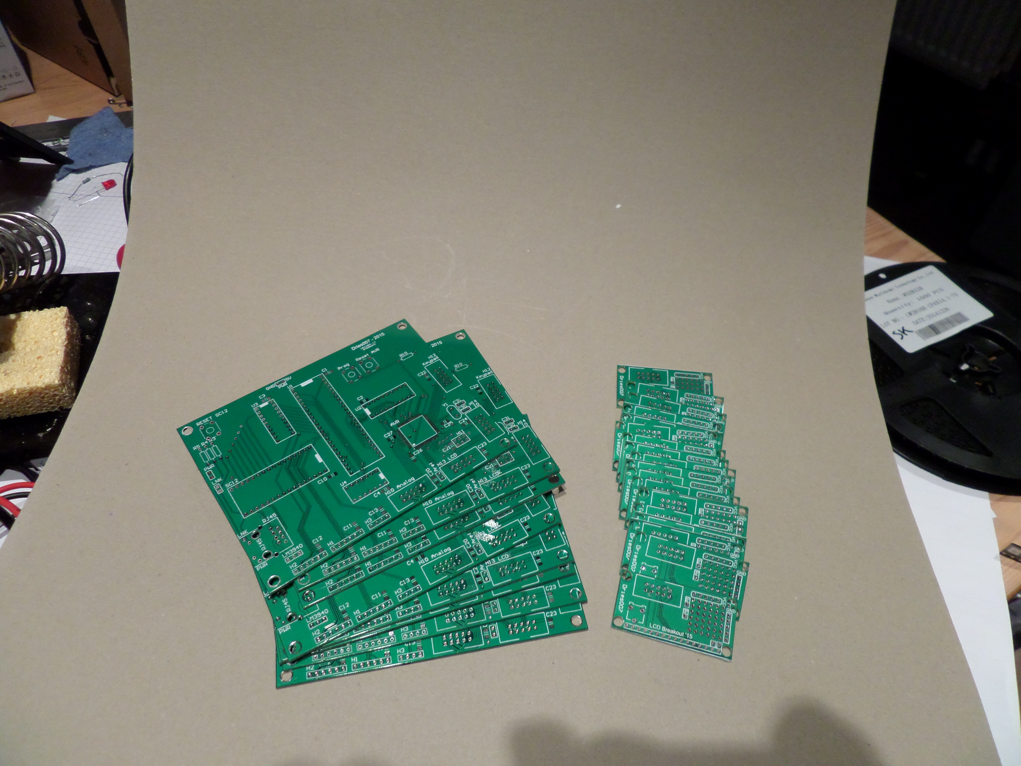
Photos/SAM_8551.JPG
