dries007/ModernMasterMind/Photos/SAM_8552.JPG

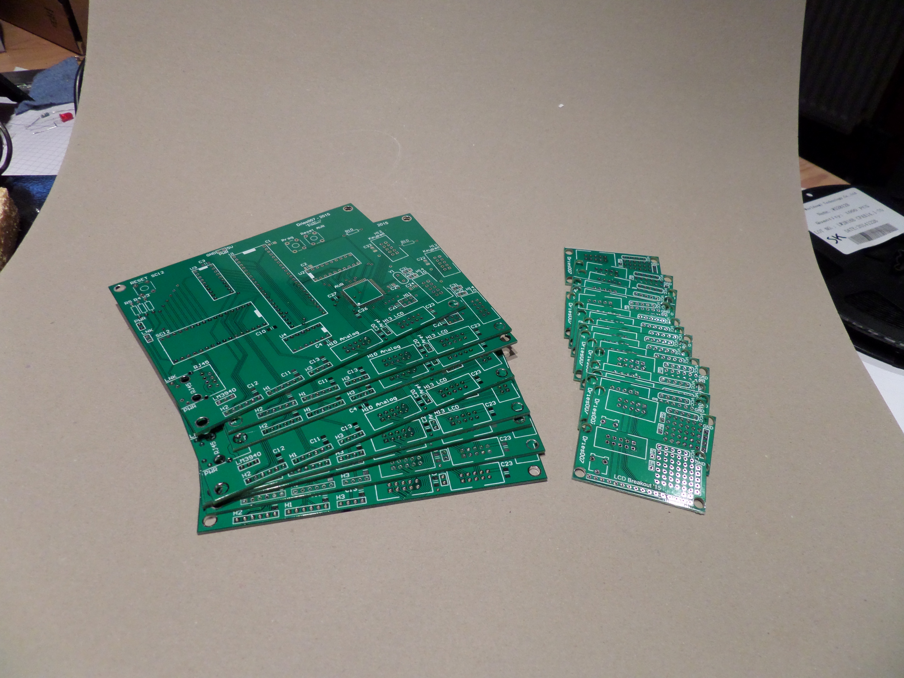
Photos/SAM_8552.JPG
