dries007/ModernMasterMind/Photos/SAM_8574.JPG

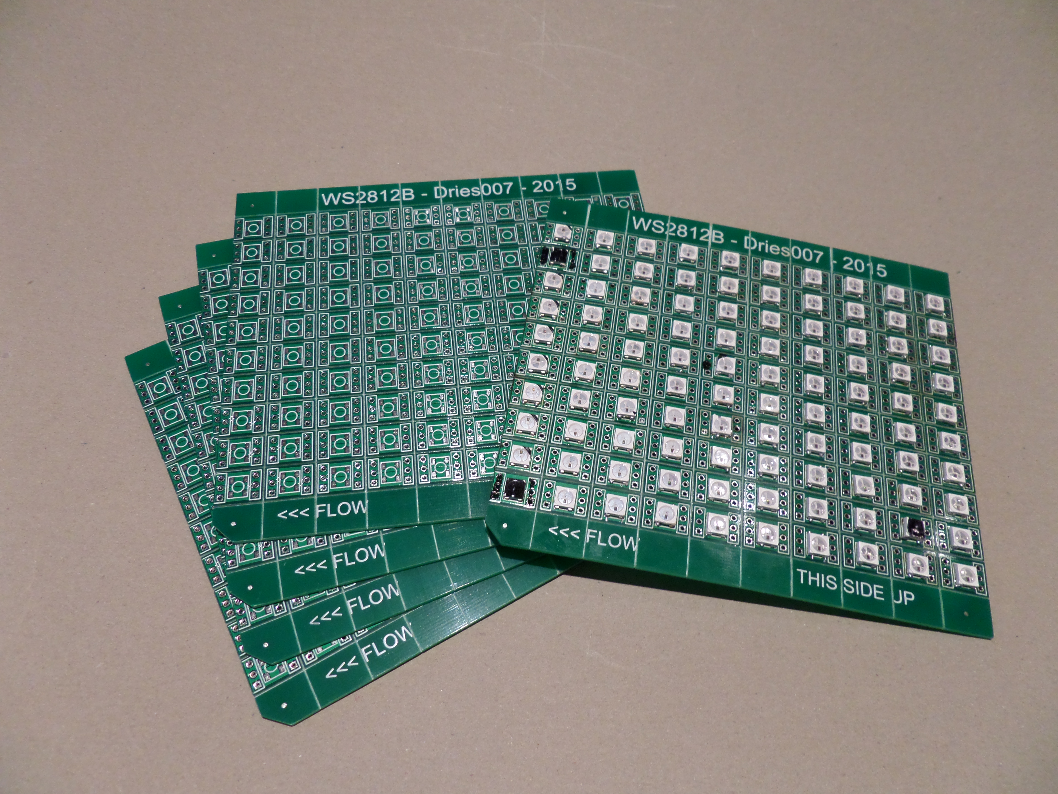
Photos/SAM_8574.JPG
