dries007/ModernMasterMind/Photos/SAM_8575.JPG

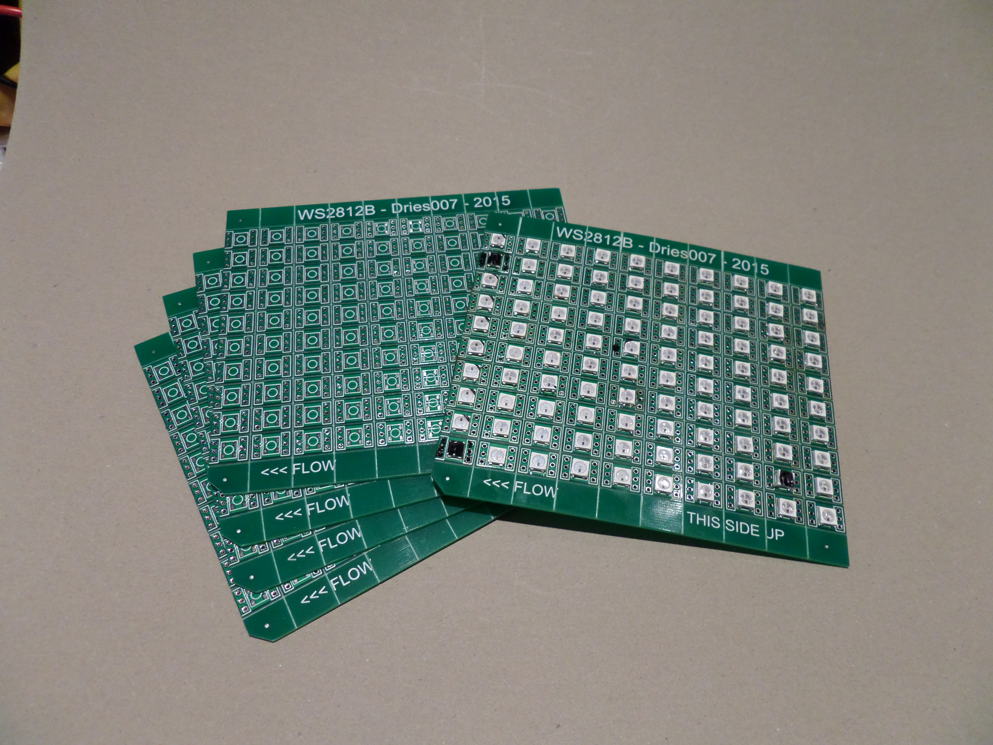
Photos/SAM_8575.JPG
