dries007/ModernMasterMind/Photos/SAM_8576.JPG

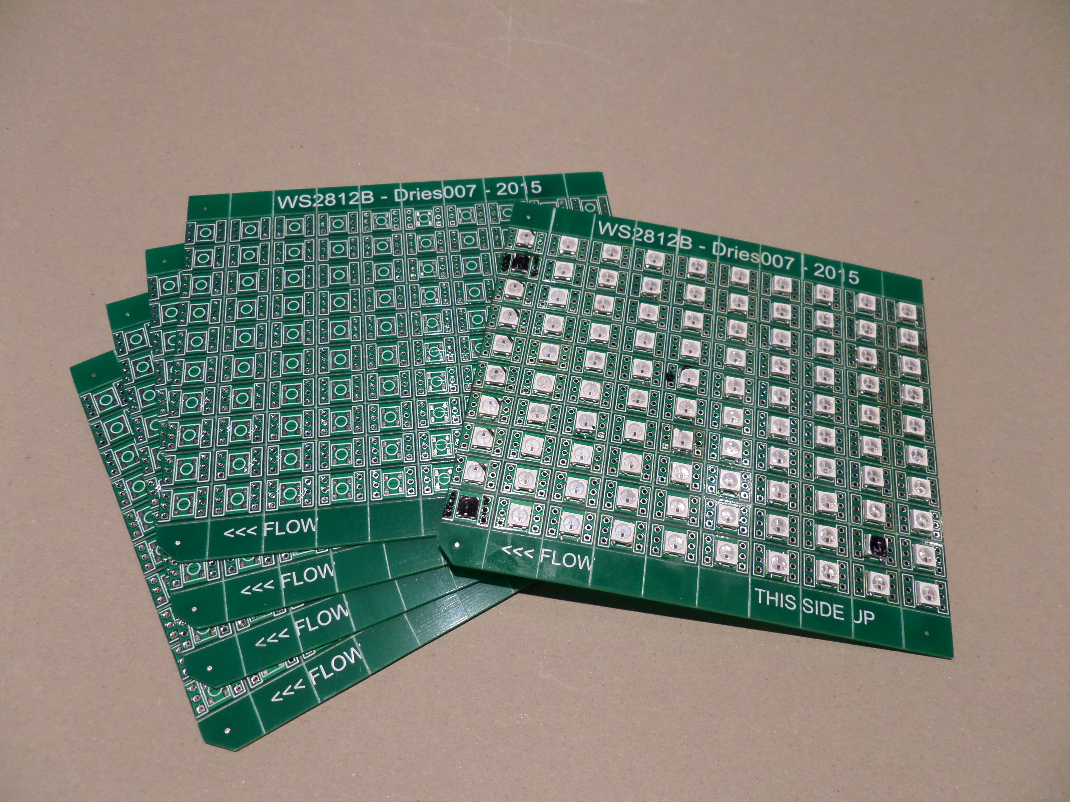
Photos/SAM_8576.JPG
