dries007/ModernMasterMind/Photos/SAM_8578.JPG

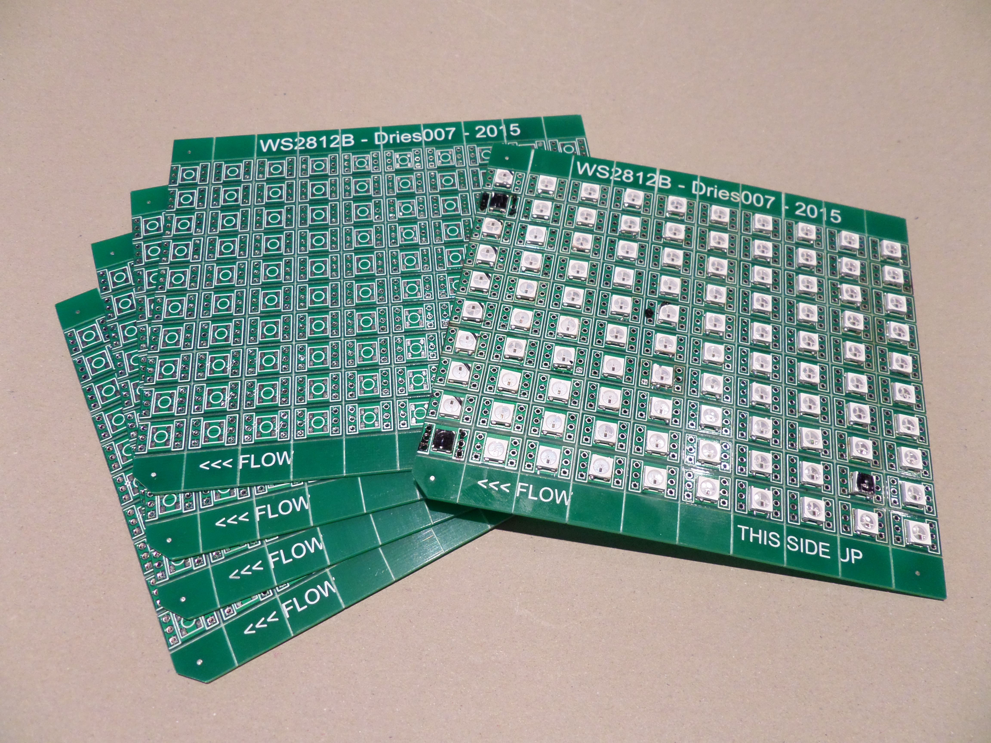
Photos/SAM_8578.JPG
