dries007/ModernMasterMind/Photos/SAM_8579.JPG

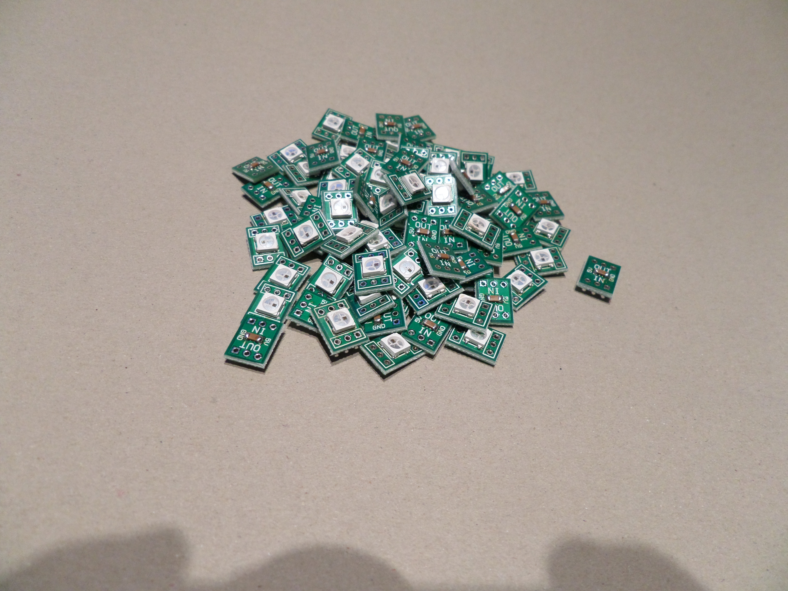
Photos/SAM_8579.JPG
