dries007/ModernMasterMind/Photos/SAM_8580.JPG

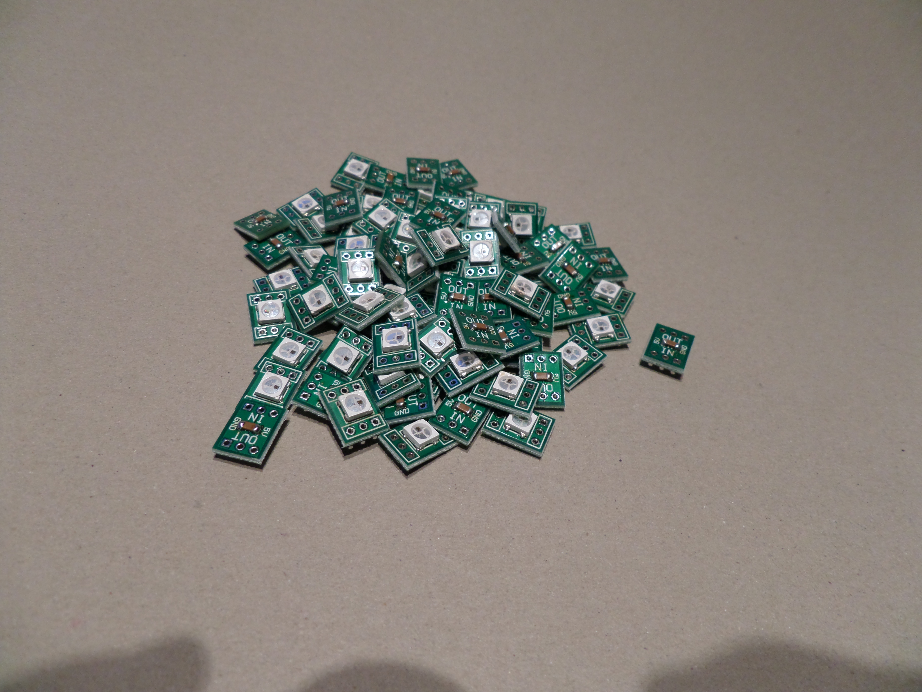
Photos/SAM_8580.JPG
