dries007/ModernMasterMind/Photos/SAM_8581.JPG

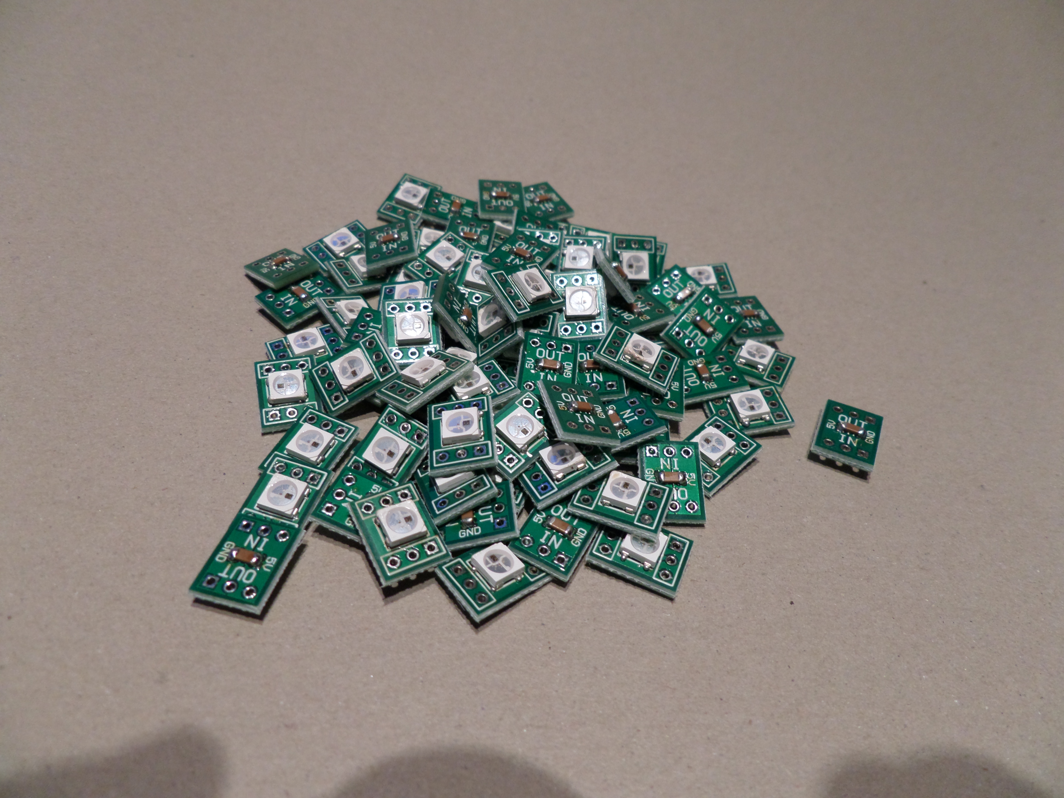
Photos/SAM_8581.JPG
