dries007/ModernMasterMind/Photos/SAM_8582.JPG

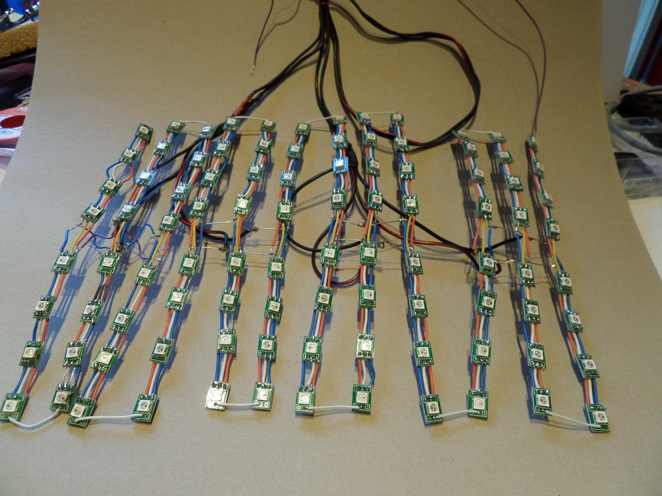
Photos/SAM_8582.JPG
