dries007/ModernMasterMind/Photos/SAM_8583.JPG

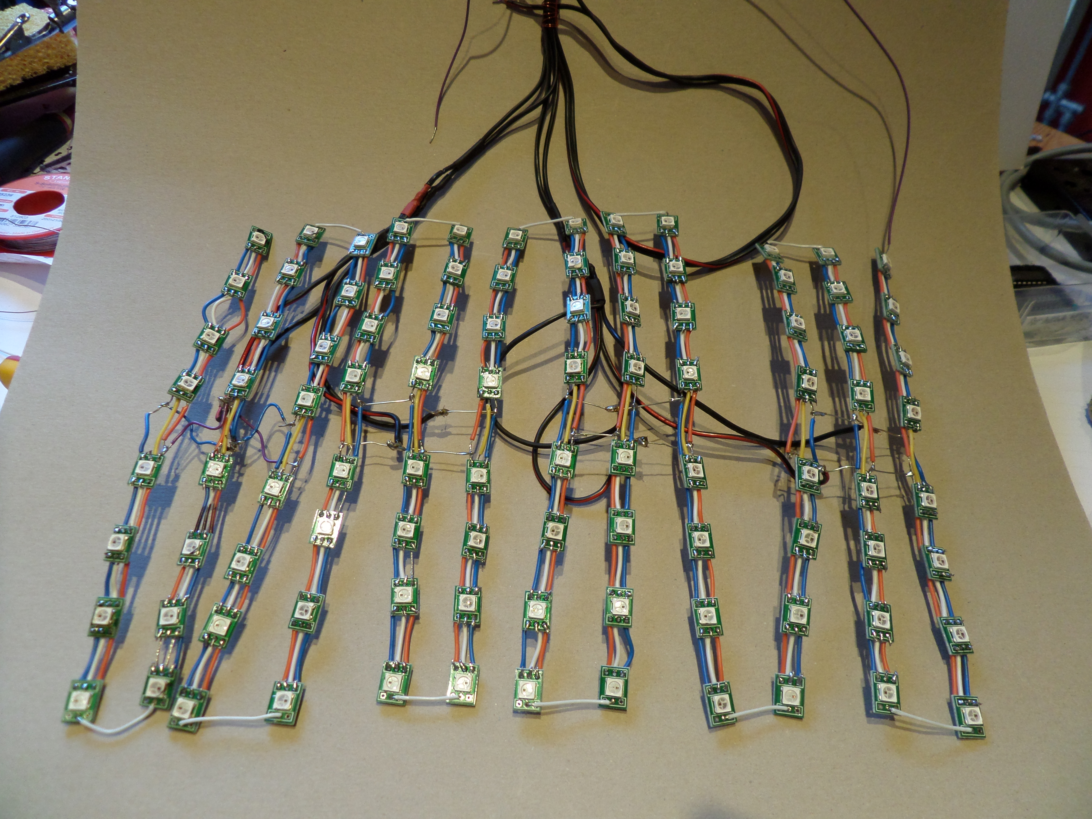
Photos/SAM_8583.JPG
