dries007/ModernMasterMind/Photos/SAM_8584.JPG

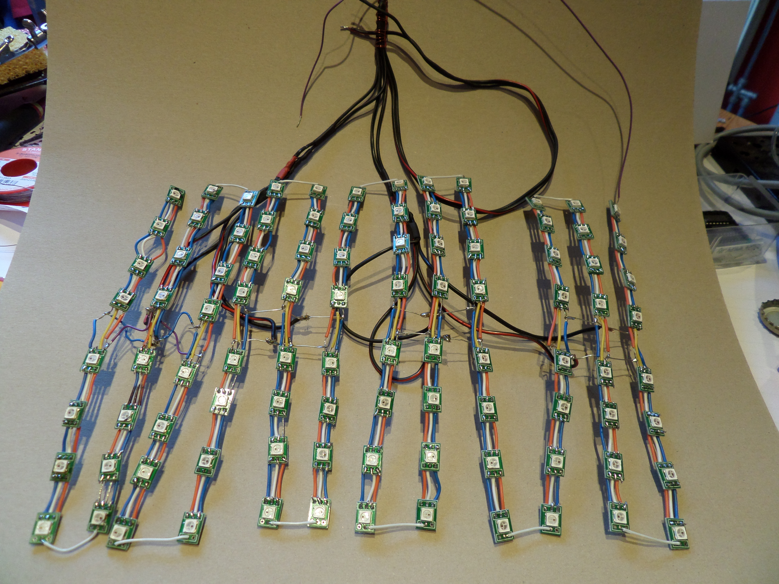
Photos/SAM_8584.JPG
