dries007/ModernMasterMind/Photos/SAM_8585.JPG

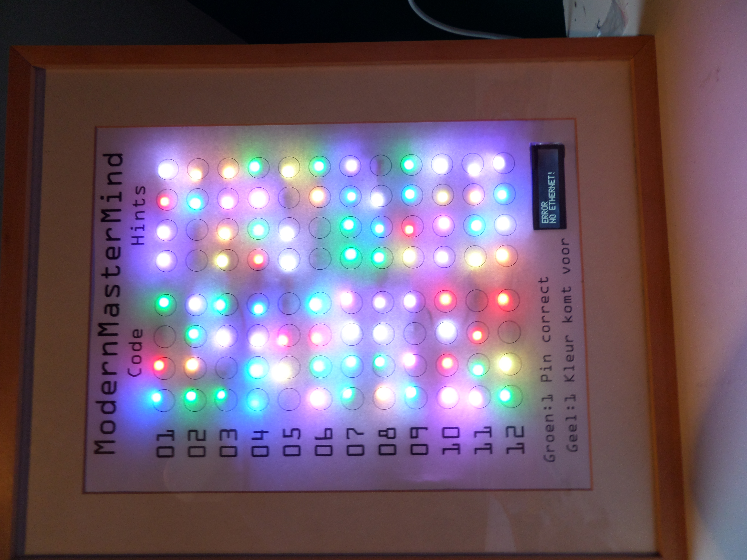
Photos/SAM_8585.JPG
