dries007/ModernMasterMind/Photos/SAM_8586.JPG

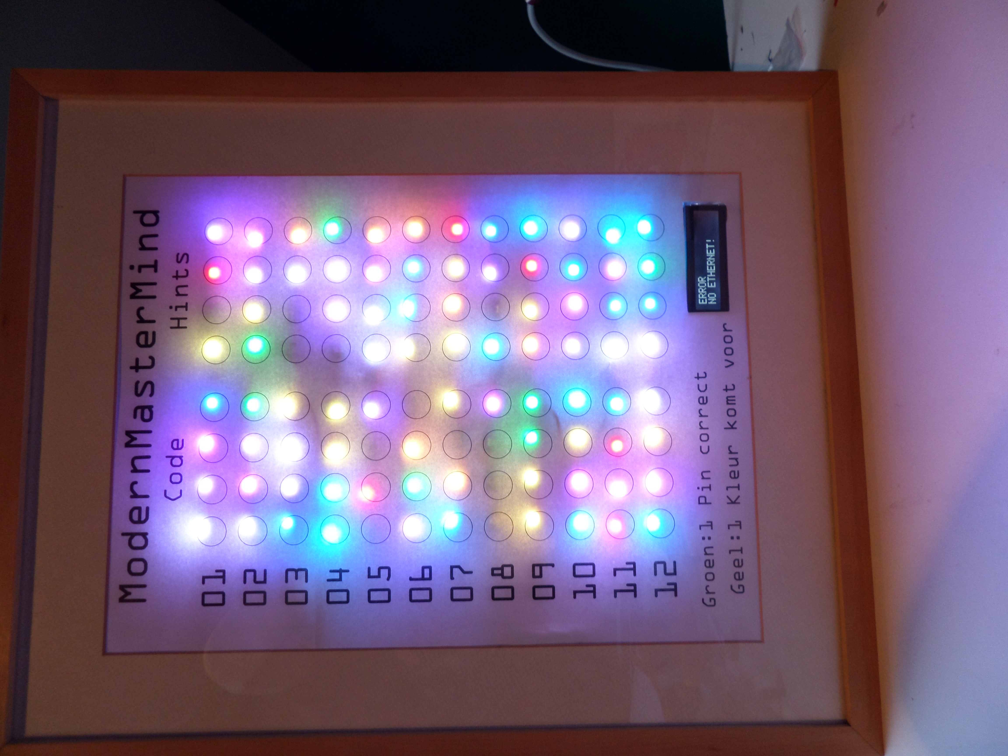
Photos/SAM_8586.JPG
