dries007/ModernMasterMind/Photos/SAM_8587.JPG

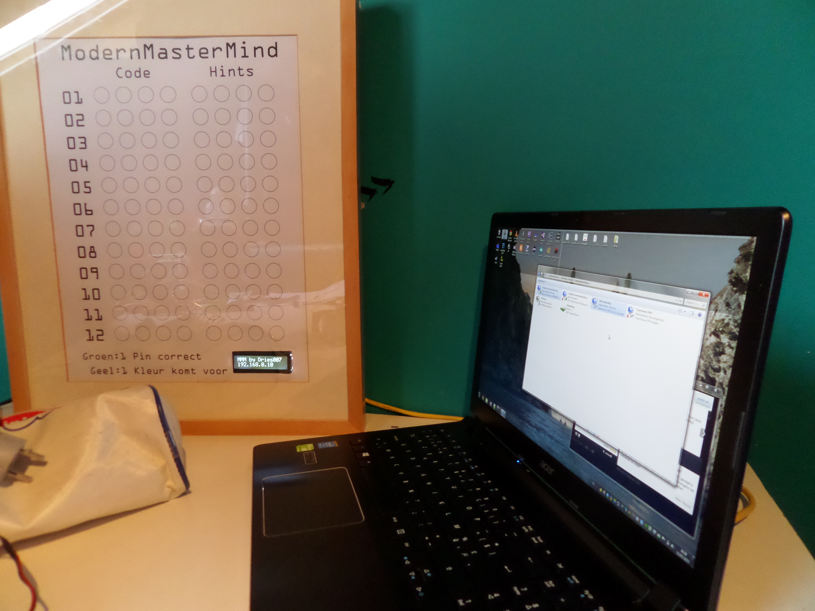
Photos/SAM_8587.JPG
