dries007/ModernMasterMind/Photos/SAM_8588.JPG

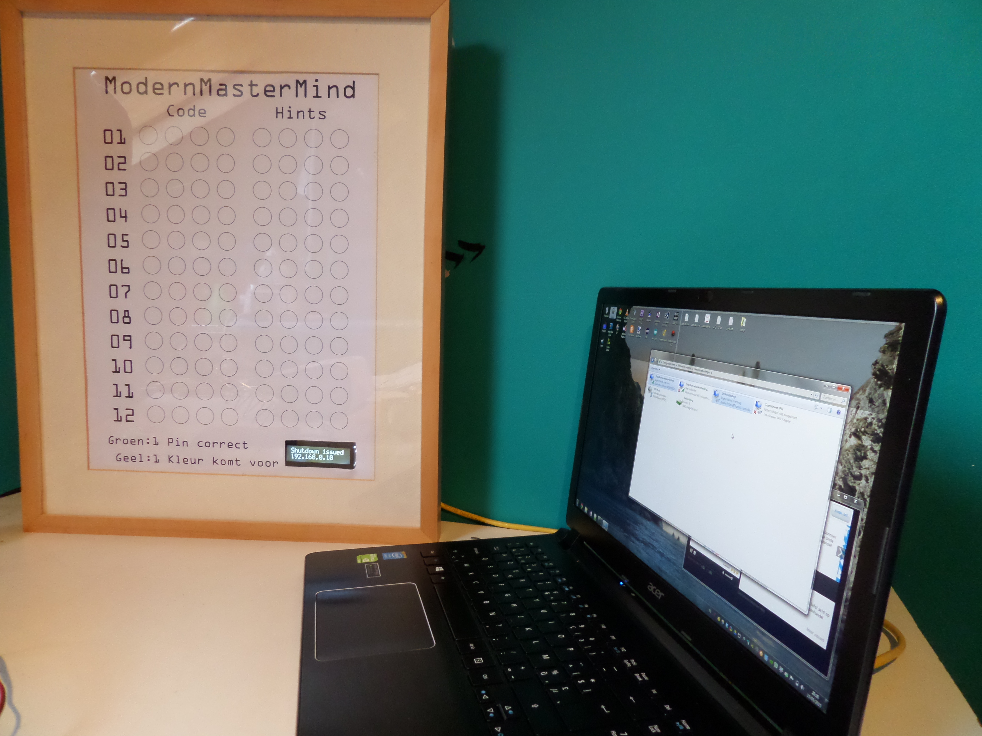
Photos/SAM_8588.JPG
