dries007/ModernMasterMind/Photos/SAM_8589.JPG

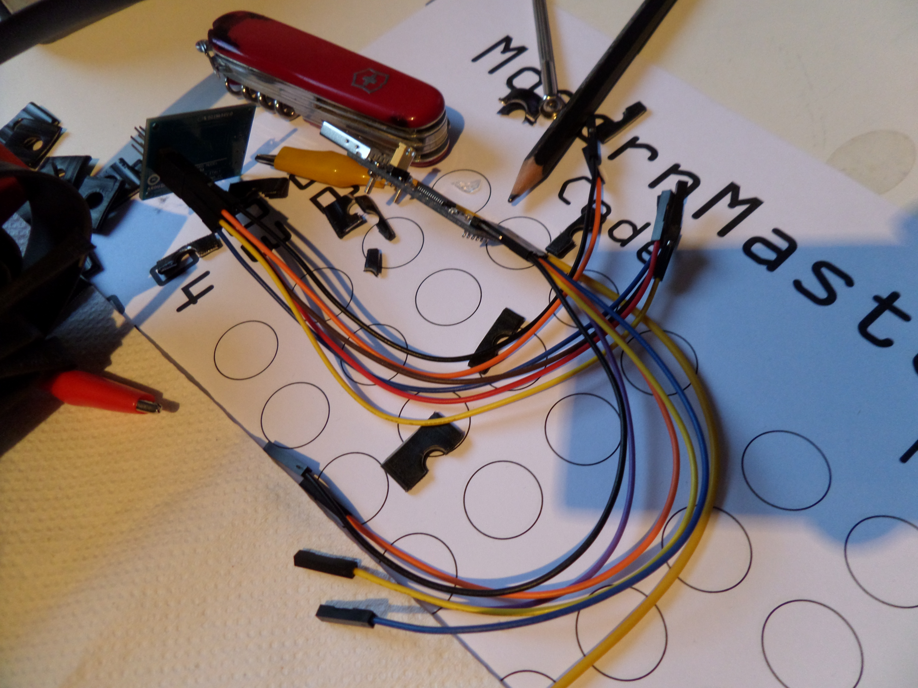
Photos/SAM_8589.JPG
