dries007/ModernMasterMind/Photos/SAM_8590.JPG

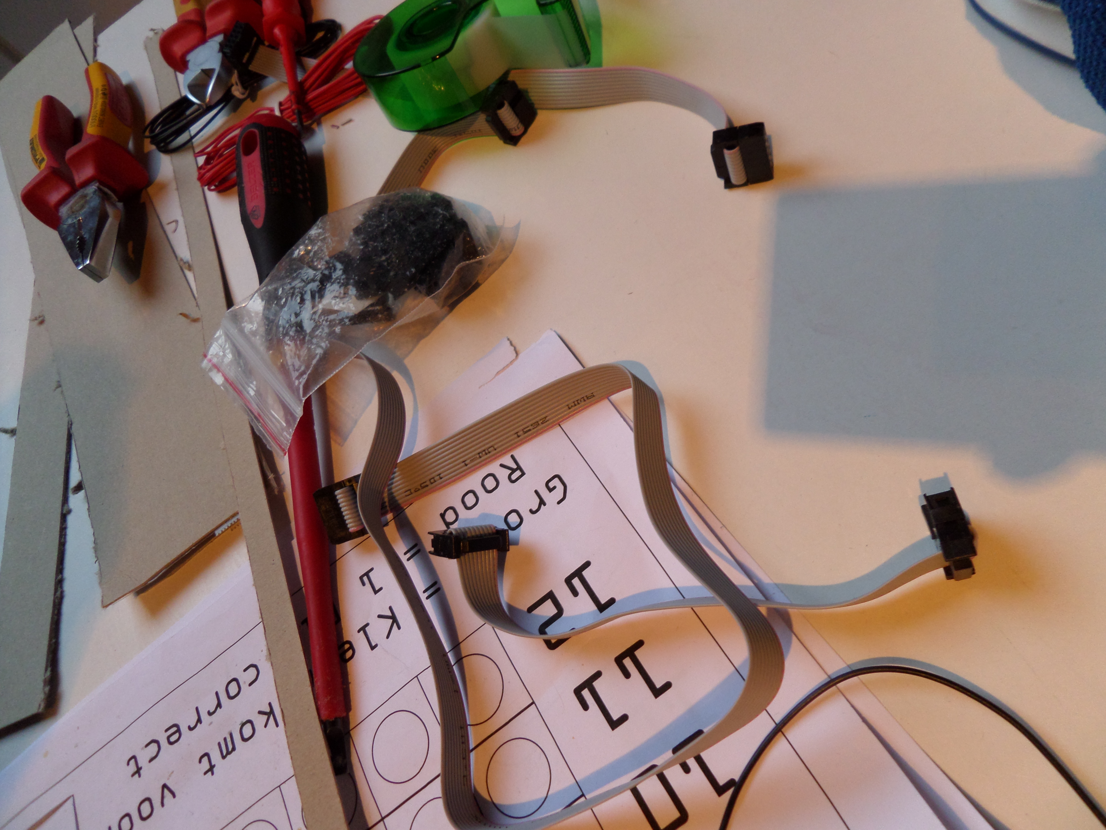
Photos/SAM_8590.JPG
