dries007/ModernMasterMind/Photos/SAM_8591.JPG

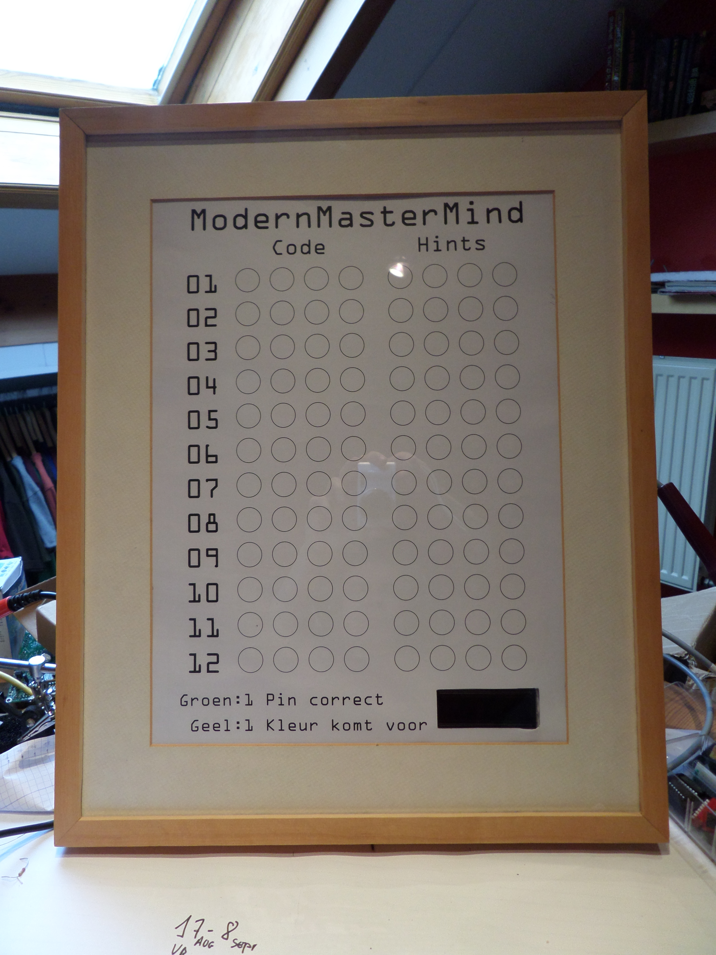
Photos/SAM_8591.JPG
