dries007/ModernMasterMind/Photos/SAM_8592.JPG

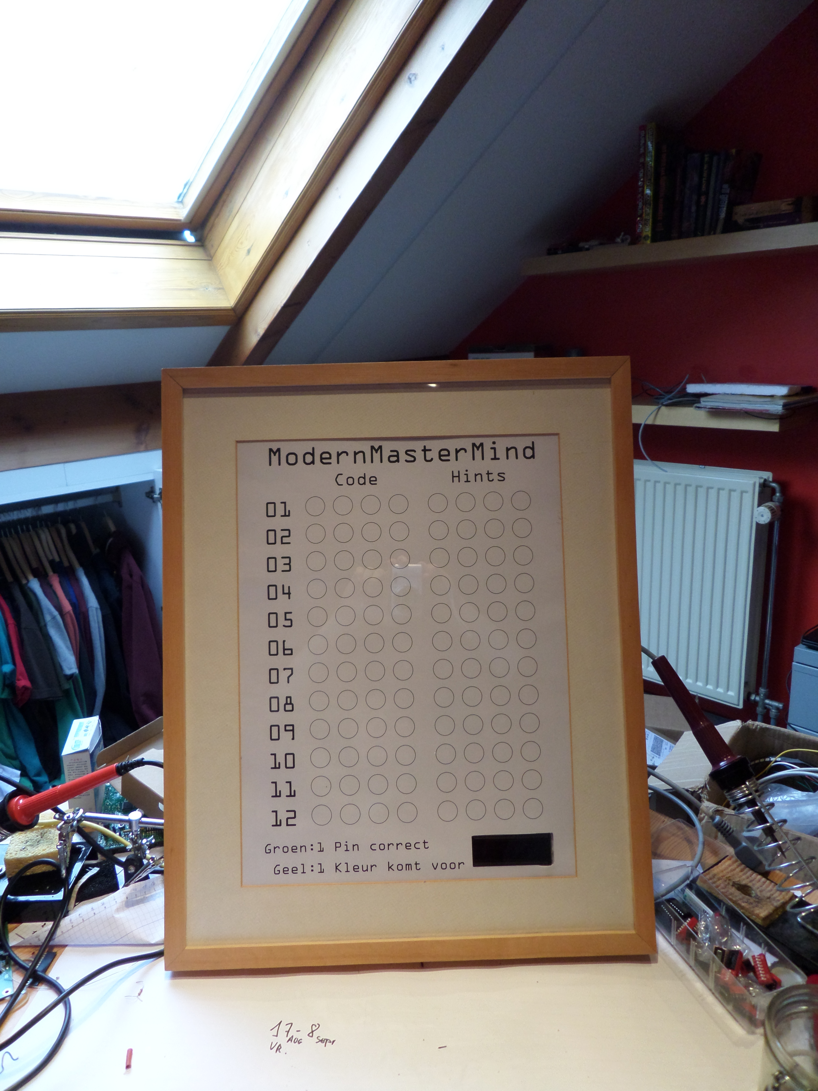
Photos/SAM_8592.JPG
