dries007/ModernMasterMind/Photos/SAM_8593.JPG

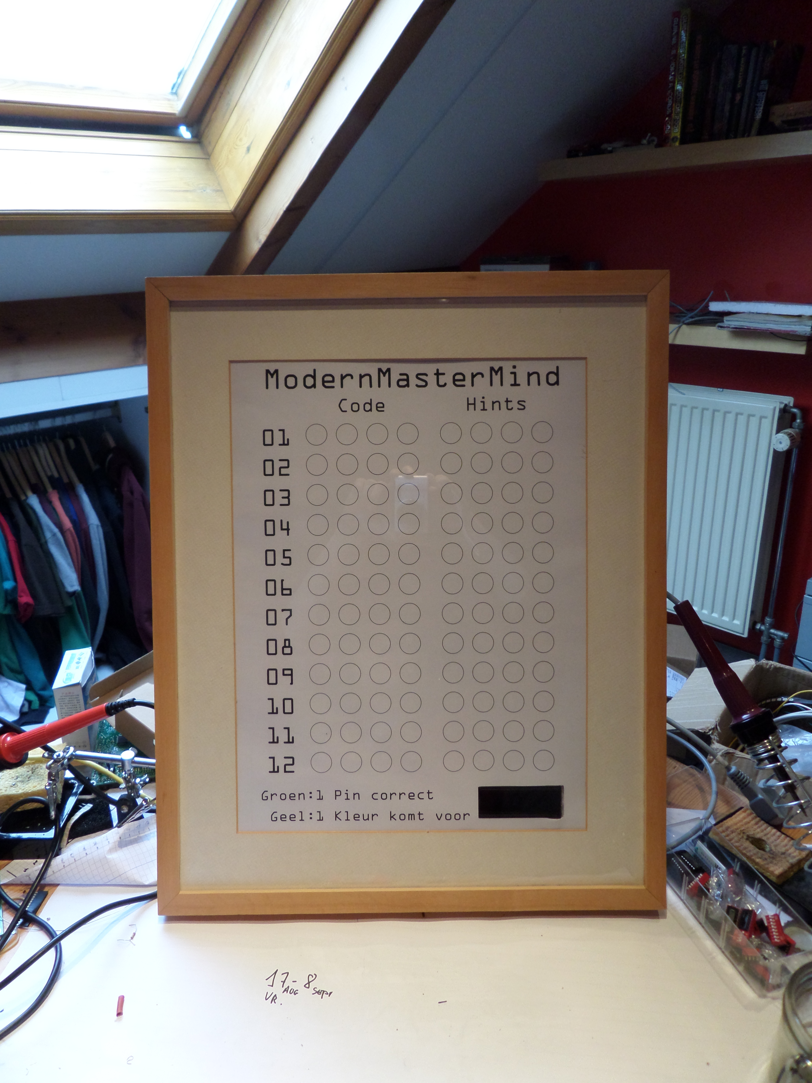
Photos/SAM_8593.JPG
