dries007/ModernMasterMind/Photos/SAM_8594.JPG

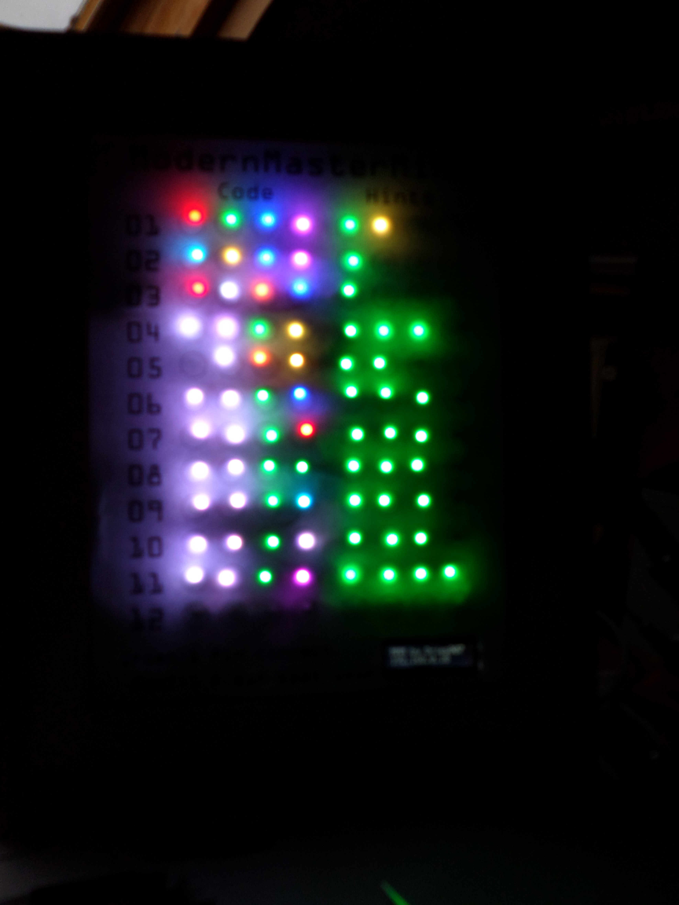
Photos/SAM_8594.JPG
