dries007/ModernMasterMind/Photos/SAM_8595.JPG

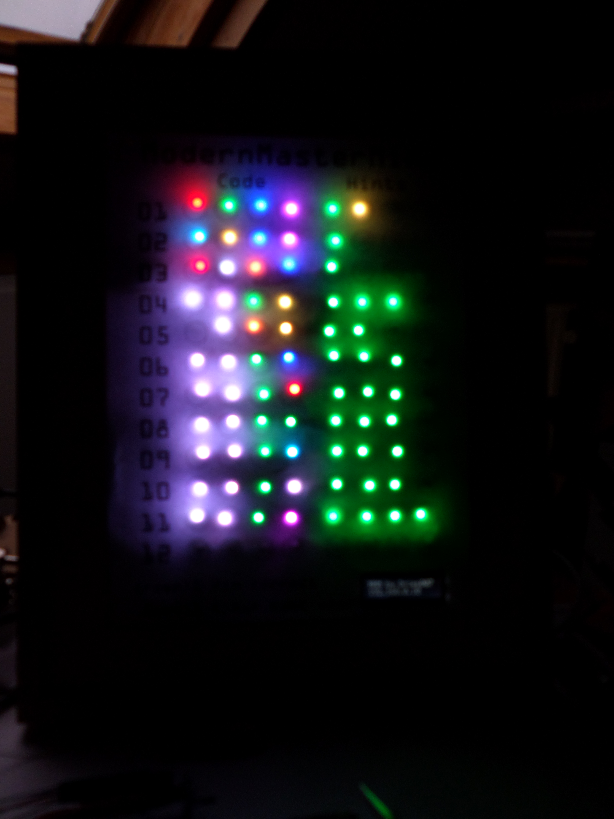
Photos/SAM_8595.JPG
