dries007/ModernMasterMind/Photos/SAM_8597.JPG

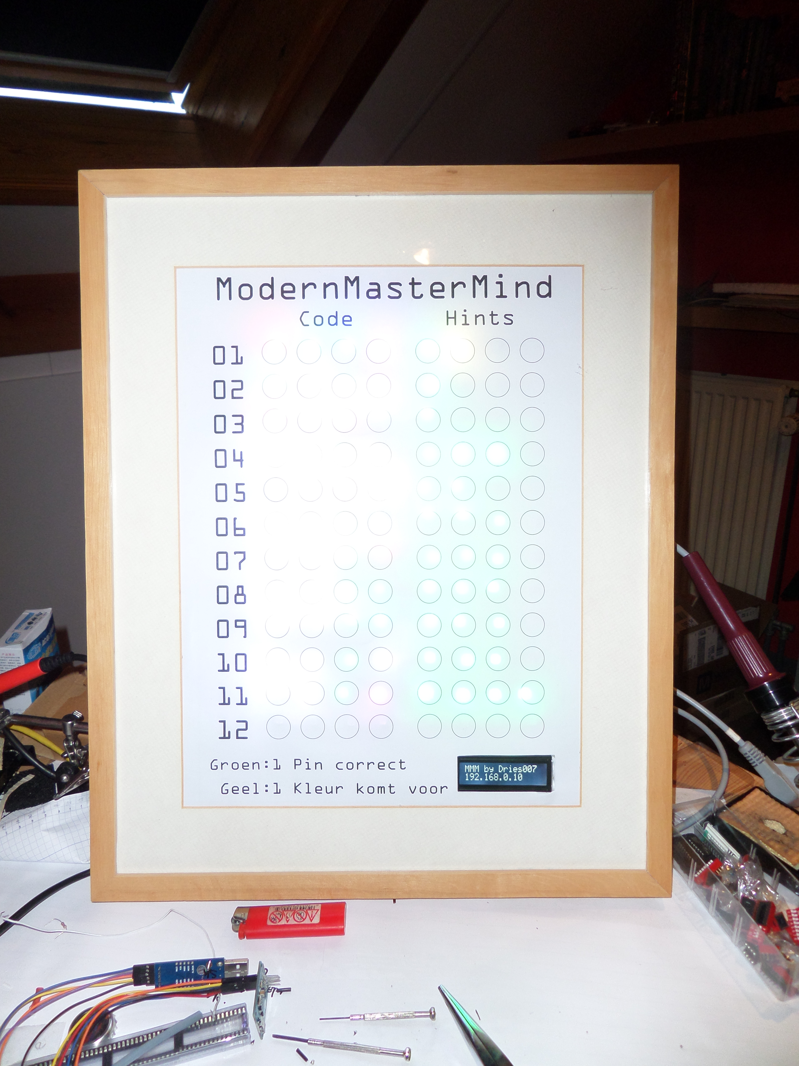
Photos/SAM_8597.JPG
