dries007/ModernMasterMind/Photos/SAM_8598.JPG

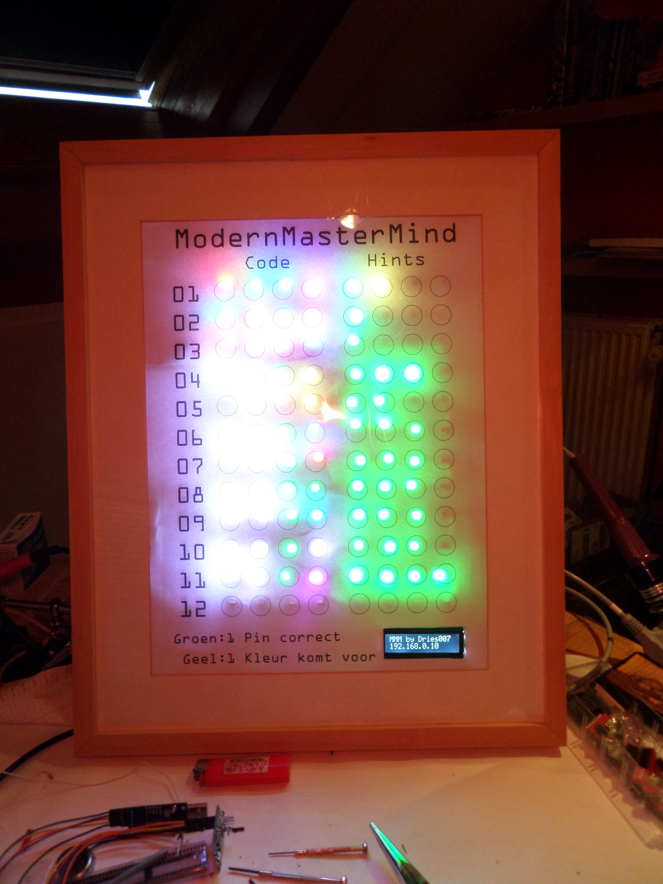
Photos/SAM_8598.JPG
