dries007/ModernMasterMind/Photos/SAM_8599.JPG

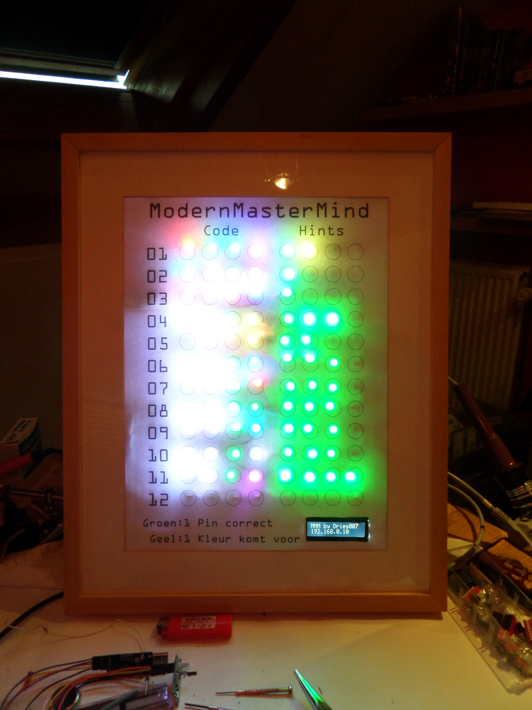
Photos/SAM_8599.JPG
