dries007/ModernMasterMind/Photos/SAM_8600.JPG

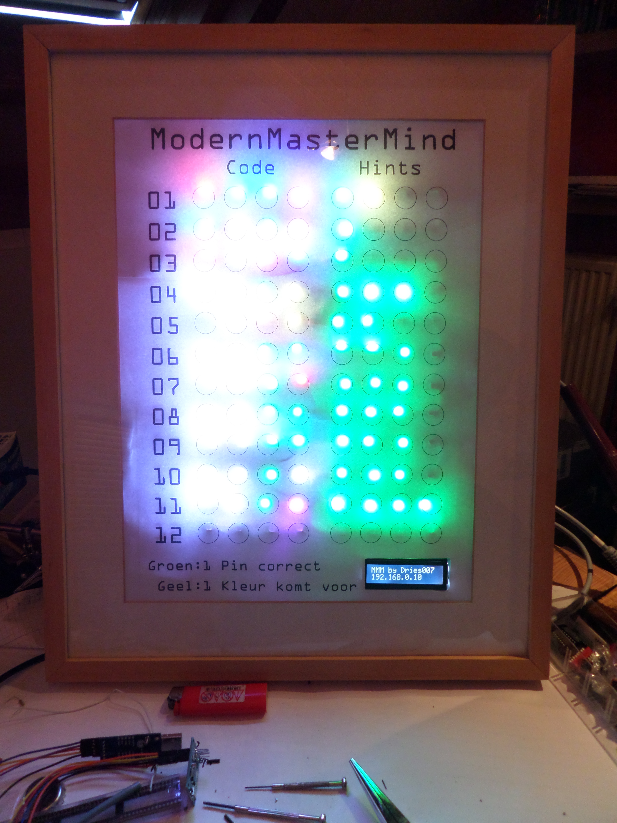
Photos/SAM_8600.JPG
