dries007/ModernMasterMind/Verslag/mainPCB.png

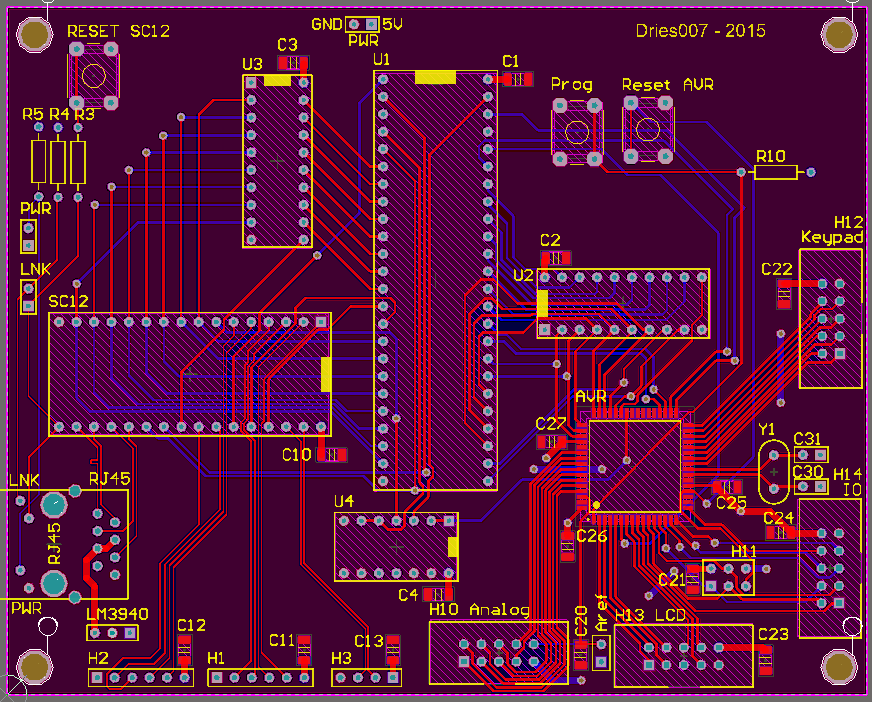
Verslag/mainPCB.png
