dries007/ModernMasterMind/Verslag/schema_lcd.png

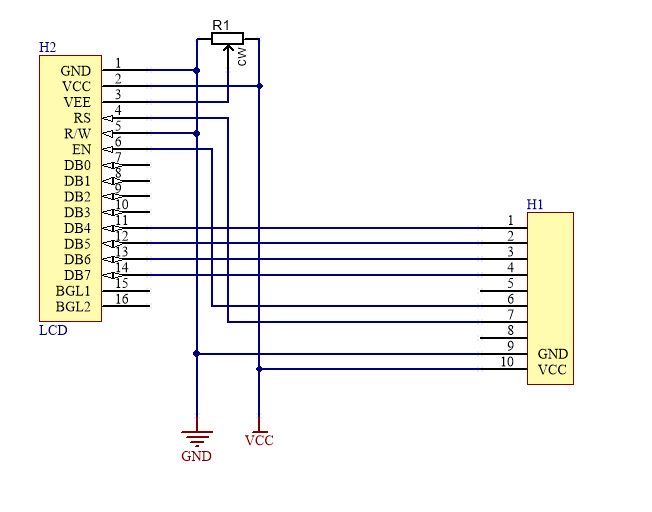
Verslag/schema_lcd.png
