dries007/ModernMasterMind/Verslag/screenshotWebUI.png

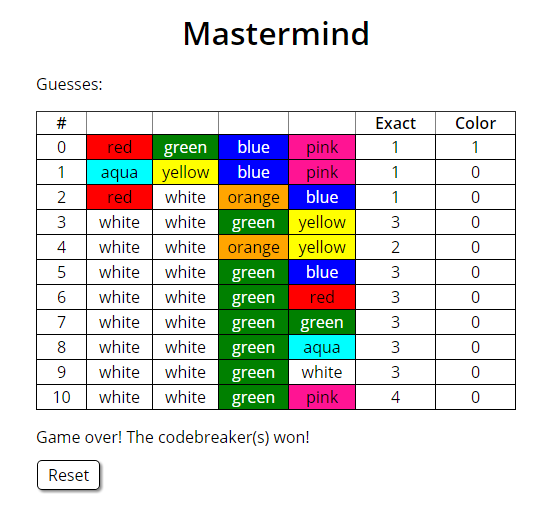
Verslag/screenshotWebUI.png
