dries007/ModernMasterMind/Website/assets/img/dries007.jpg

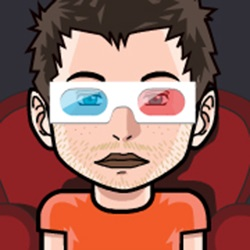
Website/assets/img/dries007.jpg
