dries007/ModernMasterMind/Website/assets/img/fp_bg.jpg

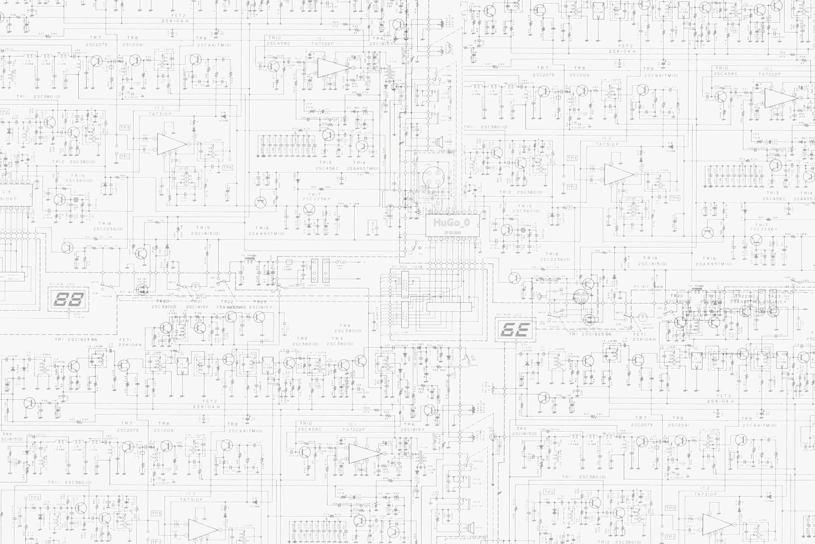
Website/assets/img/fp_bg.jpg
