dries007/ModernMasterMind/Website/assets/img/gantt.png

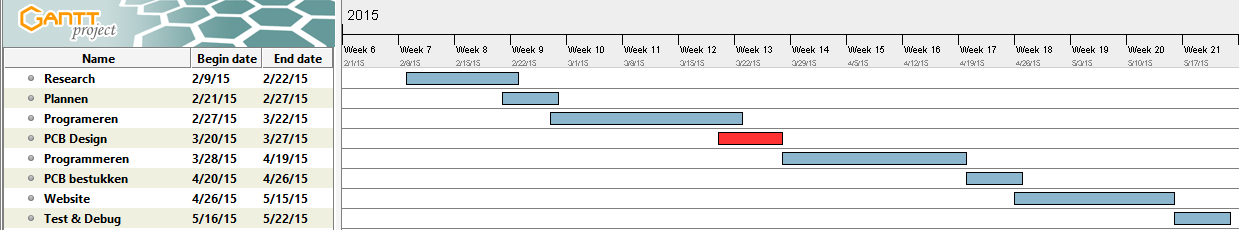
Website/assets/img/gantt.png
