dries007/ModernMasterMind/Website/browsertests/contact/macmav_chrome_36.0.jpg

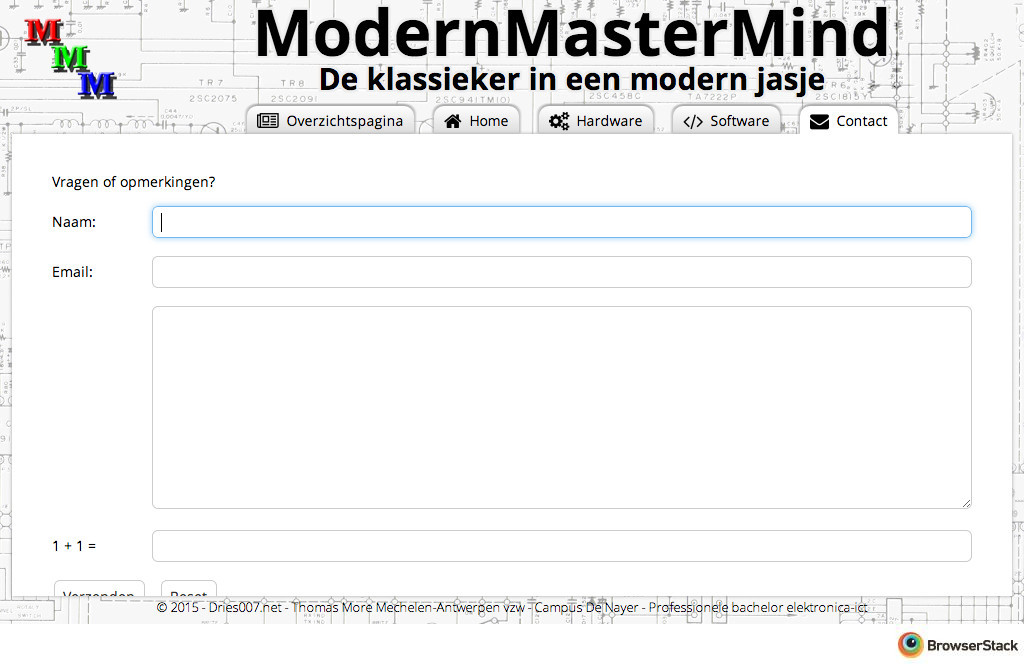
Website/browsertests/contact/macmav_chrome_36.0.jpg
