dries007/ModernMasterMind/Website/browsertests/contact/macyos_safari_8.0.jpg

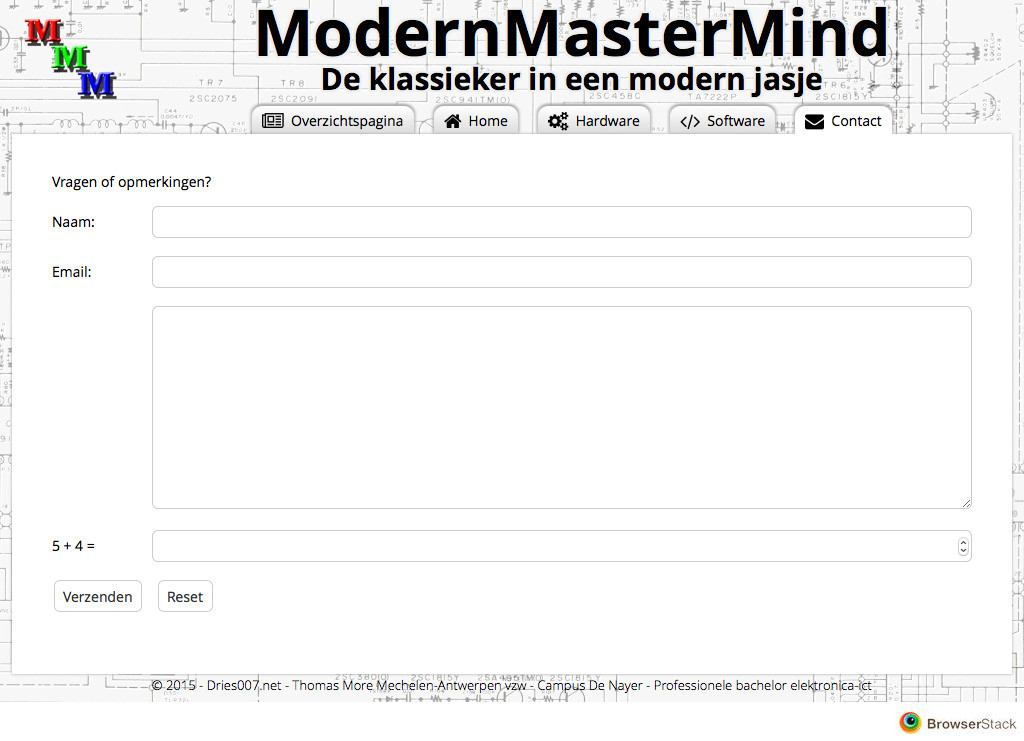
Website/browsertests/contact/macyos_safari_8.0.jpg
