dries007/ModernMasterMind/Website/browsertests/contact/win7_ie_9.0.jpg

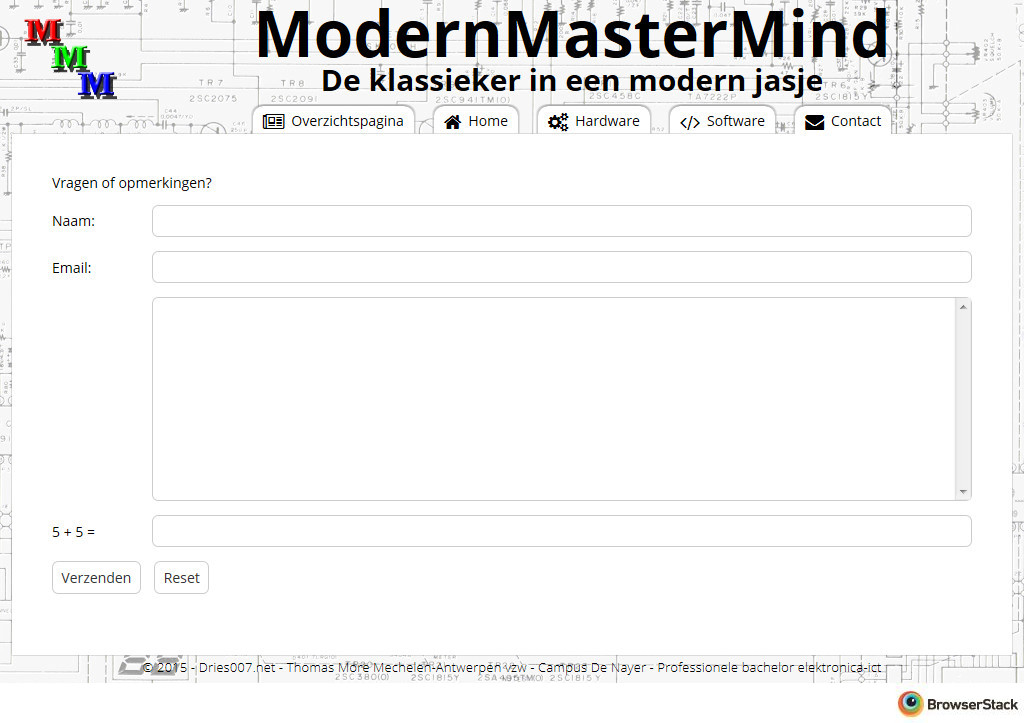
Website/browsertests/contact/win7_ie_9.0.jpg
