dries007/ModernMasterMind/Website/browsertests/hardware/macmav_chrome_36.0.jpg

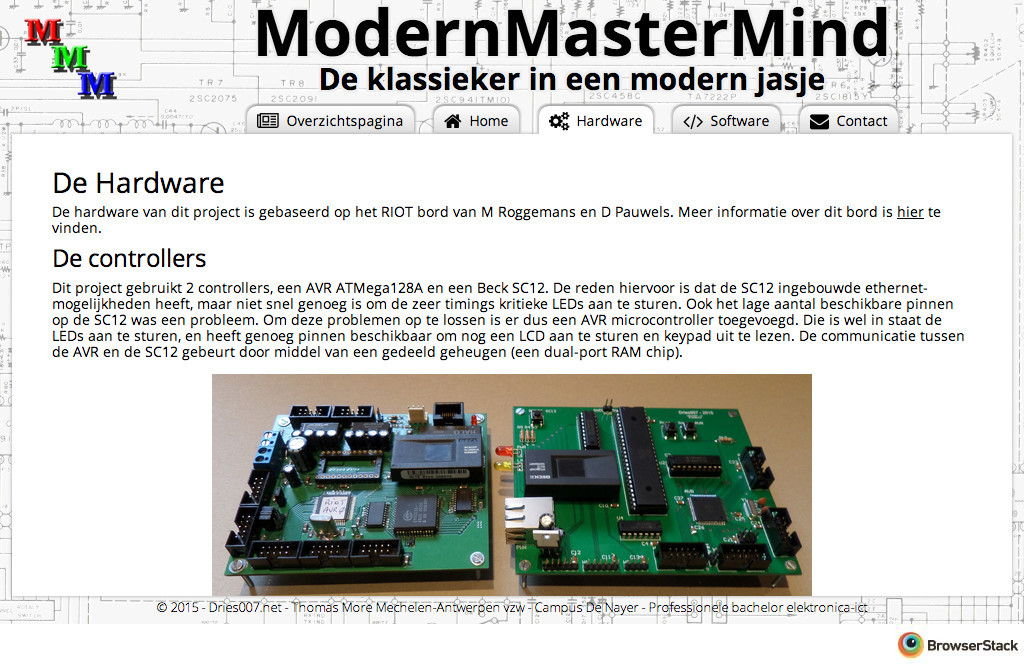
Website/browsertests/hardware/macmav_chrome_36.0.jpg
