dries007/ModernMasterMind/Website/browsertests/hardware/macyos_opera_12.15.jpg

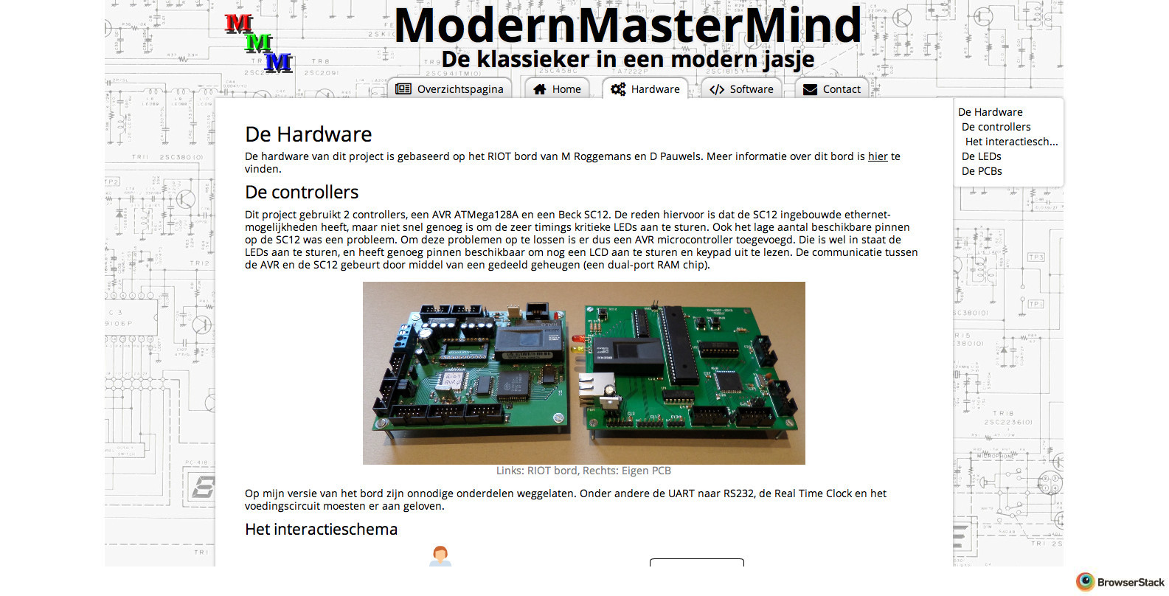
Website/browsertests/hardware/macyos_opera_12.15.jpg
