dries007/ModernMasterMind/Website/browsertests/hardware/macyos_safari_8.0.jpg

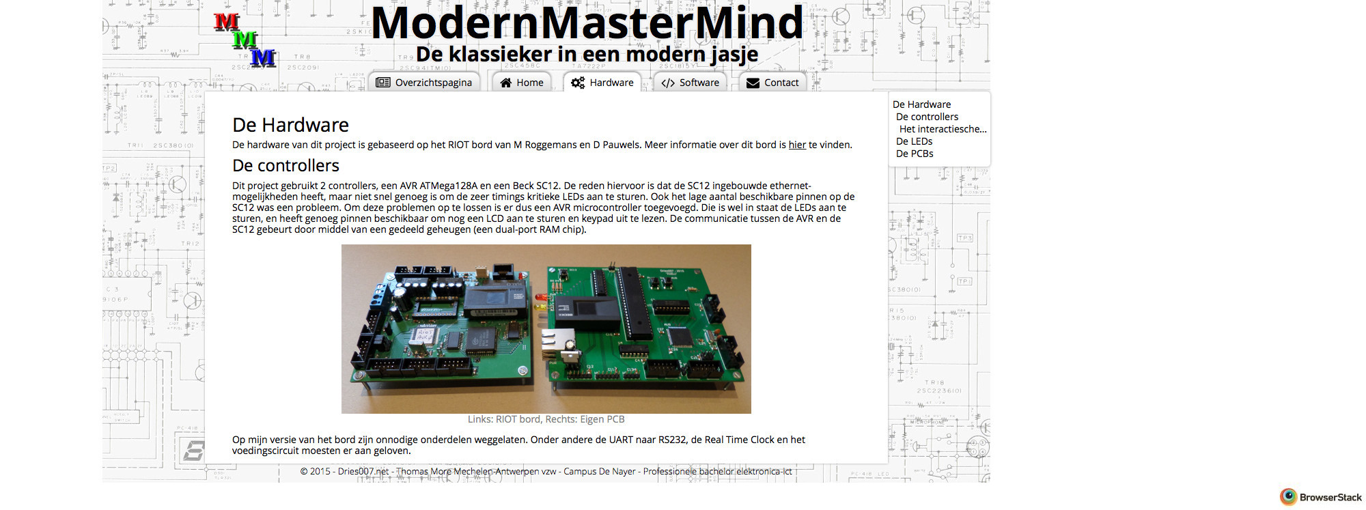
Website/browsertests/hardware/macyos_safari_8.0.jpg
