dries007/ModernMasterMind/Website/browsertests/hardware/win7_ie_9.0.jpg

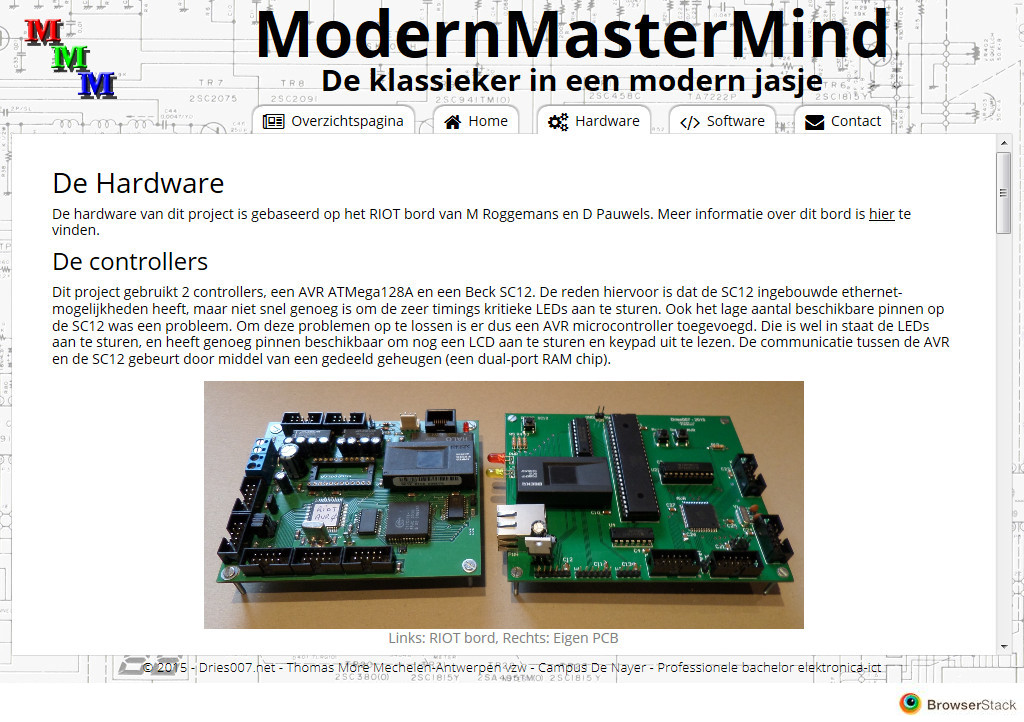
Website/browsertests/hardware/win7_ie_9.0.jpg
