dries007/ModernMasterMind/Website/browsertests/hardware/win8.1_firefox_30.0.jpg

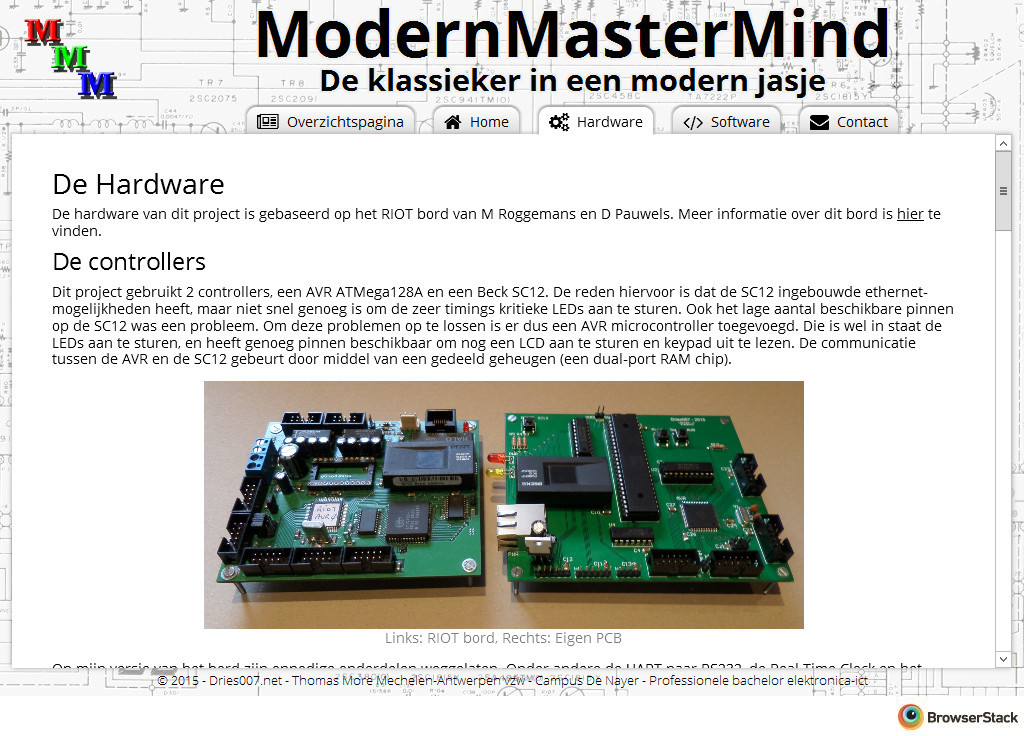
Website/browsertests/hardware/win8.1_firefox_30.0.jpg
