dries007/ModernMasterMind/Website/browsertests/hardware/win8_ie_10.0.jpg

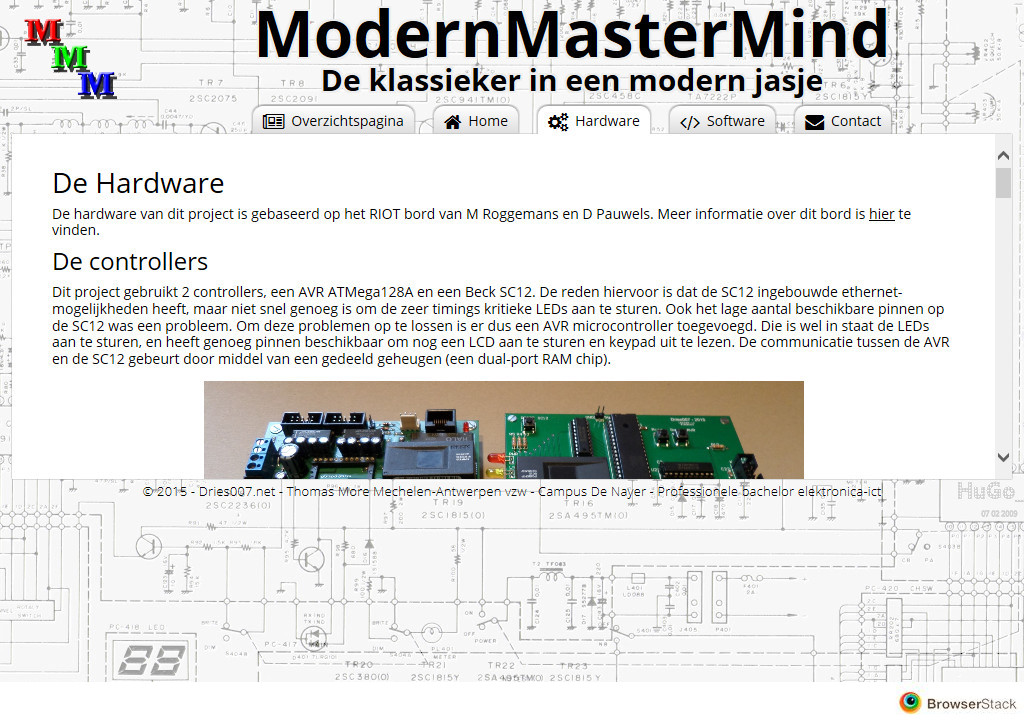
Website/browsertests/hardware/win8_ie_10.0.jpg
