dries007/ModernMasterMind/Website/browsertests/home2/macmav_chrome_36.0.png

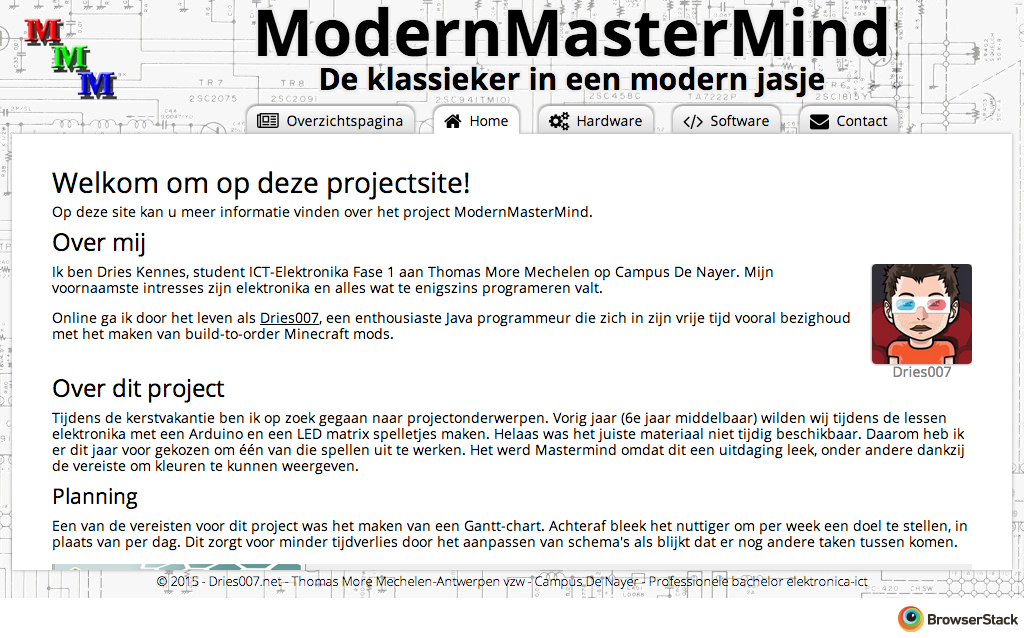
Website/browsertests/home2/macmav_chrome_36.0.png
