dries007/ModernMasterMind/Website/browsertests/home2/macyos_opera_12.15.png

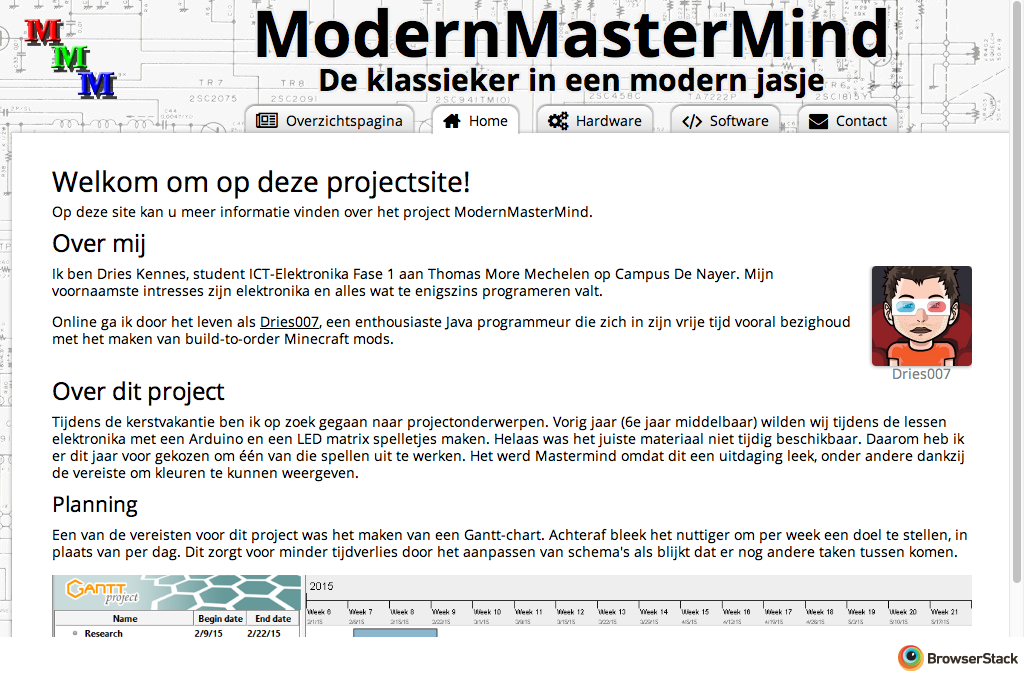
Website/browsertests/home2/macyos_opera_12.15.png
