dries007/ModernMasterMind/Website/browsertests/home2/macyos_safari_8.0.jpg

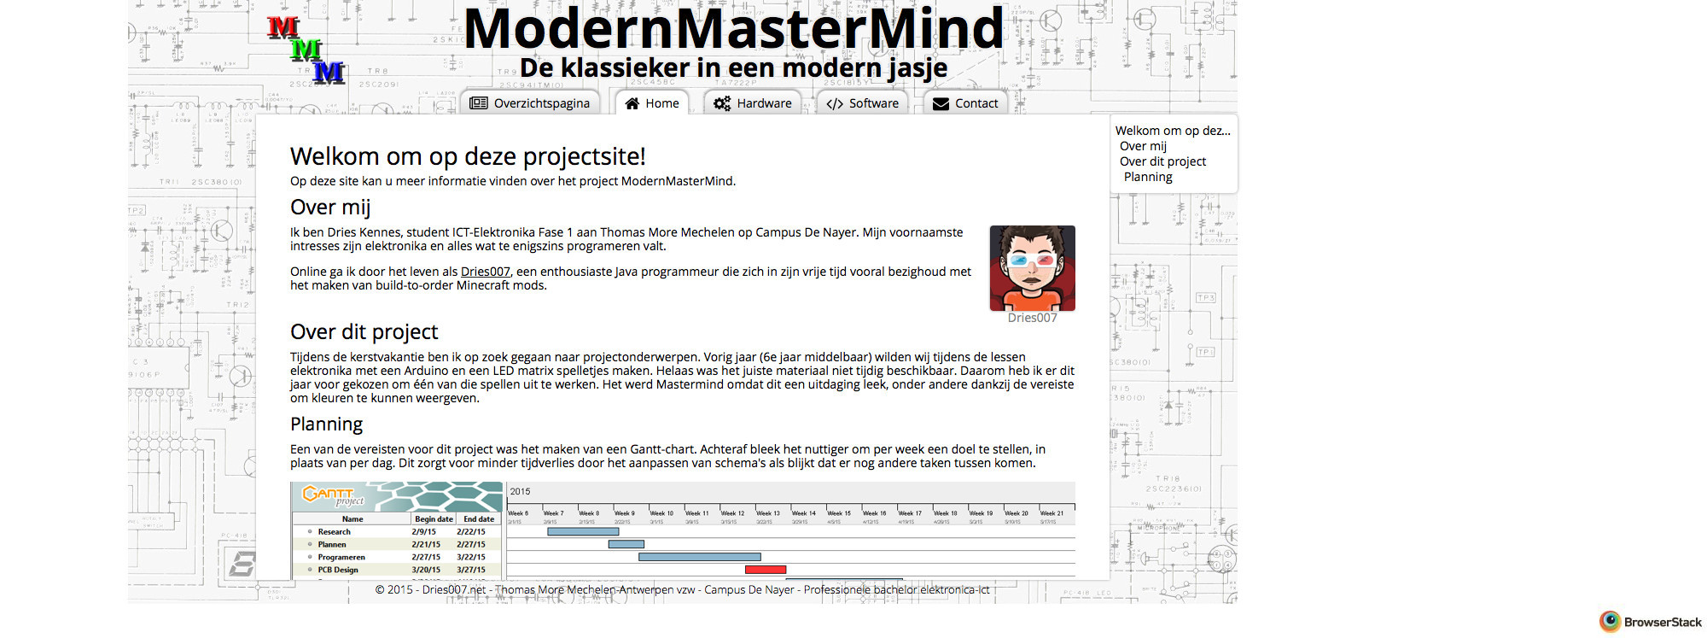
Website/browsertests/home2/macyos_safari_8.0.jpg
