dries007/ModernMasterMind/Website/browsertests/home2/win7_ie_9.0.png

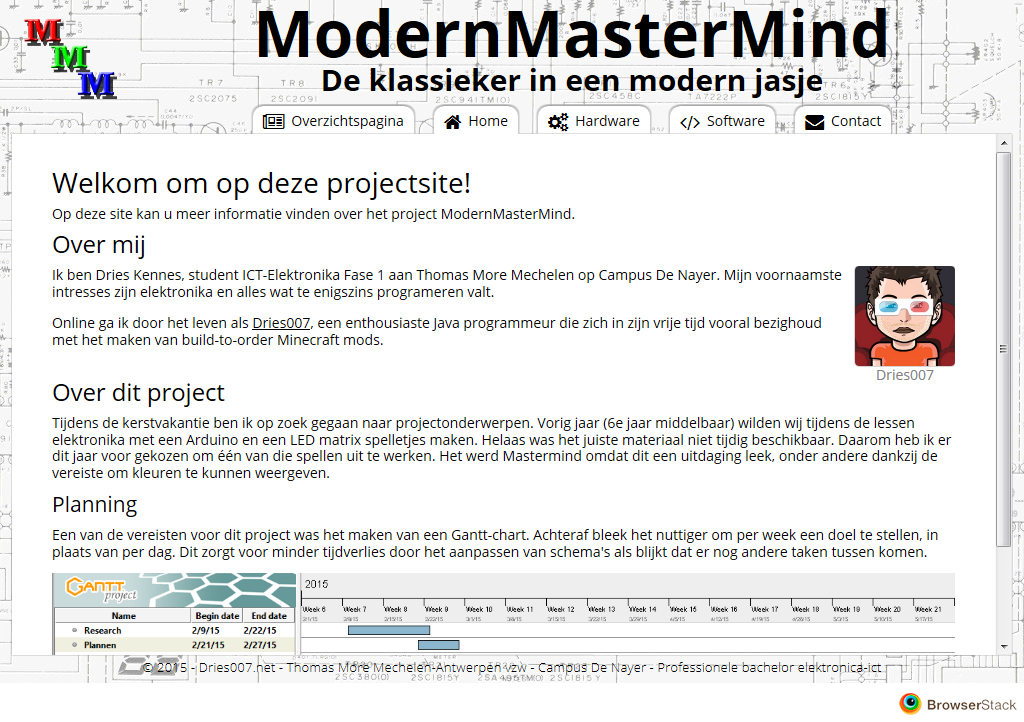
Website/browsertests/home2/win7_ie_9.0.png
