dries007/ModernMasterMind/Website/browsertests/home2/win8.1_firefox_30.0.jpg

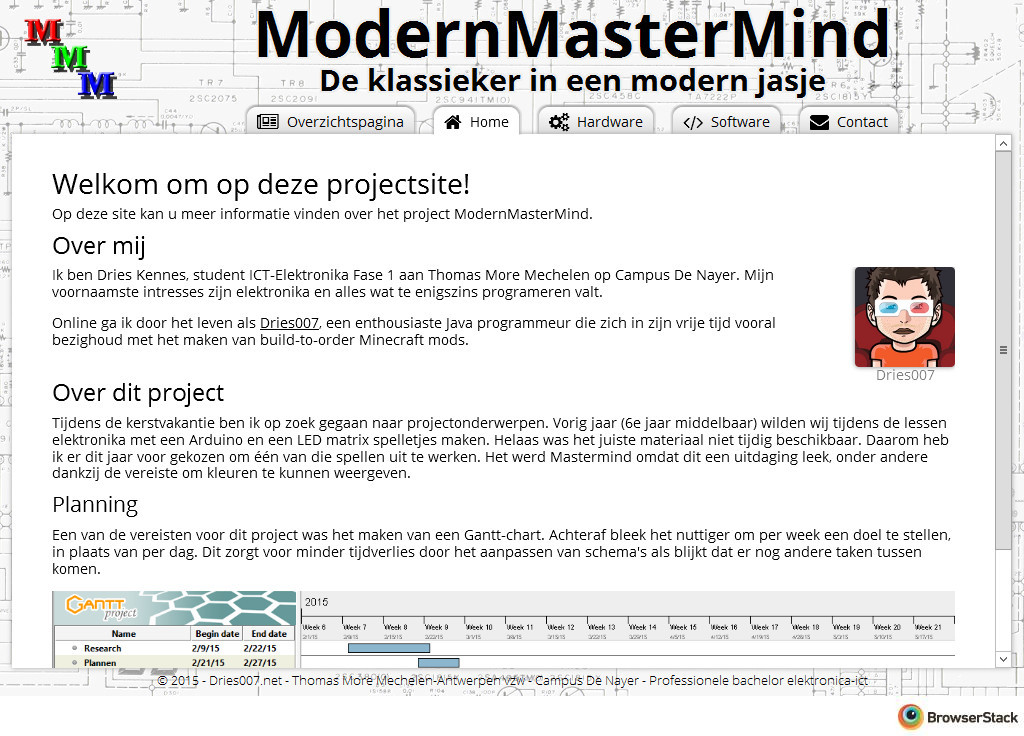
Website/browsertests/home2/win8.1_firefox_30.0.jpg
