dries007/ModernMasterMind/Website/browsertests/home2/win8.1_ie_11.0.png

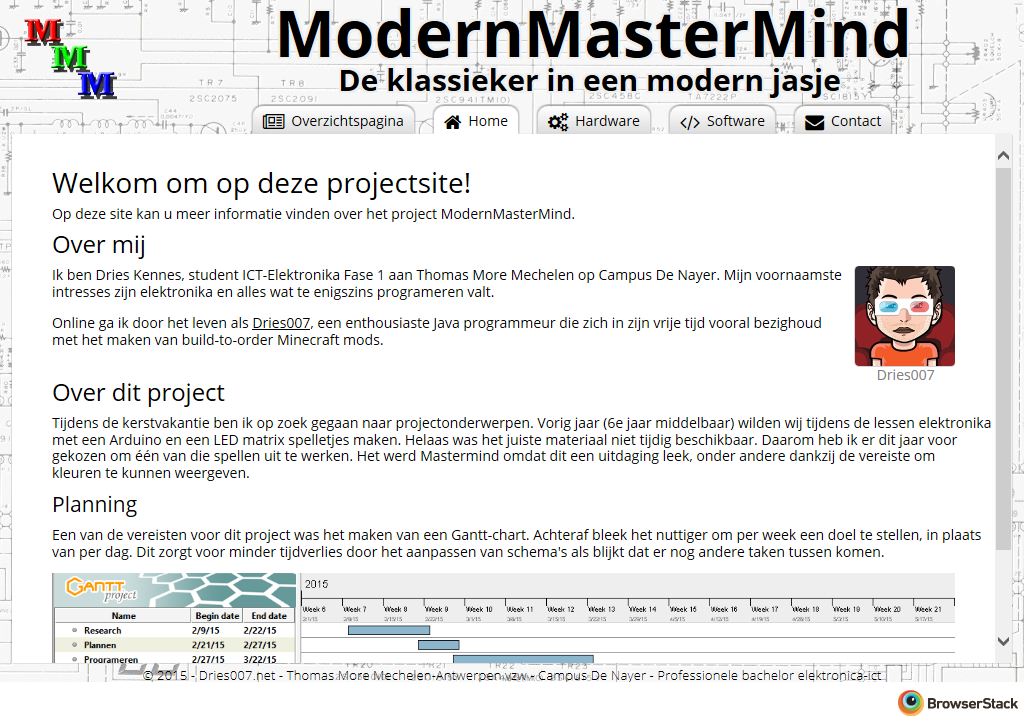
Website/browsertests/home2/win8.1_ie_11.0.png
