dries007/ModernMasterMind/Website/browsertests/index/macmav_chrome_36.0.jpg

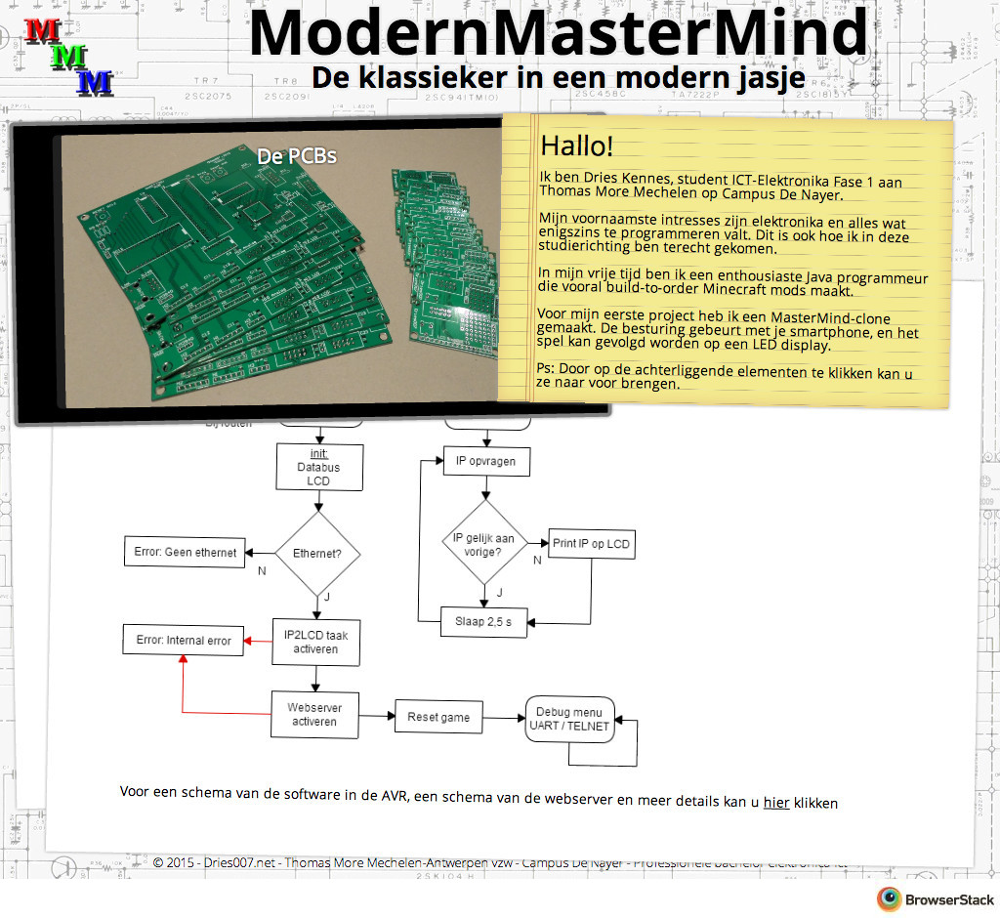
Website/browsertests/index/macmav_chrome_36.0.jpg
