dries007/ModernMasterMind/Website/browsertests/index/macyos_opera_12.15.jpg

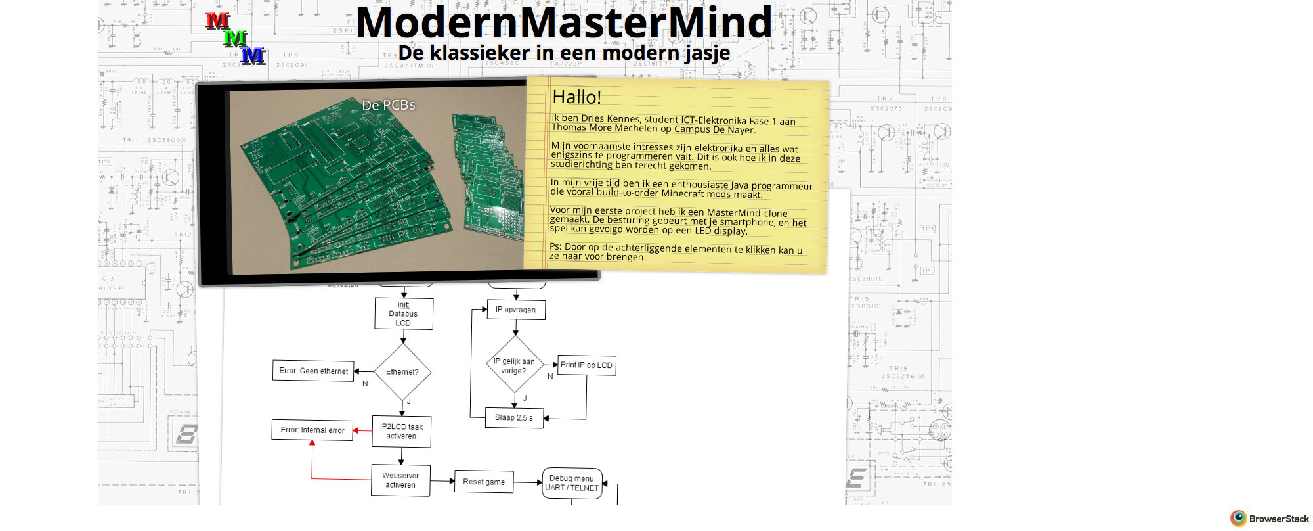
Website/browsertests/index/macyos_opera_12.15.jpg
