dries007/ModernMasterMind/Website/browsertests/index/macyos_safari_8.0.jpg

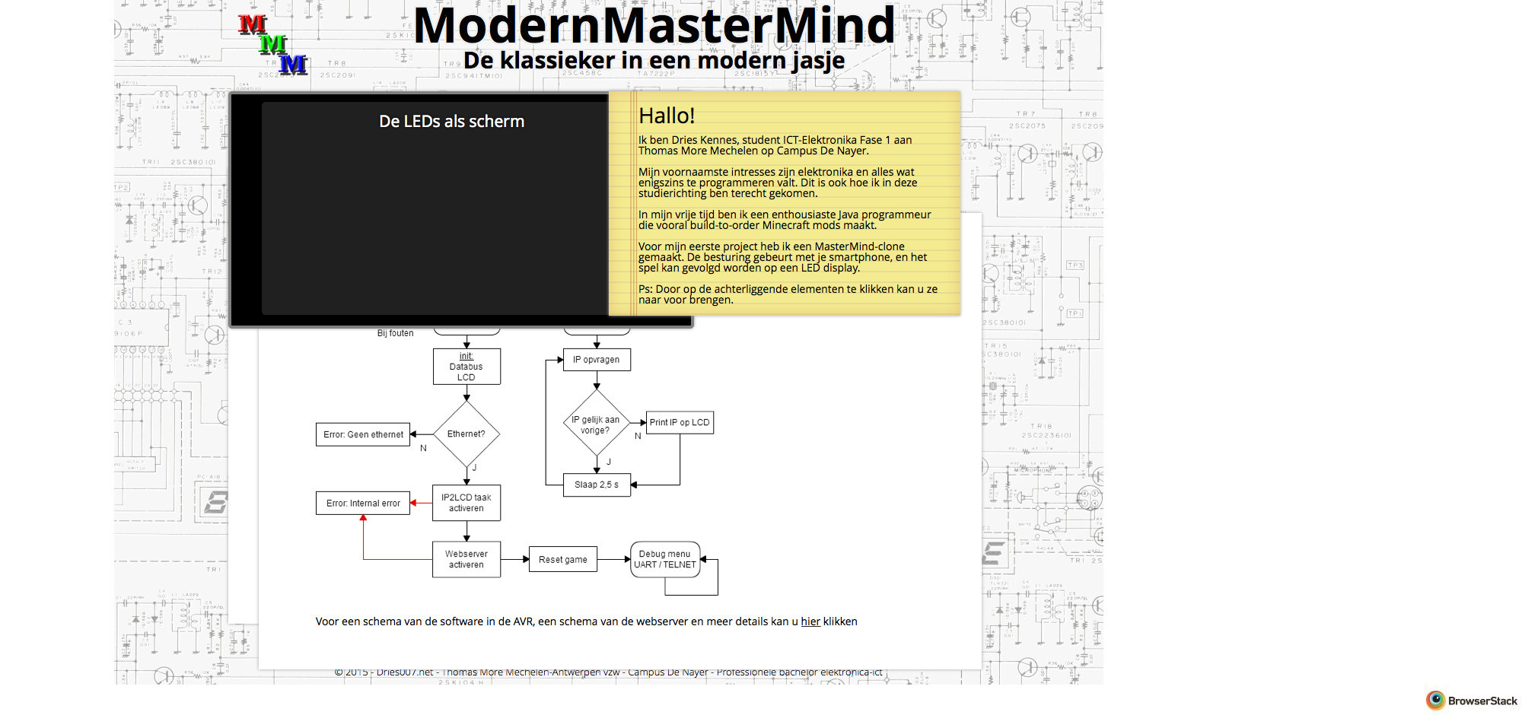
Website/browsertests/index/macyos_safari_8.0.jpg
