dries007/ModernMasterMind/Website/browsertests/index/win7_ie_9.0.jpg

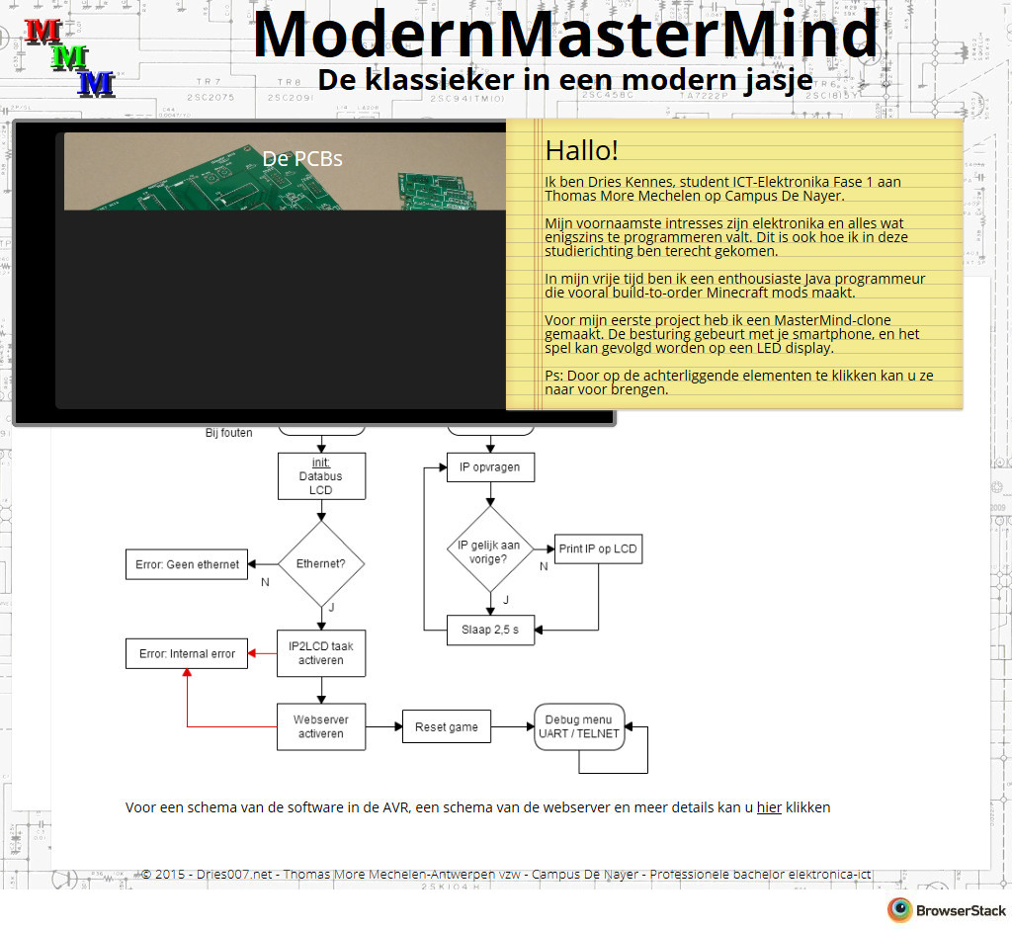
Website/browsertests/index/win7_ie_9.0.jpg
