dries007/ModernMasterMind/Website/browsertests/index/win8.1_ie_11.0.jpg

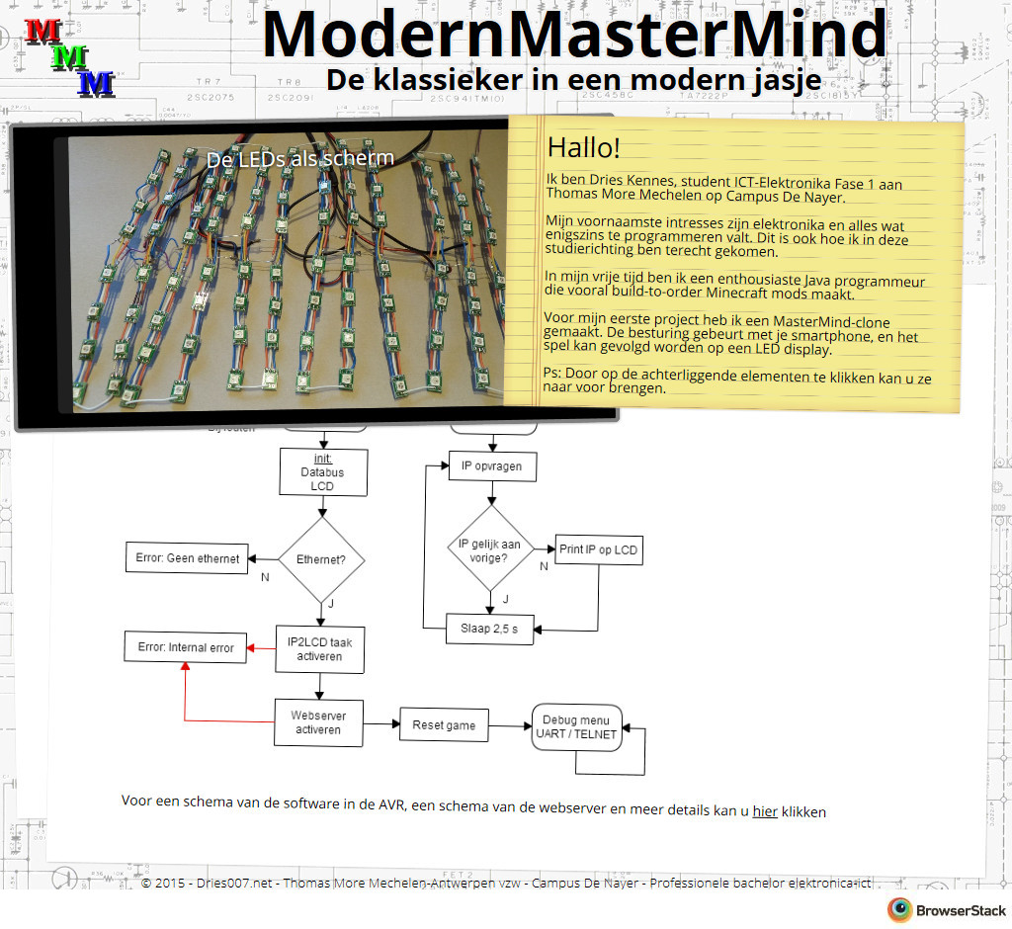
Website/browsertests/index/win8.1_ie_11.0.jpg
