dries007/ModernMasterMind/Website/browsertests/software/macmav_chrome_36.0.png

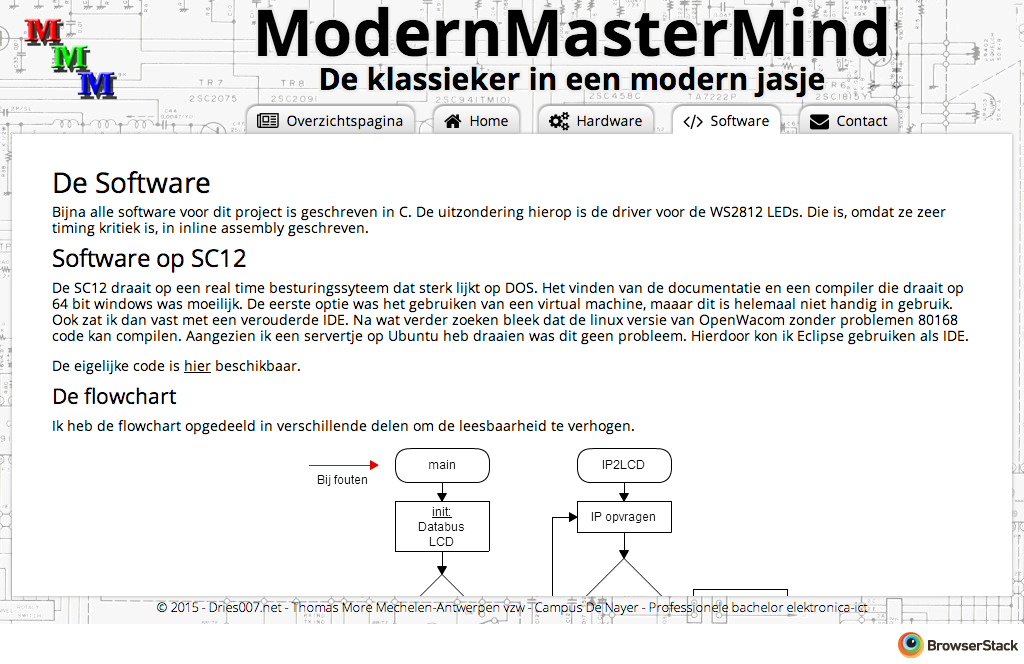
Website/browsertests/software/macmav_chrome_36.0.png
