dries007/ModernMasterMind/Website/browsertests/software/macyos_opera_12.15.png

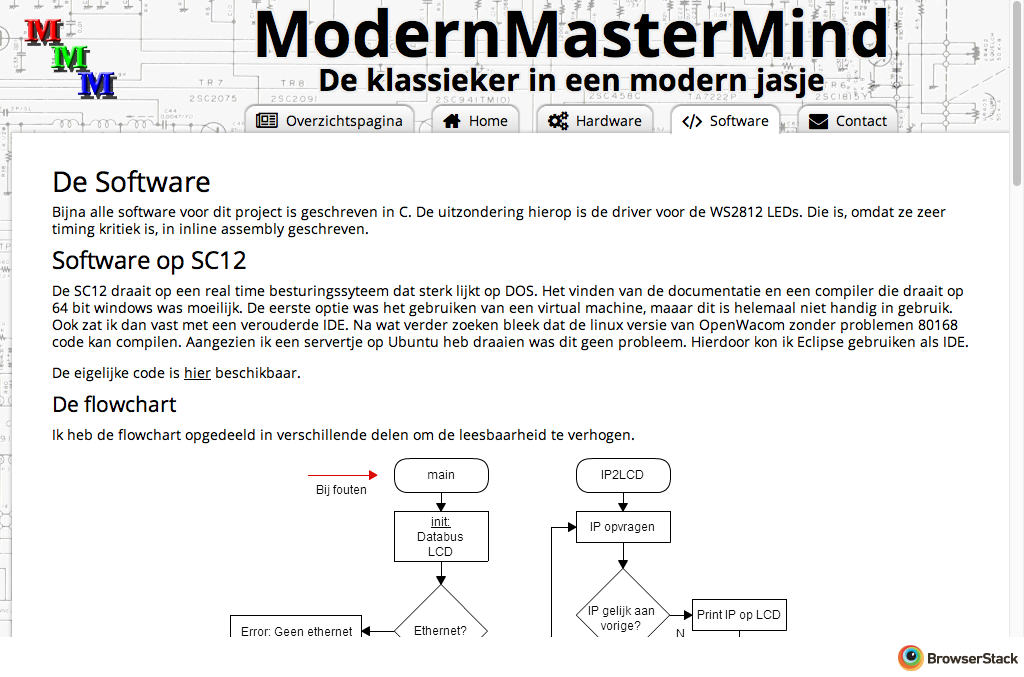
Website/browsertests/software/macyos_opera_12.15.png
