dries007/ModernMasterMind/Website/browsertests/software/macyos_safari_8.0.jpg

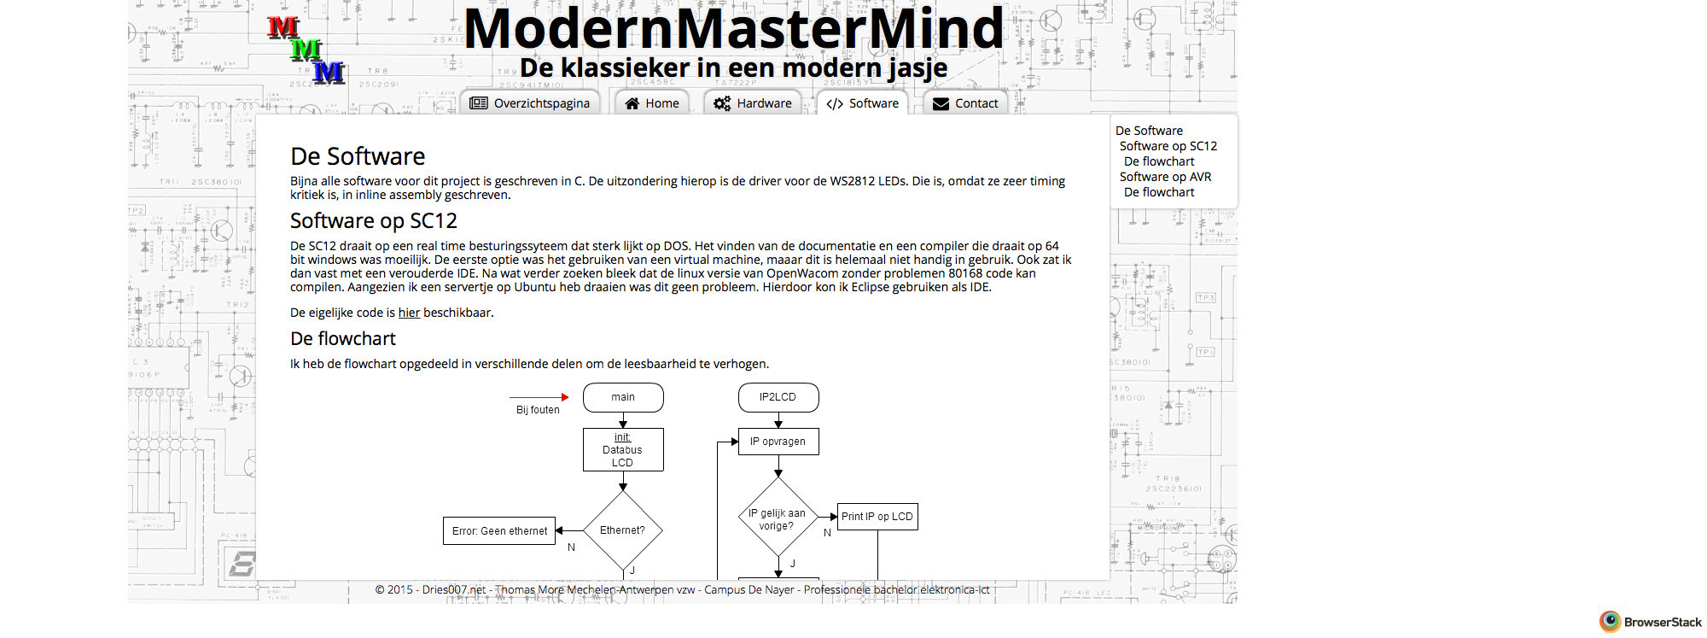
Website/browsertests/software/macyos_safari_8.0.jpg
