dries007/ModernMasterMind/Website/browsertests/software/win7_ie_9.0.png

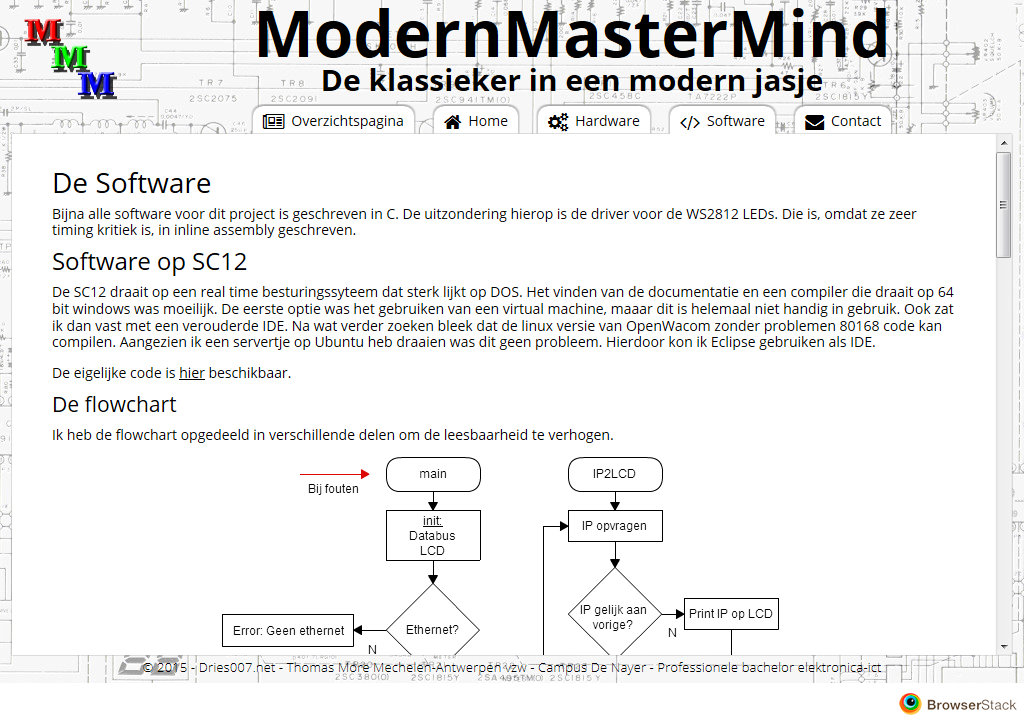
Website/browsertests/software/win7_ie_9.0.png
