dries007/ModernMasterMind/Website/browsertests/software/win8.1_firefox_30.0.png

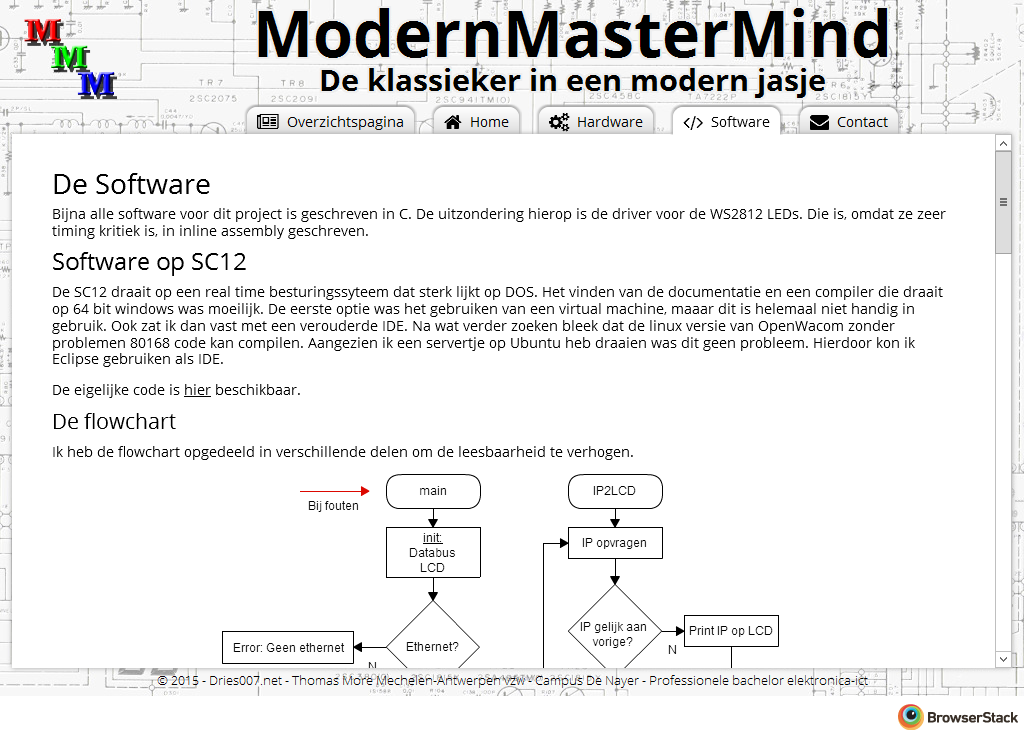
Website/browsertests/software/win8.1_firefox_30.0.png
