dries007/ModernMasterMind/Verslag/Project1_Mastermind.pdf

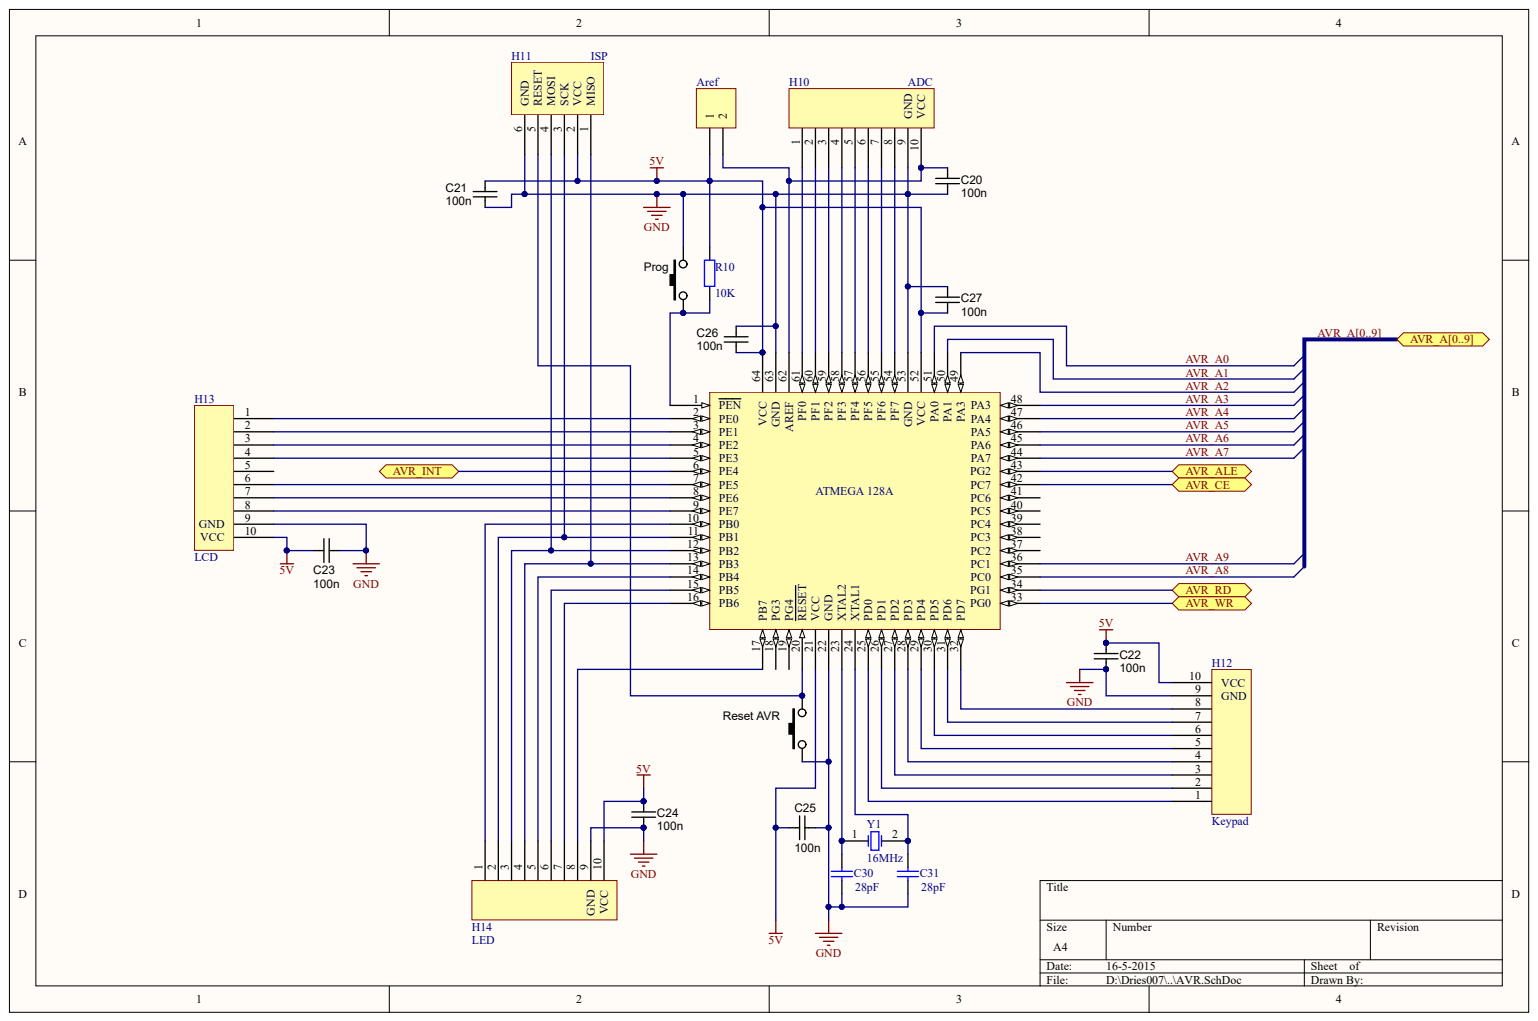
[picture p125: page 1]

MISO 1 VCC 2 SCK 3 MOSI 4 RESET 5 GND 6 H11 ISP

AVR_A1
AVR_A2

PA3 49 PA1 50 PA0 51 VCC 52 GND 53 PF7 54 PF6 55 PF5 56 PF4 57 PF3 58 PF2 59 PF1 60 PF0 61 AREF 62 GND 63 VCC 64

2 | PE1 3 | AVR_A5
3 | PE2 4 | AVR_A6
4 | PE3 5 | AVR_A7

7 | PE6 8
8 | PE7 9

PB1 11
PB2 12
PB3 13
PB4 14
PB5 15
PB6 16

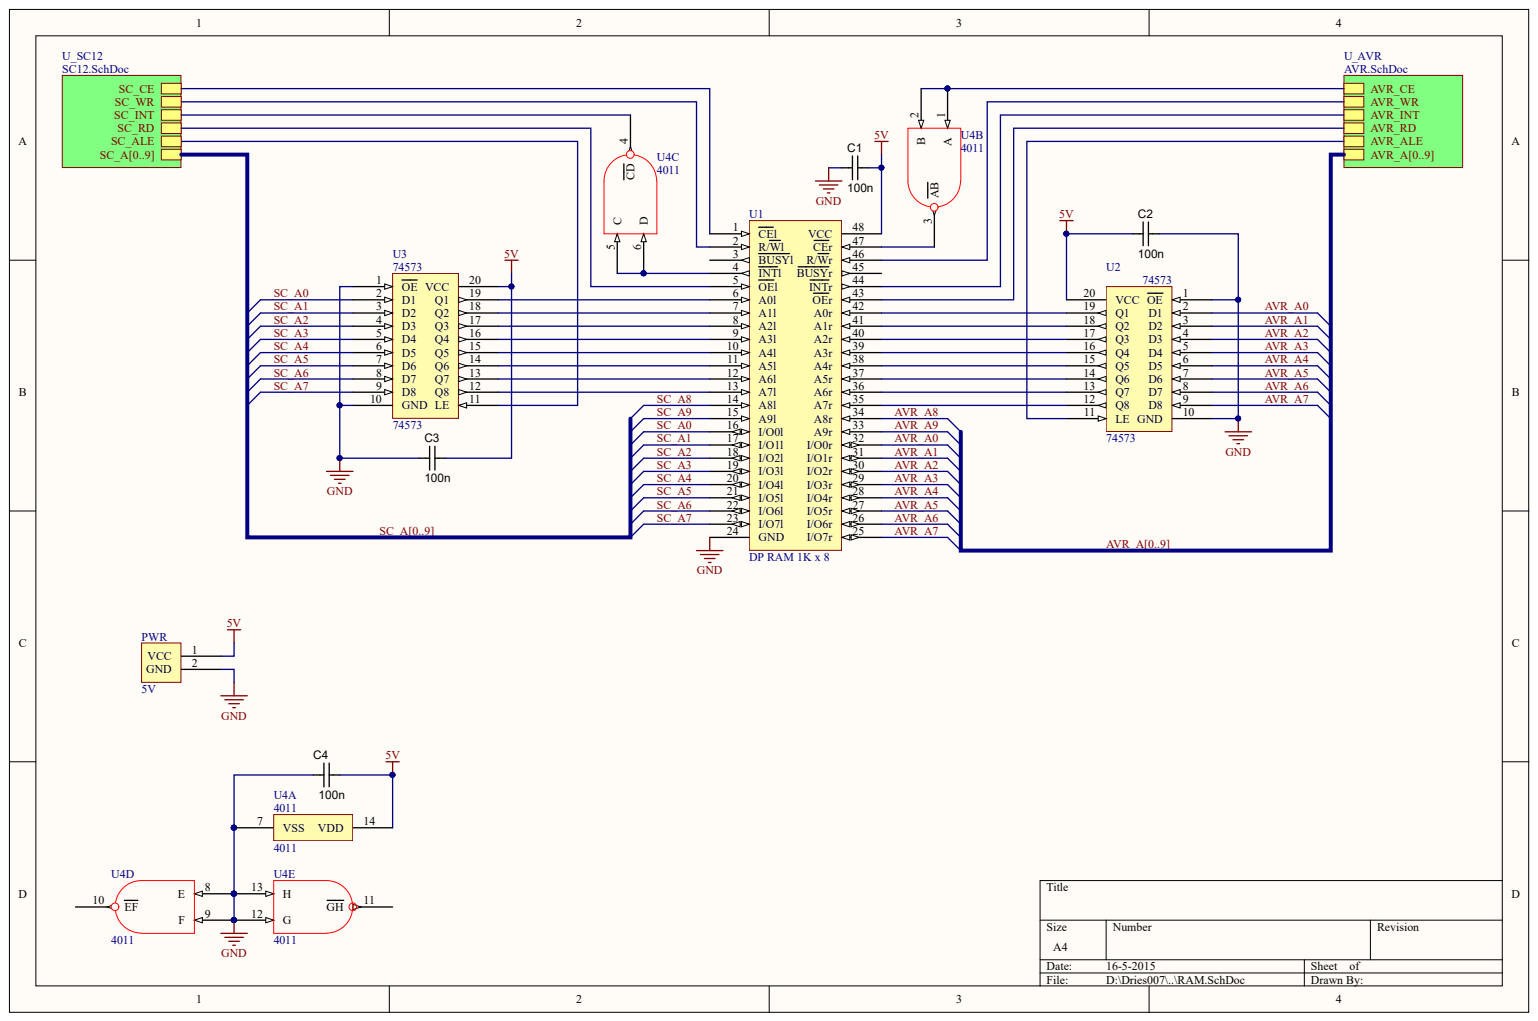
[picture p126: page 2]

INTl 4 | | | | U2 | 74573

SC_A0 SC_A1 SC_A2 SC_A3 SC_A4 SC_A5 SC_A6 SC_A7 | | GND 10 D1 2 D2 3 D3 4 D4 5 D5 6 D6 7 D7 8 D8 9 | LE | | | | | A0l 6

11 Q8 12 Q7 13 Q6 14 Q5 15 Q4 16 Q3 17 Q2 18 Q1 19 VCC 20 | | | | A2l 8

A1l 7 | GND D1 D2 D3 D4 D5 D6 D7 D8 | 10 LE 11 2 3 4 5 6 7 8 9 | AVR_A0 AVR_A1 AVR_A2 AVR_A3 AVR_A4 AVR_A5 AVR_A6 AVR_A7

A3l 9 | Q8 12 Q7 13 Q6 14 Q5 15 Q4 16 Q3 17 Q2 18 Q1 19 VCC 20

A4l 10
A5l 11
A6l 12
A7l 13

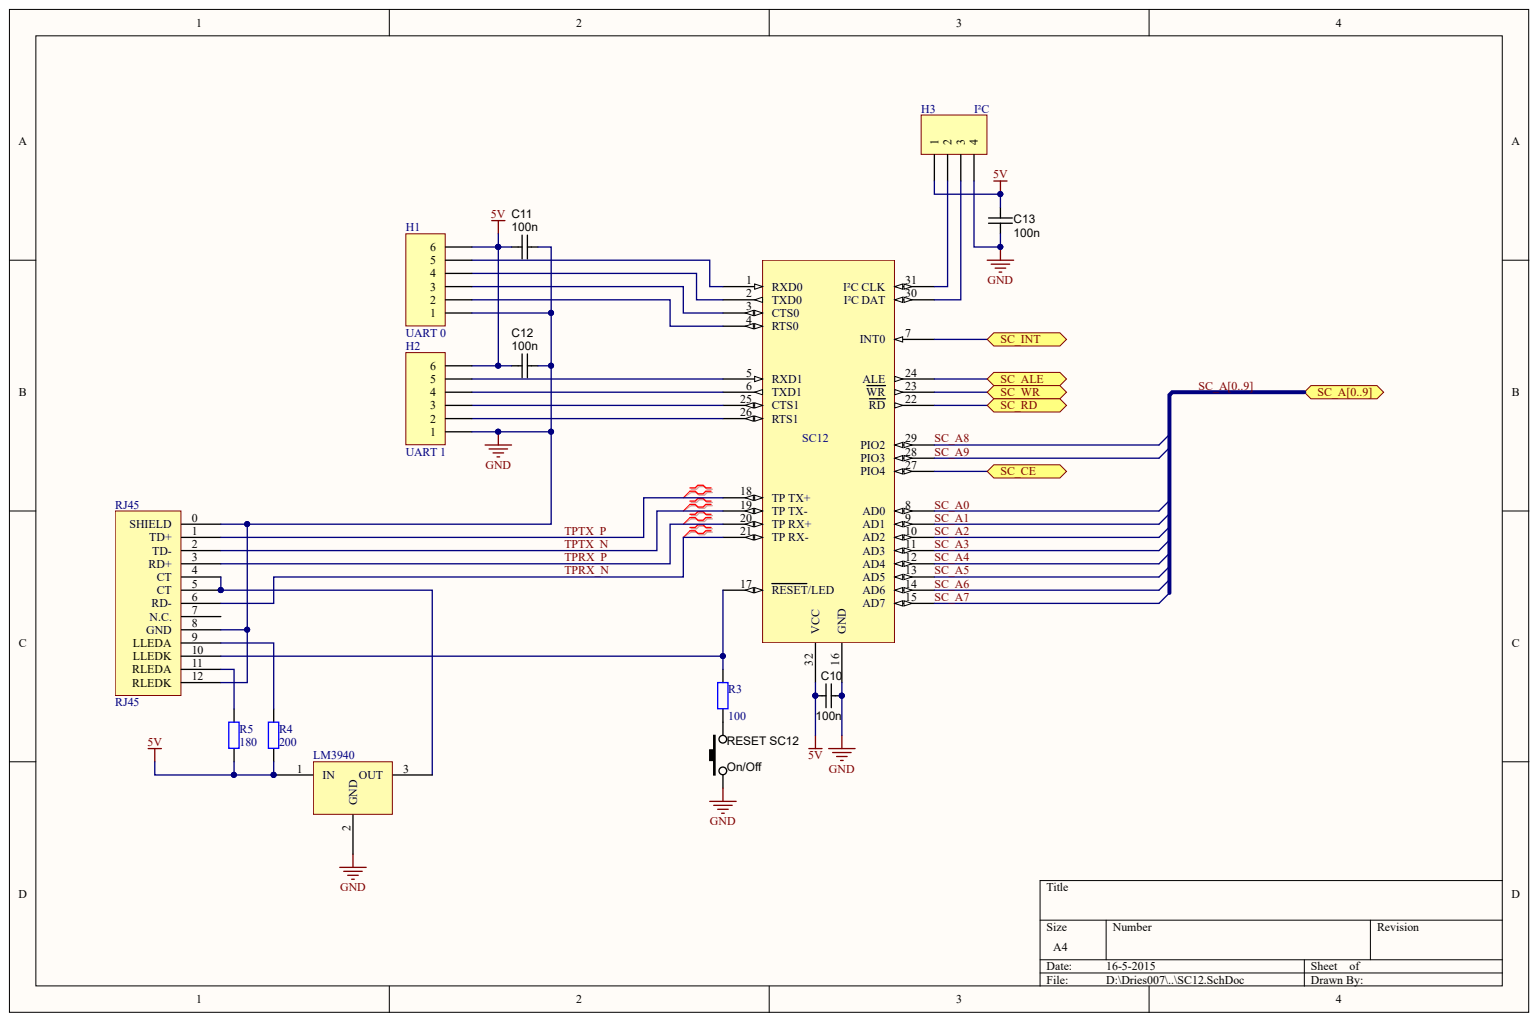
[picture p127: page 3]

CTS1 25 RTS1 26

1 | TPTX_P | | TP RX- 21
2 | TPTX_N | | | RESET/LED 17
3 | TPRX_P
4 | TPRX_N
