dries007/ModernMasterMind/mastermind2.pdf

# ModernMasterMind

01

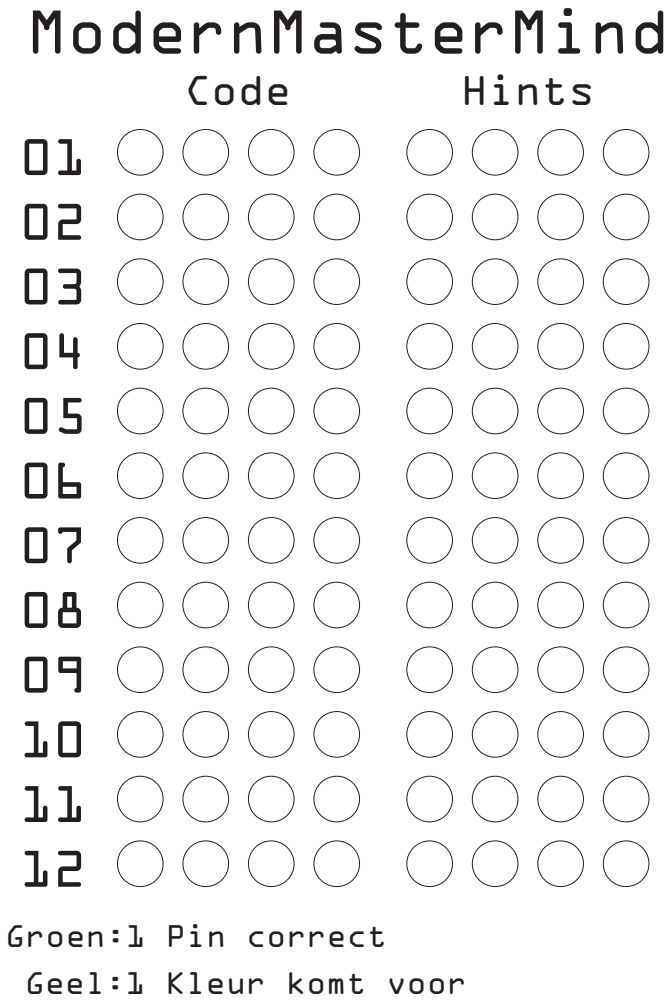
[picture p128: page 1]
Code; Hints

Groen:1 Pin correct
Geel:1 Kleur komt voor
