dries007/ModernMasterMind/(notices)

Notices in the files:
Website/hardware.html:
License: https://github.com/dries007/ModernMasterMind/blob/master/LICENSE
